audiodestrukt/freedj-esp/p4/deck/hardware/cad/renders/freedj_esp/INDEX.md

# freedj-esp render log

- 0001-first-design-hero.jpg: 2026-10-31: first design, 3.5" LCD, 100 mm jog, CUE/PLAY, 45 mm pitch
- 0002-first-design-front.jpg: 2026-10-31: same, from the front
- 0003-first-design-jog-section.jpg: 2026-10-31: section through the jog axis (two 608s, shaft, magnet over the MT6701 board)
- 0004-flat-top-hero.jpg: 2026-10-31: flat-top configuration (machine_flat.py): screen flat in the top, prints with no supports
- 0005-4in-angled-hero.jpg: 2026-10-31: redesigned around the 4" MSP4021 we have: 160 x 205 mm, glass flush in the top, clamped from behind
- 0006-4in-angled-front.jpg: 2026-10-31: same, from the front
- 0007-4in-flat-hero.jpg: 2026-10-31: 4" flat-top version (print this one first)
- 0008-4in-flat-front.jpg: 2026-10-31: same, from the front
- 0009-compact-angled-front.jpg: 2026-10-31: compacted: 8 mm from jog well to glass, jog and buttons 5 mm forward, brand moved onto the bezel. Angled 160 x 184.7 mm
- 0010-compact-flat-hero.jpg: 2026-10-31: same, flat-top, 160 x 186.3 mm
- 0011-compact-angled-hero.jpg: 2026-10-31: same, angled, hero angle
- 0012-compact-flat-front.jpg: 2026-10-31: same, flat-top, from the front
- 0013-screen-bosses-underside.jpg: 2026-10-31: flat shell from below: 4 screen bosses on the module's 102.00 x 54.88 hole pattern (clamps gone)
- 0014-screen-mounted-underside.jpg: 2026-10-31: same, with the module board screwed on (M3 x 5 thread-formers)
- 0015-recessed-screen-flat-front.jpg: 2026-10-31: screen recessed behind the top; a chamfered window shows only the active area (off-centre, as on the panel)
- 0016-recessed-screen-angled-hero.jpg: 2026-10-31: same, angled
- 0017-window-and-bosses-underside.jpg: 2026-10-31: from below: the window and 4 screen bosses coming down to the board
- 0018-section-through-screen-boss.jpg: 2026-10-31: section through a boss: top, glass, board, M3 screw in the pilot
- 0019-renamed-freedj-esp.jpg: 2026-10-31: renamed to freedj-esp: FREEDJ-ESP engraved on the bezel
- 0020-devboard-rear-ports.jpg: 2026-10-31: Waveshare dev board mounted back-right: Ethernet + 2 x dual USB-A out the rear, USB-C out the right side; RCA moved left
- 0021-devboard-inside.jpg: 2026-10-31: inside (shell hidden): dev board on base-plate standoffs under the screen
- 0022-centred-window-front.jpg: 2026-10-31: screen window centred on the deck and over the jog (module shifted 2.88 mm to compensate)
- 0023-corner-bosses-underside.jpg: 2026-10-31: base fixing: a short boss in each of the 4 corners; dev board moved left to clear the back-right one
- 0024-printed-shaft-as5600-section.jpg: 2026-10-31: jog section (flat): shaft printed with the platter, e-clip under the lower 608, magnet flush in the shaft tip 1.1 mm over an AS5600 board lying on the base, right-angle header pointing back, tails in a base slot
- 0025-encoder-on-bosses-section.jpg: 2026-10-31: e-clip dropped: shaft ends just under the lower 608, magnet flush in its tip 1.1 mm over the AS5600, board on 2.3 mm bosses; plug clears the bearing boss by 0.6 mm
- 0026-encoder-bosses-base.jpg: 2026-10-31: base plate under the jog: four 2.3 mm bosses on the AS5600's 5/8" hole square, tail pockets under both pin columns (one notches a boss)
- 0027-encoder-board-on-bosses.jpg: 2026-10-31: the AS5600 board (15/16" square, from Dan's ruler + listing photo) on the bosses, right-angle headers pointing out to both sides
- 0028-pitch-pot-slot-countersinks.jpg: 2026-11-01: PTA4543 pitch pot: slot cut to 49.6 mm, flush M2 countersinks 56 mm apart at its ends, ticks over the 45 mm travel, knob 1 mm above the top on the metal lever
- 0029-control-board-section.jpg: 2026-11-01: section at the jog axis looking left: the control board under CUE / PLAY, ring LEDs on top, three JST-XH connectors underneath
- 0030-button-stack-section.jpg: 2026-11-01: section through PLAY and CUE: cap flange (chamfered) under the ring tube, nub on the 12 x 12 tact switch, ring skirts down to the control board, which holds both in
- 0031-60mm-pitch-fader.jpg: 2026-11-01: PTA6043 (60 mm) fader: 64.6 mm slot, flush M2 screws 71 mm apart, ticks and the tempo LED moved in off the edge round
- 0032-plain-buttons-section.jpg: 2026-11-01: plain buttons (no light rings): 22 mm caps fill the holes, 23.6 mm flanges under the top, nubs on the tact switches
- 0033-cdj-style-knob.jpg: 2026-11-01: CDJ-style tempo knob: tapered body, concave finger scoops front and back, flat top with a white index line
- 0034-populated-ctrl-board.jpg: 2026-11-01: the populated control board from tscircuit's GLB (real JLCPCB/EasyEDA part models), switches corrected to their 7.5 mm height
- 0035-populated-board-in-deck-section.jpg: 2026-11-01: section through PLAY and CUE (flat shell): cap nubs on the real switches, ring skirts on the board over the LEDs, boss on the board; ctrl_fit.py found no clashes in either config with lit or plain buttons
- 0036-a1s-compact-hero.jpg: 2026-11-06: FREEDJ_BOARD=a1s: the compact deck for the ESP32-A1S Audio Kit and the 2.8": 80 mm platter, 140 x 154.1 x 32 mm (OpenSCAD preview; Blender segfaulted)
- 0037-a1s-compact-rear.jpg: 2026-11-06: A1S deck from the back: the two 3.5 mm jacks through the rear wall (placeholder positions until the board is measured)
- 0038-a1s-compact-inside.jpg: 2026-11-06: A1S deck without the shell: the A1S (placeholder outline) back-right under the 2.8" module, micro-USBs toward the right wall
