audiodestrukt/freedj-esp/p4/deck/hardware/cad/renders/esp_deck/0001-first-design-hero.jpg

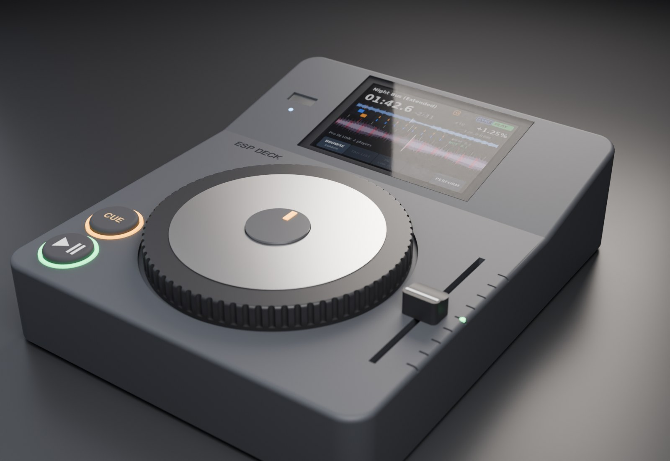
p4/deck/hardware/cad/renders/esp_deck/0001-first-design-hero.jpg
