audiodestrukt/freedj-esp/p4/deck/hardware/cad/renders/esp_deck/0006-4in-angled-front.jpg

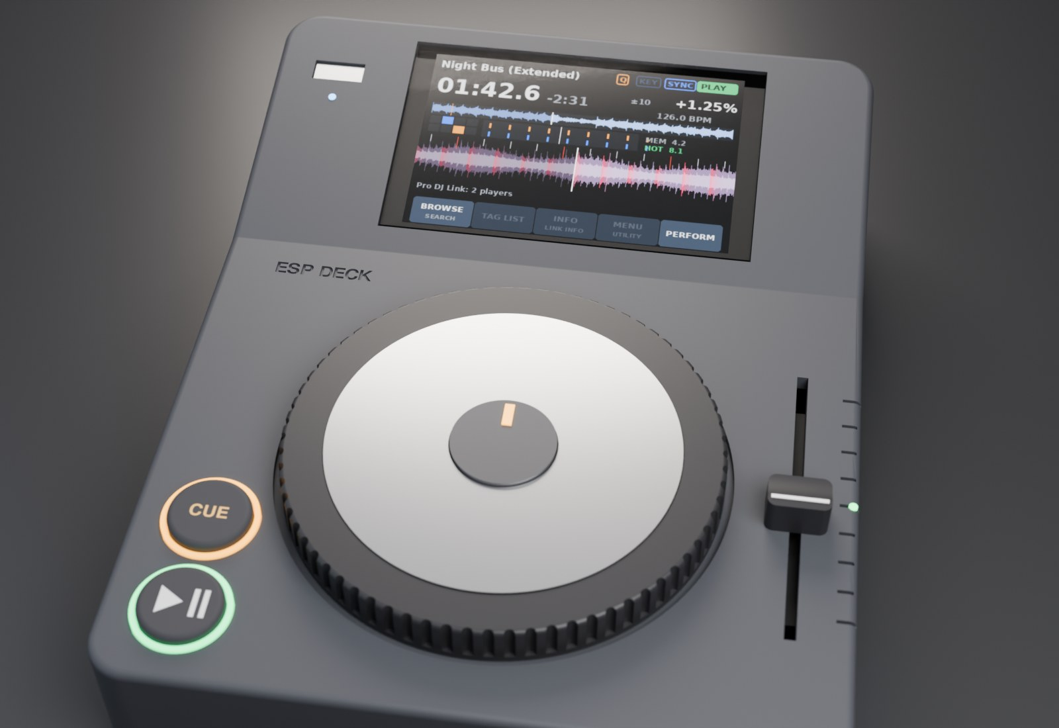
p4/deck/hardware/cad/renders/esp_deck/0006-4in-angled-front.jpg
