audiodestrukt/freedj-esp/p4/deck/hardware/cad/renders/esp_deck/0007-4in-flat-hero.jpg

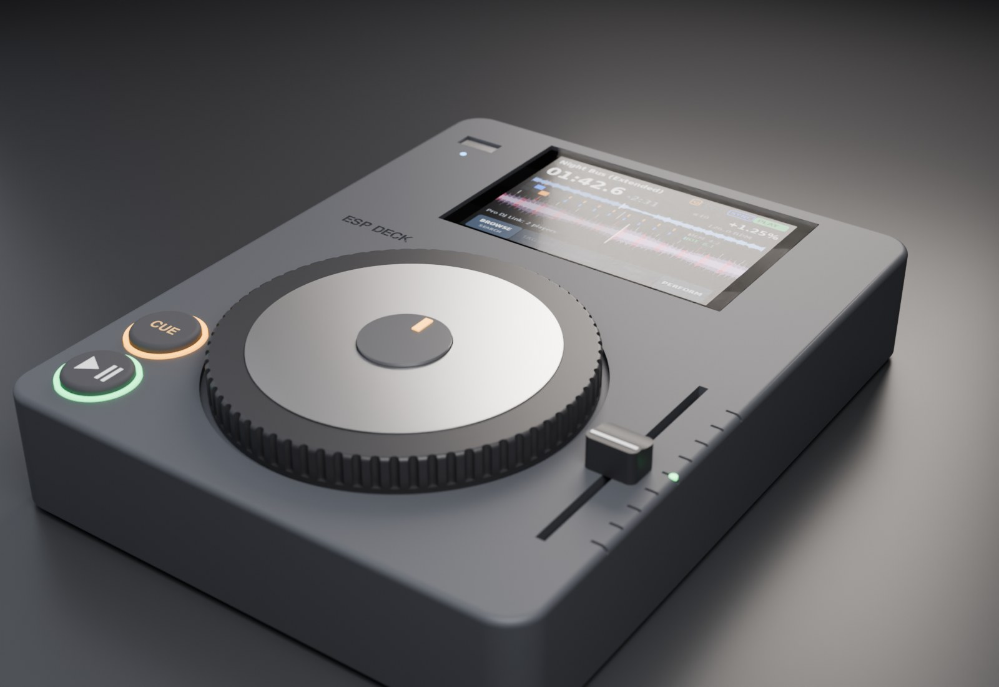
p4/deck/hardware/cad/renders/esp_deck/0007-4in-flat-hero.jpg
