audiodestrukt/freedj-esp/p4/deck/hardware/cad/renders/esp_deck/0010-compact-flat-hero.jpg

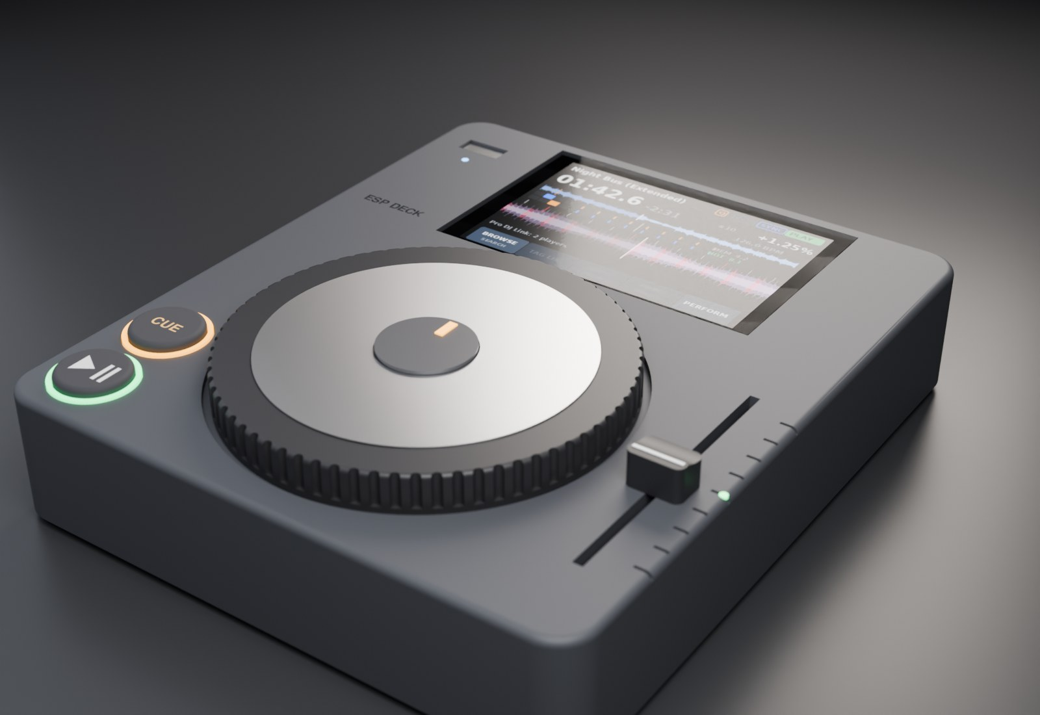
p4/deck/hardware/cad/renders/esp_deck/0010-compact-flat-hero.jpg
