audiodestrukt/freedj-esp/p4/deck/hardware/cad/renders/esp_deck/0014-screen-mounted-underside.jpg

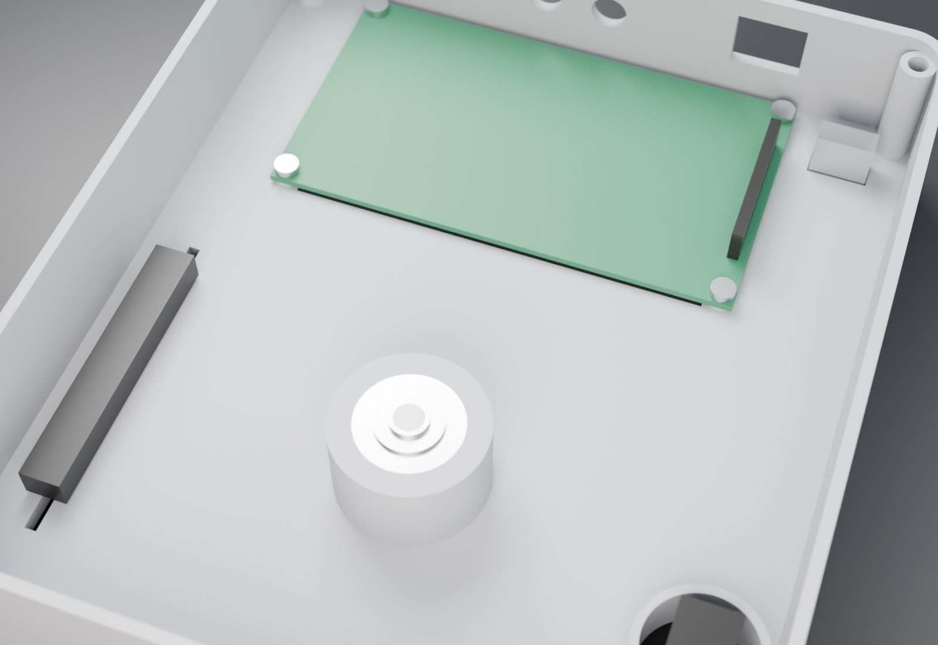
p4/deck/hardware/cad/renders/esp_deck/0014-screen-mounted-underside.jpg
