audiodestrukt/freedj-esp/p4/deck/hardware/cad/renders/freedj_esp/0002-first-design-front.jpg

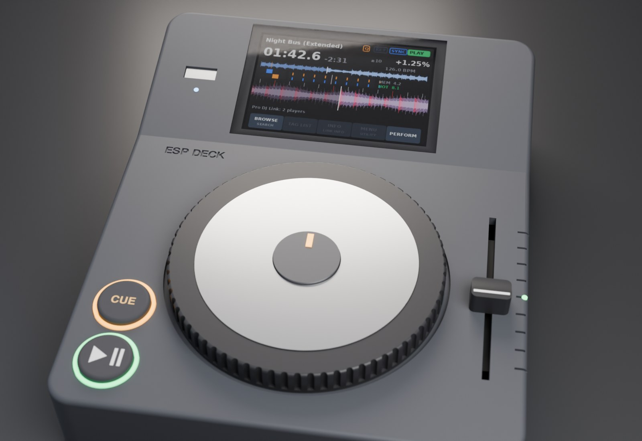
p4/deck/hardware/cad/renders/freedj_esp/0002-first-design-front.jpg
