audiodestrukt/freedj-esp/p4/deck/hardware/cad/renders/freedj_esp/0003-first-design-jog-section.jpg

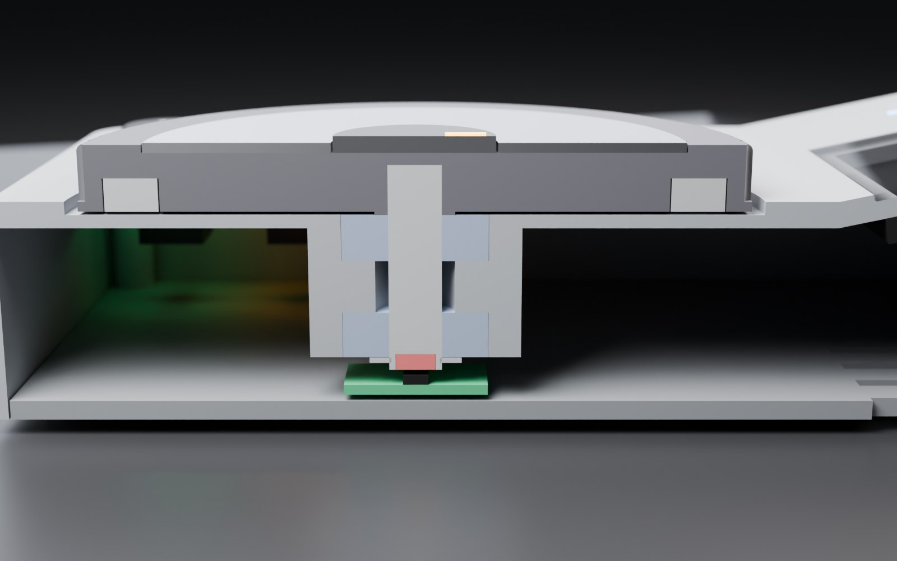
p4/deck/hardware/cad/renders/freedj_esp/0003-first-design-jog-section.jpg
