audiodestrukt/freedj-esp/p4/deck/hardware/cad/renders/freedj_esp/0008-4in-flat-front.jpg

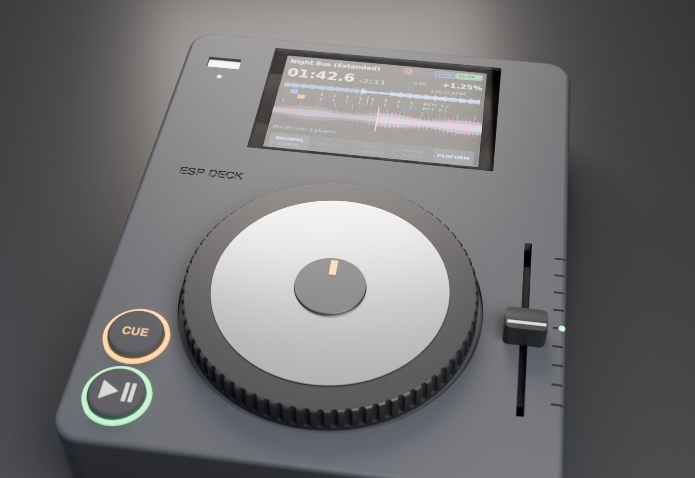
p4/deck/hardware/cad/renders/freedj_esp/0008-4in-flat-front.jpg
