audiodestrukt/freedj-esp/p4/deck/hardware/cad/renders/freedj_esp/0009-compact-angled-front.jpg

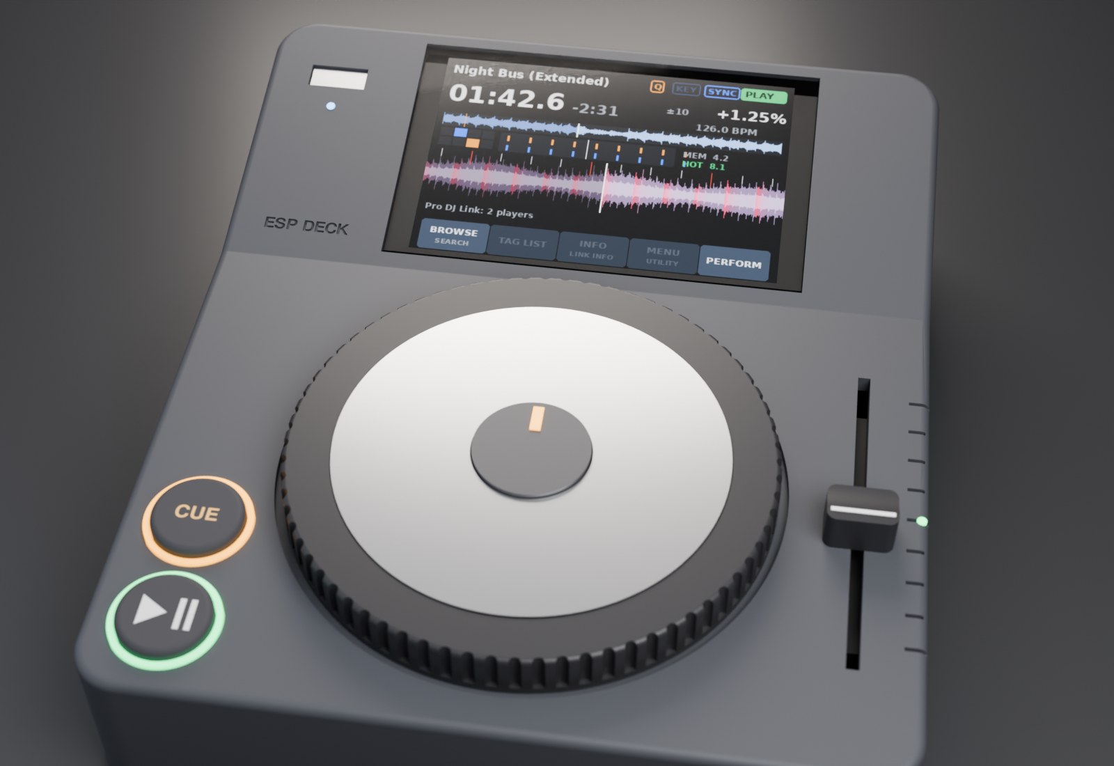
p4/deck/hardware/cad/renders/freedj_esp/0009-compact-angled-front.jpg
