audiodestrukt/freedj-esp/p4/deck/hardware/cad/renders/freedj_esp/0013-screen-bosses-underside.jpg

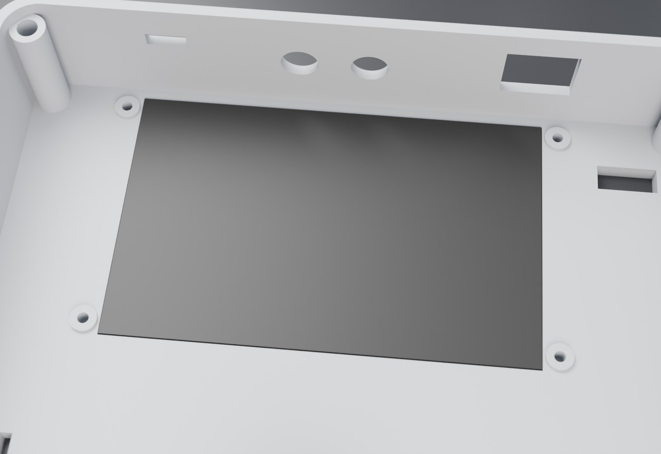
p4/deck/hardware/cad/renders/freedj_esp/0013-screen-bosses-underside.jpg
