audiodestrukt/freedj-esp/p4/deck/hardware/cad/renders/freedj_esp/0022-centred-window-front.jpg

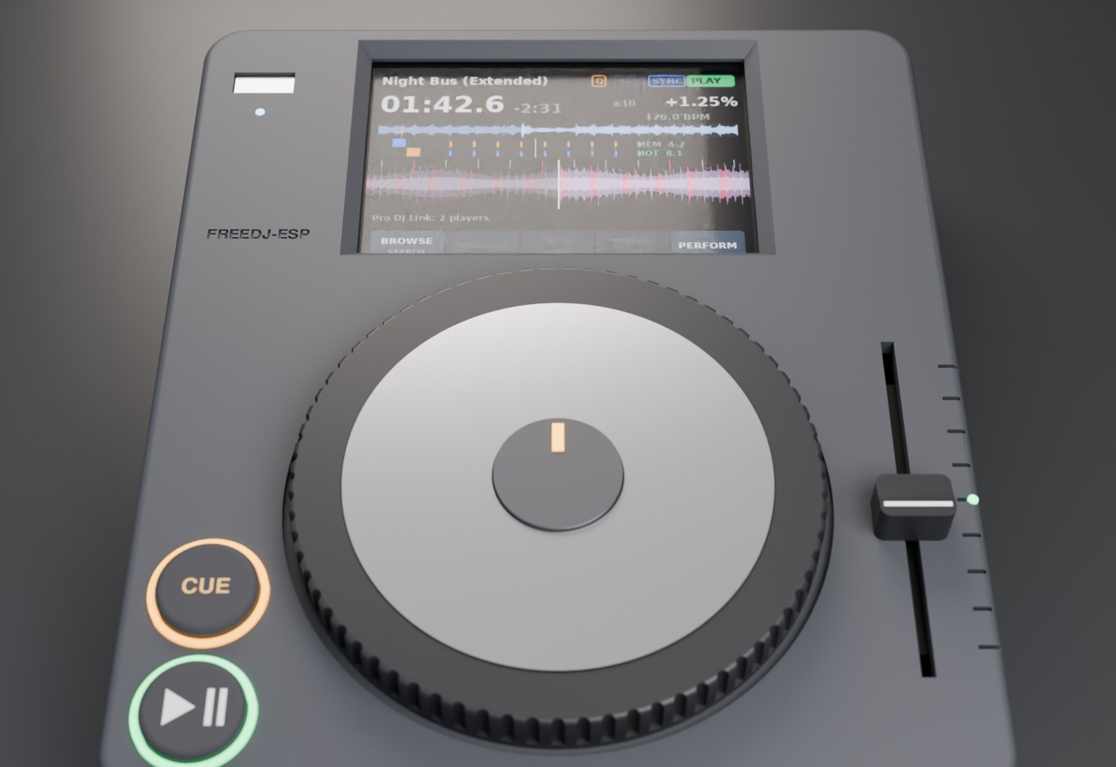
p4/deck/hardware/cad/renders/freedj_esp/0022-centred-window-front.jpg
