audiodestrukt/freedj-esp/p4/deck/hardware/cad/renders/freedj_esp/0023-corner-bosses-underside.jpg

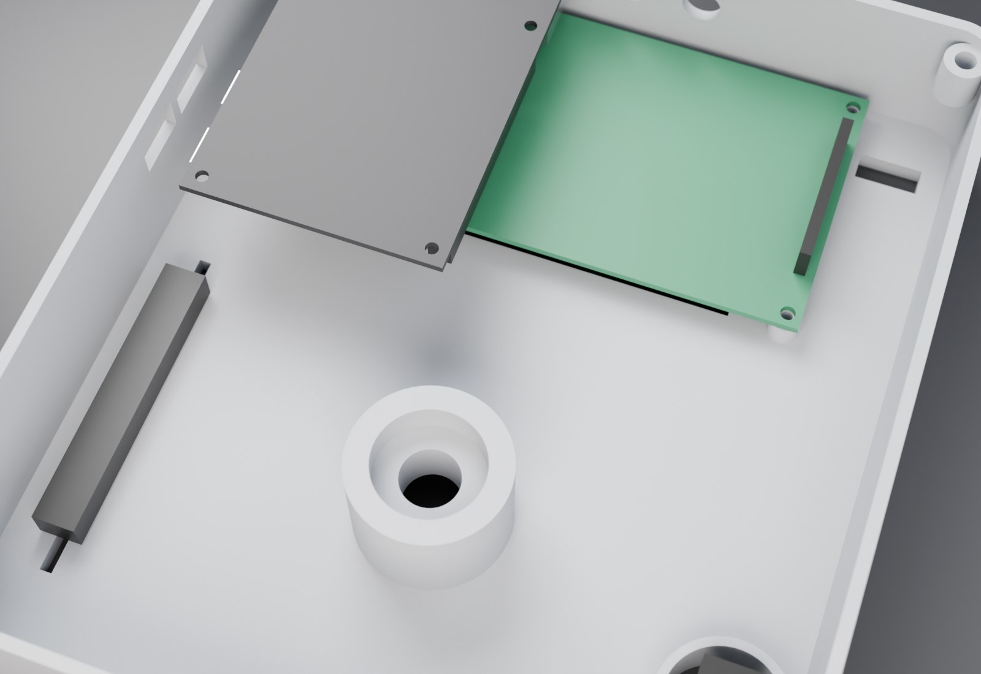
p4/deck/hardware/cad/renders/freedj_esp/0023-corner-bosses-underside.jpg
