audiodestrukt/freedj-esp/p4/deck/hardware/cad/renders/freedj_esp/0026-encoder-bosses-base.jpg

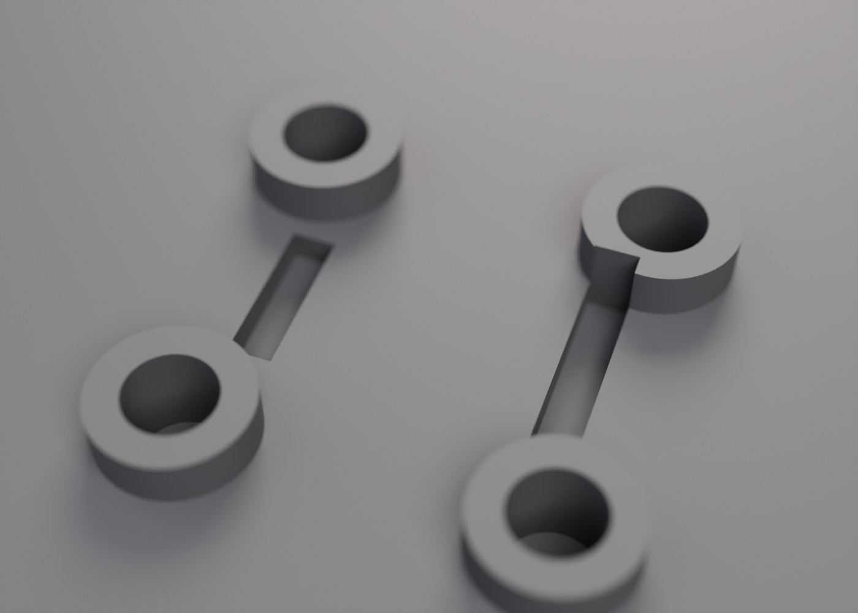
p4/deck/hardware/cad/renders/freedj_esp/0026-encoder-bosses-base.jpg
