audiodestrukt/freedj-esp/p4/deck/hardware/cad/renders/freedj_esp/0028-pitch-pot-slot-countersinks.jpg

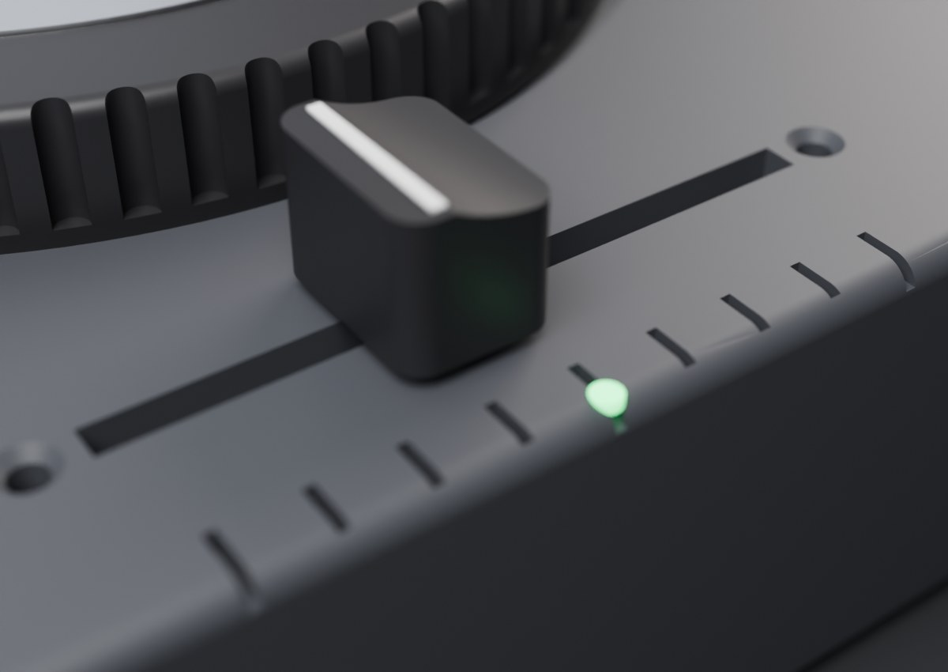
p4/deck/hardware/cad/renders/freedj_esp/0028-pitch-pot-slot-countersinks.jpg
