audiodestrukt/freedj-esp/p4/deck/hardware/cad/renders/freedj_esp/0029-control-board-section.jpg

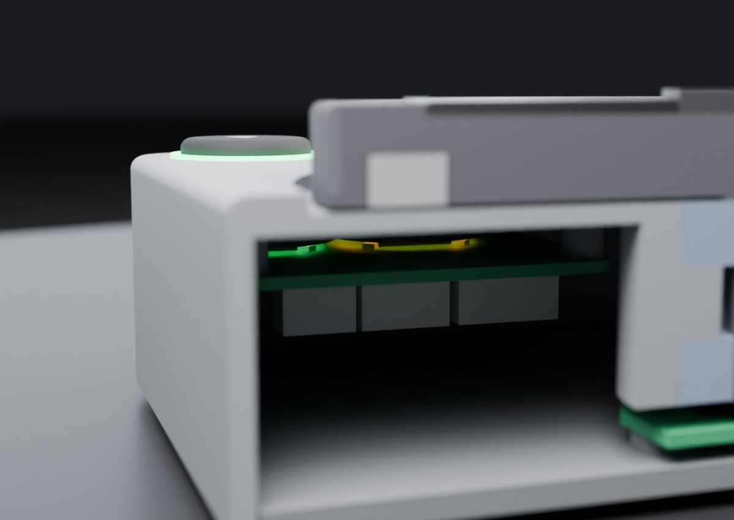
p4/deck/hardware/cad/renders/freedj_esp/0029-control-board-section.jpg
