audiodestrukt/freedj-esp/p4/deck/hardware/cad/renders/freedj_esp/0037-a1s-compact-rear.jpg

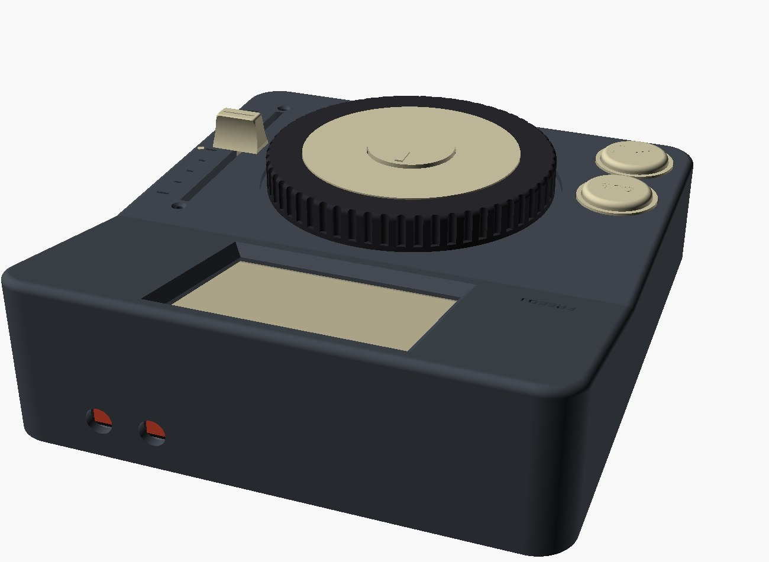
p4/deck/hardware/cad/renders/freedj_esp/0037-a1s-compact-rear.jpg
