audiodestrukt/freedj-esp/p4/deck/hardware/cad/renders/freedj_esp/0038-a1s-compact-inside.jpg

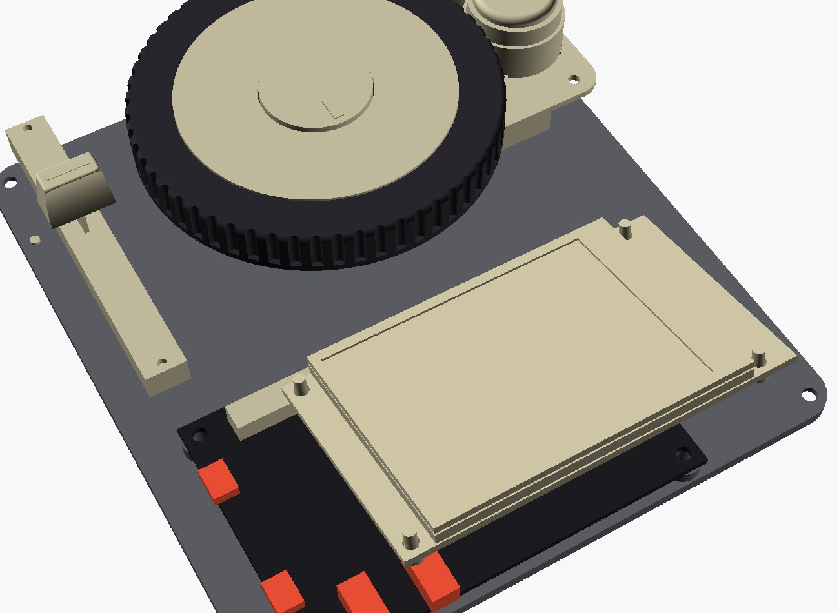
p4/deck/hardware/cad/renders/freedj_esp/0038-a1s-compact-inside.jpg
