audiodestrukt/freedj-esp/p4/deck/hardware/ctrl-pcb/fab/freedj-ctrl-bom.csv

Comment | Designator | Footprint | JLCPCB Part #
CH32V003F4P6 | U1 | TSSOP-20 | C5187096
100nF | C1,C_POT | 0603 | C14663
10uF | C2 | 0805 | C15850
10k | R_NRST,R_INT | 0603 | C25804
1k | R_POT | 0603 | C21190
4.7k | R_SDA,R_SCL | 0603 | C23162
ZX_QC66_7_5TP | SW_PLAY,SW_CUE | SMD 6x6 tact | C7470157
LED green | D_PLAY1,D_PLAY2,D_PLAY3,D_PLAY4 | 0805 | C2297
100 | R_PLAY1,R_PLAY2,R_PLAY3,R_PLAY4 | 0603 | C22775
LED yellow | D_CUE1,D_CUE2,D_CUE3,D_CUE4 | 0805 | C2296
470 | R_CUE1,R_CUE2,R_CUE3,R_CUE4 | 0603 | C23179
