audiodestrukt/freedj-esp/p4/deck/hardware/ctrl-pcb/fab/freedj-ctrl-handsolder.csv

Designator | Part | LCSC | Note
J_POT | B3B_XH_A_LF__SN_ | C144394 | JST-XH, solder the housing on the BOTTOM side (outline on the bottom silkscreen)
J_ENC | B5B_XH_A_LF__SN_ | C157991 | JST-XH, solder the housing on the BOTTOM side (outline on the bottom silkscreen)
J_HOST | B5B_XH_A_LF__SN_ | C157991 | JST-XH, solder the housing on the BOTTOM side (outline on the bottom silkscreen)
