audiodestrukt/freedj-esp/p4/deck/CHANGELOG.md

# P4 deck changelog

Newest first. Each entry lists what changed, then the resource budget measured
at that point, so the cost of every feature stays on record. The current
budget is also in [README.md](README.md#resource-budget).

How the numbers are measured: the deck prints a report every 2 s while
playing (see the README's *Audio health* section). Unless noted, it's
`house.mp3` (256 kbps, 2:15) from the SD card, playing with the waveform up.
**Frame rates before 2026-10-31 counted waveform redraws, not frames sent to
the panel**, so they read high. From 2026-10-31 on, "screen fps" counts
frames LVGL actually rendered and flushed.

## 2026-11-06 (later): CAD: SC6080GH pitch fader (`FREEDJ_POT=sc6080`, A1S default)

- SC6080GH B10K 15C from its drawing: same 75 × 9 frame, M2 holes 71 apart and 60 mm travel as
  the PTA6043, so the slot (64.6) and countersinks stay. Its lever's 5 mm-wide foot (5 above the
  frame) rose 2 mm into the top plate and hit the slot ends at full travel, so it hangs on 5.2 mm
  pads (3 for the PTA): no contact at either end of travel. M2 × 10 screws. Knob socket follows
  the lever (1.6 for its 1.2 lever): `slider_knob_sc6080.stl`; 4.8 mm of lever in the knob.
  Pads stop 0.5 short of the lever foot. P4 shell unchanged.

## 2026-11-06 (later): CAD: panel-mount buttons (`FREEDJ_BUTTONS=panel`)

- Bought 16 mm panel-hole pushbuttons (0.75" top) in plain 16.25 mm holes, nut under the top.
  No control board or bosses in this mode (the button bodies take its space); buttons and fader
  wire to the main board. Buttons at x 17.5 (16 otherwise): PLAY's body clears the corner post
  by 0.6 mm. Shell only, `*_panel.stl`; no clashes with the shell, base or A1S in any of the
  four shells. Lit and plain shells unchanged.

## 2026-11-06 (later): CAD: compact A1S deck (`FREEDJ_BOARD=a1s`)

- A deck variant for the ESP32-A1S Audio Kit and the 2.8": **140 × 154.1 × 32 mm** angled
  (155.4 deep flat), against 160 × 174.1 × 34 for the P4 2.8". 80 mm platter (84 mm well),
  same shaft, bearings, encoder, buttons, control board and slider. Height is set by the
  bearing stack (2.1 mm between the 608s). No USB-A stick slot or RCA; the A1S's jacks go out
  the rear wall and its micro-USBs out the right.
- **A1S dimensions are placeholders** (no published drawing): one table in `a1s_board.py`,
  which also prints a clash check (0 with the placeholders, both versions).
- Width now derives from the jog and slider (`W = SLIDER_X + 14`); the P4's port cutouts and
  vents moved from `shell.py` / `base.py` into `devboard.py`. P4 shell, base and platter are
  unchanged in all four configurations (volumes and bounding boxes identical). No firmware
  change.

## 2026-11-06 (later): browse with the jog and PLAY

- With the track list on screen, the jog scrolls it (`kBrowseTicksPerRow` 6: 30 rows per turn on
  the AS5600) and PLAY loads on release; the waveform comes back as soon as the track loads.
  Hold PLAY and turn the jog to bring the list up from anywhere (the first tick undoes the
  press). For selecting tracks with touch not wired. No budget change: image 1,477,856 B (−96).

## 2026-11-06: THRU (a real record through the interface); DJ2Go pitch bend − toggles it

- **THRU**, Serato's fourth mode: the timecode chip (or serial `V`) now cycles ABS → REL → INT →
  THRU. The USB interface's input goes straight to the output, through the deck's volume; the
  deck holds its place and the decoder stops. Chip blue. The input queue is held at 512 frames
  (~12 ms) and a block reads one frame more or less when the average strays 64 frames (the
  interface's clock isn't ours). ~9 min of THRU with a real record: 193 trimmed blocks, 10
  dropouts (re-primed; clustered, one USB transfer error in that time), none in the last 90 s.
- **DJ2Go pitch bend −** toggles THRU while a USB audio input streams (back to the mode it came
  from), so records swap without the touch screen. Without an interface it's key lock as before;
  serial `k` still toggles key lock.

Budget (THRU, the record playing): audio block work avg 0.64 / max 1.64 ms (budget 5.8), core 0
64 %, core 1 12 %, 34.5 fps. Image 1,477,952 B (+1,024).

## 2026-11-05 (later): needle drops land clean; record start; USB input recovers

- **Needle drops**: a carrier gap of 150 ms or more is a lift. On landing the decoder resets
  (a lingering lock had seeked back to the old spot) and the deck holds silent until bit lock
  gives a position, at most 1 s, instead of scratching the old spot on landing noise. 12
  drops: lock in 104-480 ms (typically ~215); 3 missed (two lifted again within 50-160 ms,
  one timed out) and followed speed.
- **Re-sync**: a steady error of 25-300 ms that holds for 200 ms re-syncs, if the audio there
  is decoded. Before, anything under 300 ms stayed: the track sat ~0.3 s behind after MP3
  seeks that waited for the decoder, and after scratches. Now within 0-25 ms in steady play
  (re-syncs fire about once a minute). The playhead aims 60 ms ahead of the record for the
  output delay (estimated).
- **Record start**: the first groove of our Serato Control Vinyl reads 24.0-24.3 s of
  timecode (three drops), so 24.0 s is track 0:00 (Serato's absolute mapping). Serial `Z`
  sets it for another record.
- **USB input recovers from a transfer error**: after ~220 s the PCM2902 sent one overflow
  (status 5), the endpoint halted, and vinyl stopped for good. The last failed transfer now
  queues a flush/clear/resubmit on the device task; restarts are counted in the vinyl line.
- Image 1,476,080 B (+2,896). No change to the steady-state budget (no new tasks or buffers).
- **Timecode chip, ABS / REL / INT** (Serato's modes): its own header chip left of Q, shown
  only while a USB audio input streams; tap or serial `V` to cycle. The state chip is
  PLAYING / PAUSED again (it had read VINYL). INT keeps the record's last speed until the
  fader moves. Without an interface the header is unchanged.
- **Jog scratches while the record is stopped**: in vinyl mode the deck counts as playing, so
  the jog was a nudge, and vinyl zeroes nudge: it did nothing. The record moving takes over again.
- Image 1,476,928 B (+848).

## 2026-11-05: timecode vinyl over a USB audio interface; looser jog filter

- **Timecode vinyl on the P4.** The USB audio driver now also reads a UAC1 interface's line
  in (isochronous IN, 16/24/32-bit, first two channels), preferring the output's rate so the
  interface runs one clock. A decoder task (`vinyl.cpp`, core 0) feeds it to the A1S's
  timecode decoder, now built without Arduino (a logging/clock shim; the A1S build and the
  host tests are unchanged). Serato Control Vinyl.
  - Once it hears 0.3 s of steady carrier at 0.6-1.5x, the record sets speed and direction
    (tempo fader, nudge and SYNC drop out; keylock gives way to varispeed below 0.5x and in
    reverse). It never takes over from an interface used only for output.
  - Absolute mode (default, serial `A`): needle drops seek when the track is 300 ms off the
    record, at most every 250 ms (the A1S numbers). Untested on a real drop yet.
  - The 3 MB position table is built at task start (464 ms), not on the first decode; that
    first decode had dropped ~400 input frames.
  - Tested with a PCM2902 interface (UCA202 type) and a turntable: carrier in 0.6 s after
    boot, 1.002-1.012x at 33, bit lock, 0 input errors. At 45 it reads 1.341x.
  - State chip VINYL (green moving, orange stopped). Serial `V` on/off, `f` decoder flags,
    `L` status.
- **Jog filter loosened.** `R` at rest now reads 0 counts of spread (was ~±100), so
  `kMinCutoff` 1 -> 30 Hz and `kDeadband` 3 -> 1 tick. Simulated: first tick after a start
  88 -> 38 ms; a 4 Hz ±40° scratch trails by 3.1 ticks at worst (was 10.7). 0 stray ticks in
  12 s at rest on the deck.
- Budget, against the previous commit on the same bench (amen-16.wav from SD, USB interface
  attached, record not spinning, waveform up):
  - core 0 59-60 % (was 55-56 %; decoding the input), core 1 8 % (unchanged);
  - internal RAM 56-59 KB free, lowest 43-46 KB (was 59-66, lowest 52): the decoder task's
    stack and the input transfers;
  - PSRAM 16,446 KB free (was 19,554): the position table;
  - image 1,473,184 B (+8,864).
  - The README budget (2026-10-31) predates the USB interface, which costs core 0 on its own
    while it streams.

## 2026-11-04: 2.8" screen option (MSP2834, 320x240)

- CAD: `FREEDJ_SCREEN=2.8` builds the deck around LCDwiki's MSP2834 (Hosyond 2.8" IPS,
  ILI9341V, FT6336G), from its drawing. 160 x 174.1 mm angled, 175.4 flat (184.7 / 186 with
  the 4"); width and height unchanged. M2.5 screws in 5.6 mm bosses (the holes are 3.4 mm
  past the glass ends; 0.6 mm clear). The board and hole pattern can now sit off the glass
  centre (`LCD_PCB_DX`, `LCD_HOLES_DX`): on this module the glass is 4 mm nearer the hole end.
  Files `*_28.stl`. Dev board, shell, pot and screen module: no clashes in either version.
  The 4" geometry is unchanged.
- Firmware: a build option, `CONFIG_FREEDJ_SCREEN_28` (`sdkconfig.defaults.screen28`, built
  into `build28/`). ILI9341V driver with inverted colours (LCDwiki's init sends INVON), same
  pins, same touch driver. The UI's positions and fonts come from one block per screen: same
  bands at about the same physical size (the panels are ~5.6-5.75 px/mm); time in Montserrat
  32, labels 12, touch keys 10 (PERFORM is 63 px at 12, the keys 60); label widths checked
  against the fonts' advance tables. PERFORM pads 6 x 4, over the time row. Not run on the
  panel yet: rotation and inversion may need flipping.
- `CONFIG_FREEDJ_SCREEN_PREVIEW` (`sdkconfig.defaults.preview28`, `build28p/`): the 2.8" layout
  in the top-left 320x240 of the 4" panel, at nearly its real size. Boots and draws on the
  bench deck (touch not wired on the bench right now, so untested; the deck runs without it).
- Budget: 4" image +48 bytes (1,464,320), behaviour unchanged. 2.8" image 1,468,224 bytes;
  half the pixels per frame, not measured yet.

## 2026-11-04: Link on a direct cable; steady tempo display while synced

- Tested on a cable straight to an XDJ-1000MK2: link-local 169.254.x.x in ~9 s, XDJ found
  as player 1, beat sync tracks.
- Fix: the XDJ gave a link error. Our status packets (copied from an XDJ with a stick in)
  said our USB was loaded (byte 0x6f = 0x00), so the XDJ offered it under LINK and tried to
  browse it; we serve neither media queries nor the dbserver. USB and SD now read as empty
  (0x6a/0x6b/0x6f/0x73 = 0x04, 0x75 = 0).
- The tempo % and BPM on screen show the synced tempo (master BPM / track BPM), not the
  playback speed: that adds sync's phase bend (up to +-3 %) and jumped around.
- The phase bend itself is low-passed (~0.3 s, `kSyncBendSmooth`), so beat-packet jitter
  doesn't wobble the speed. Phase error not re-measured yet.
- Budget unchanged (a few float ops per block).
- DJ2Go pitch bend − / + now toggle key lock / the beat meter view (they were LOOP IN / OUT; the
  DJ2Go has no loop buttons). New `deck::Type::MeterView`, handled on the USB task.

## 2026-11-03: platter held captive by an e-clip (CAD only)

- The lower 608 moves up 3.9 mm in the shell's boss (bottom face z 10.0 -> 13.9), which
  leaves 4.4 mm of shaft below it. There's a DIN 6799 size-6 e-clip groove at z
  13.10-13.85 (6.0 mm, 0.75 wide, 0.05 under the bearing face). Below that, 1.5 mm of solid
  shaft, then the magnet pocket. Hub on the upper inner race, clip on the lower one: the
  platter can't lift out.
- Bearing span 22.1 mm flat / 18.1 mm angled (was 26.0 / 22.0); 8.1 / 4.1 mm between the
  bearings.
- Shaft tip, magnet, air gap (1.1 mm) and encoder bosses are unchanged, as is the shaft
  length (28.0 flat / 24.0 angled). Reprint the shell and the platter. The base plate
  is unchanged.
- No firmware change, so the budget is unchanged.

## 2026-11-03: CUE, PLAY and pitch wired straight to the P4 (no control board)

- New `panel_gpio.cpp` (release 1 in BUILDS.md): CUE on GPIO 24, PLAY on 25, buttons to GND
  with internal pull-ups, 6 ms debounce; pitch slide pot wiper on GPIO 22 (ADC1 ch 6), ends
  on 3V3/GND. Sends the same Cue / PlayPause / TempoFader events as the DJ2Go. Serial `P`.
- GPIO 24/25 are the USB serial/JTAG pins. Its secondary console is now off (we use UART0 via
  the CH343); setting the pins as GPIO turns the USB pad off.
- **Pitch noise.** The ADC at rest reads +-60 counts; a 3-count threshold sent ~100 tempo
  changes a second (2251 in 20 s). Now: 8 reads averaged every 20 ms, a low-pass that's slow
  at rest (~0.5 Hz) and fast only after 3 reads in a row > 40 counts away (~6 Hz), and a
  12-count send threshold. At rest: filtered +-10, nothing sent; a full sweep: ~220 updates.
- **Range:** the test fader's top end read 3292, not ~4095. The range starts at 300..3000 and
  widens to what the pot reaches, so one full sweep gives 0..1.
- The fader is ignored until it moves 200 counts from where it was at boot, so a floating
  pin can't set the tempo and the DJ2Go's fader still works.
- 16 reads every 10 ms cost about as much core 0 time as LVGL; cut to 8 every 20 ms.

## 2026-11-02: XDJ-1000MK2 as a controller (USB MIDI)

- **What the player presents over USB:** standard USB MIDI, a HID interface, USB audio
  out (the P4 could play through it) and a USB network adapter.
- **To use it:** on the XDJ, CONTROL MODE → USB MIDI, then push to connect. It then
  sends the MIDI messages listed in its manual (p. 37).
- New `src/xdj_midi.cpp`, built for both the host and the target:
  - PLAY/CUE, tempo slider, rotary browse/load/back.
  - Hot cues A–H, memory/call, loops and beat loops, beat jump ±1–32.
  - Quantize, slip, sync, tempo range, master tempo, reverse.
  - The jog sends a speed (64 = stop) about every 18 ms, for the top (0.06–4×) and the
    rim (0.5–4×). That becomes jog ticks (10 ms of track each), with the remainder
    carried over.
- **Which map is used:** `usb_midi` remembers the MIDI device's vendor ID, so Pioneer
  (0x2B73) gets the XDJ map and everything else gets the DJ2Go map.
- `native/xdj_test`: 18 checks, all passing.
- **New serial key `I`:** raw MIDI log. Every USB device that enumerates now logs its
  interfaces and endpoints.
- Confirmed working on the XDJ-1000MK2, 2026-11-02.
- **Output routing:** the P4's own output now always plays. A USB sound card (such as the
  XDJ) gets a copy; before, the P4's output went silent while one was attached.

## 2026-11-02: Jog holds still on a noisy sensor

- **The problem:** after reassembly the AS5600 read about ±100 counts (±4 ticks) at rest,
  even with a strong field (AGC 2–8).
  - Back-to-back reads 0.3 ms apart jump 65–130 counts. That's the chip's own output, not
    the bus: 100 kHz I2C is just as noisy.
  - Paused, those ticks scrubbed the audio (crackle), and the waveform jittered.
  - Cause, found afterwards: the breakout's **DIR pin had come off GND**, and the deck's
    **small speaker sat right next to the sensor**. The first I2C bring-up read ±1.
- **The fix:** the jog filter is rebuilt, tuned offline on `R` captures:
  - Smoothing is 1 Hz at rest, rising 0.15 Hz per tick/s.
  - Speed comes from a 5 Hz low-pass over 100 ms.
  - A 3-tick deadband to start or reverse; once moving, every tick goes out.
  - I2C sample = two reads, averaged.
- **Measured on the deck:** 0 stray ticks in 20 s at rest. In simulation on the captures,
  a spin stays within 1–2 ticks, with up to ~5 ticks of lag at the start of a move.
- Read time 177 → ~350 us per sample (two reads), ~2 % more of core 0.
- `E` (probe) also prints 16 back-to-back raw reads.
- Jog direction: briefly flipped (`kDirection` -1) while DIR was floating, then set back to +1.
  With DIR grounded, the original sign was right: spinning right advances the track.

## 2026-11-02: Real magnet size, gap test prints (CAD only)

- `MAGNET` is now **Ø4 × 2 mm**, measured; it was a guessed 6 × 1.6. The shaft's pocket is
  now 2.1 deep, so the magnet sits flush and centred. The old pocket left it 0.6 mm
  recessed and up to 1.5 mm off the axis.
- Stacking magnets to bridge the gap made it worse:
  - At rest the angle wandered 2048–2803, in 94-count steps.
  - About ±6 jog ticks of noise, which crackled while paused.
  - Stacked diametric discs snap together with opposite poles, so their in-plane fields cancel.
- New `jog_test_1_1/0_8/0_5.stl` from `jog.py`: a 1" × 2 mm disc on the real shaft, with
  the tip lengthened so the magnet sits 1.1, 0.8 or 0.5 mm from the chip. The gap is
  engraved on top. Print all three and choose by AGC and the `R` spread.
- Pocket Ø4.15 × 2.1 deep (`MAGNET_FIT` 0.15, plus `MAGNET_GLUE` 0.1 so a film of glue doesn't push it proud). It's a Ø4 magnet, not Ø3: a Ø3.05 pocket was too small.
  New `magnet_gauge.stl`, holes Ø4.1–4.4 labelled 10–40 (hundredths over 4 mm), to tune it.
- **Print the files that match the shell.** The flat case's shaft is 27.0 mm (1-1/16", which
  matches the measured bore) and the angled case's is 23.0. `FREEDJ_CONFIG=flat python3 jog.py`
  writes `jog_test_*_flat.stl` and `platter_flat.stl`. An angled shaft in the flat shell
  stops 4 mm short of the chip.
- **Platter 1 mm higher:** the hub spacer is now 1.5 mm (`PLATTER_GAP`, was 0.5), because pressing
  the platter scraped its rim on the well. The shaft grows to match, to 28.0 mm flat and 24.0 mm
  angled, so the tip and the magnet gap stay where they were.
- Shaft Ø8.1 (8.0 was still loose in the 608s); `fit_gauge.stl` now 8.05–8.20.
- `jog.shaft(extra)` takes the extra length; the platters are unchanged apart from the pocket.

## 2026-11-02: Jog encoder raw capture (serial R)

- Serial `R` records 4 s of the AS5600's raw angle at 500 Hz (2000 samples,
  -1 = lost) and prints them as `RAW` lines, for checking the signal.
  The 10 KB buffer is in PSRAM and is only allocated on the first `R`.
- **Measured after reassembly:**
  - The magnet first read too weak (magnitude 341 and then 144, AGC 128). Once it was
    reseated it read 2088.
  - At rest: ±1 count (std 0.8).
  - Spinning at up to 1.1 rev/s: no samples lost, no jumps, jitter 2.6 counts
    (0.12 ticks) against a 40 ms average, well inside the 1-tick hysteresis.
- No change to the audio budget (the capture is idle unless `R` is sent).

## 2026-11-01: AS5600 jog encoder works (I2C)

- New `main/as5600.cpp`: the AS5600 drives the jog. It sends the same
  `Jog` events as the DJ2Go's jog, at 180 ticks per turn (1.8 s of track,
  about a record at 33 1/3), so scratch and nudge work unchanged and the
  DJ2Go still works alongside it.
- **I2C** at 0x36 on the codec/touch bus (SDA pin 3, SCL pin 5), polled at
  500 Hz from a core-0 task (never the audio task). Magnet status is checked
  every 100 ms; samples without a magnet are skipped and the position
  re-seeds, so it can't jump. Whole-tick hysteresis.
- **Analog fallback** on pin 7 (GPIO 23) if nothing answers at boot: 2 ADC
  reads per sample, smoothed (13 ms), range learned from what's seen.
- Bench numbers: at rest ±1 count on I2C against ±40 on the ADC; 0 drift
  ticks at rest; one read 177 us (bus wait, core 0); analog was 282 us per
  sample. Turning the platter tracked both ways through the wrap.
- What went wrong on the way:
  - The ADC task first hogged core 0. Eight reads took more than 1 ms, so
    `vTaskDelayUntil` never blocked and the idle task's watchdog fired. It
    now always yields.
  - The magnet on the printed shaft was too far away: AGC 128, magnitude
    ~148, "too weak". It was solid at ~1 mm (AGC 0, ~2,080).
  - The analog OUT never moved even with the magnet seen, most likely the
    wire on GPO (internal pull-up, reads 3.3 V) or OUT not soldered.
- Serial keys: `e` encoder readings (mode, raw, ticks, lost samples), `E`
  magnet status over I2C (detected / weak / strong, AGC, magnitude, angle,
  output config).

## 2026-11-01: Case fixes from the first print (CAD only)

- Optional Pioneer-style platter, `cad/pioneer_platter.py`. It's freedj-3000's
  `jog_wheel.py` profile (dished top, hollow grooved skirt, hub), resized to
  this deck:
  - 100 mm across, 10 mm tall, so it sits in the 104 mm well where the
    knurled platter does.
  - The dished centre is the touch plate's seat (80.4 mm, 1.2 mm deep).
  - The skirt wall is 3.8 mm, so its inside locates the steel inertia ring
    (0.2 mm clearance). The ring sits up against the top plate.
  - Three 0.8 mm grip grooves (freedj-3000 has four of 1.2 mm).
  - It keeps jog.py's printed shaft and inner-race spacer, so the bearings,
    magnet and AS5600 don't change.
  - 35 cm³ against the knurled platter's 61. One body, watertight, in both
    configs.
  - `FREEDJ_PLATTER=pioneer` puts it in `machine.py`'s assembly. With it, the
    platter and ring have 0 clashes with every other part, angled and flat.
  - Print it like the knurled one: upside down, shaft up, supports only in
    the centre recess.
- Jog shaft is a full 8.0 mm (was 7.95), for both platters: 7.95 printed
  loose in the 608 bearings. `fit_gauge.stl` now has pins of 7.95, 8.00, 8.05
  and 8.10 (was 7.90 to 8.05). Reprint: platter (whichever one you use).
- Pioneer platter reshaped to match Dan's reference mesh
  (meshy_1788016598940.glb, a disc with a 6 mm band, a dimpled shoulder and a
  domed top):
  - The top is flat (the reference's dome flattened). Its centre is still the
    touch plate's seat (80.4 mm, 1.2 mm deep), with a flat land out to r 45.
  - The base band is thinner: 2.5 mm, with one fine line (the reference's is
    about 3.3 at this scale, with two).
  - Shoulder: a 6 mm round off the band, then 45 degrees up to the top. It has
    24 oval dimples (12 x 8 mm, 1.1 deep). The 45 degrees is what lets it
    print upside down with no support; the reference's shoulder flattens out
    at the top, which wouldn't.
  - The inertia ring now sits flush with the skirt's foot (z 0-5). The hollow
    is 2.6 mm from the deepest dimple.
  - 37.7 cm3. One body, watertight, angled and flat. 0 clashes in both
    shells with `FREEDJ_PLATTER=pioneer`.
- Magnet pocket in the shaft tip is now Ø6.05 (was Ø6.16), a light press fit
  (`MAGNET_FIT`). At Ø6.16 the magnet fell out before the E6000 set.
  Reprint: platter.
- Rear USB-A slots 0.5 mm wider (0.75 mm clearance per side, was 0.5): the
  ports' metal shells flare at the mouth and had to be filed to fit. Height
  unchanged. The web between the two slots is 3.4 mm, and 3.1 mm to the
  Ethernet opening. Reprint: shell.

## 2026-11-01: Populated control board test fit (CAD only)

- New `cad/ctrl_fit.py`. It takes the populated board from tscircuit's GLB
  export, which has the real JLCPCB/EasyEDA part models. tscircuit's STEP
  export can't merge those models. It registers the board on its own origin
  (deck CTRL_XY centre, top face at CTRL_Z), not a bounding box.
- The switch model is wrong: ZX-QC66-7.5TP is drawn 5.0 mm tall, but the
  part is 7.5 mm (LCSC). Its body is replaced with 6 x 6 x 3.5 plus a
  Ø3.5 actuator to 7.5 mm.
- Outputs: `build/ctrl_board_pop{,_flat}.stl` (deck frame, drops onto the
  shell STLs), `build/ctrl_board_pop_local.stl` (board alone, centre 0,0,
  top face z 0), and render scenes.
- Clash check, every part's convex hull against the shell, rings, caps and
  base: **0 clashes** in both configs with lit and plain buttons. Checked
  that it does report clashes: raising the board 1 mm hits the bosses,
  skirts and caps.
- Renders 0034 (populated board) and 0035 (section in the deck).
- `build/ctrl_board_print.stl`: a printable stand-in for test fits. The real
  1.6 mm plate with its screw holes, every top-side part as its convex hull
  (switches at 7.5 mm), no connectors. One watertight body, 42 x 58 x 9.1 mm,
  flat on the bed.

## 2026-11-01: Control board PCB (CH32V003 I2C target), routed and DRC-clean

- New `hardware/ctrl-pcb/`, a tscircuit design, 42 x 58 mm, 2 layers. A
  **CH32V003F4P6** (C5187096: 26k in stock, ~$0.29) is the I2C target for
  the fader ADC, button debouncing and 8 individually driven ring LEDs.
  The ATtiny1616/1626 had only 47-108 in stock. The AS5600 shares the bus
  through J_ENC.
- All SMD on top (one-side assembly): 2 x ZX-QC66-7.5TP 6 x 6 x 7.5 tacts
  (wired on diagonal pads), 4 x 0805 LEDs per ring on r 11.3 (green
  C2297 / 100R, amber-yellow C2296 / 470R), a resistor per LED inside the
  skirt, the MCU and passives right of the buttons. Bottom: JST-XH for
  the host (back edge), AS5600 and fader (right edge), and SWIO pads.
- The anchors come from the CAD (`gen_geom.py` -> `lib/geom.json`), so the
  board can't drift from the case. `build.sh` does placement, Freerouting +
  capacity router, island removal, the TraceMaker finish, the gates and
  `fab/`.
- Result: KiCad DRC clean (0 shorts, 0 open), one GND pour island, JLCPCB
  DFM OK, no floating pads, no parts under the ring skirts or the bosses.
  BOM: 27 parts in 11 lines, LCSC numbers from the design. 3 connectors to
  hand-solder.
- CAD follows the real parts: TACT 12 x 12 x 7.3 -> 6 x 6 x 7.5 (board
  0.2 mm lower), connector positions and J_ENC to 5 pins, skirt notches
  3.6 mm wide to clear the 0805 pads. Clash check clean in both configs
  with both button styles.
- Firmware for the CH32V003 isn't written yet.

## 2026-11-01: CDJ-style tempo knob (CAD only)

- The slider knob was a plain rounded block. It's now a CDJ-style tempo
  knob: 14 mm across the slot, tapering from an 11 mm base (1.2 mm straight
  foot) to a 12 x 5.5 mm flat top, 10 mm tall, with concave finger scoops
  (R 14, 1.3 mm deep) front and back, a 0.6 mm round on the top edges, and
  the index line across the top centre. Same lever socket, so the fit is
  unchanged.
- Clash check clean in both configs; watertight, one body.
- Reprint `slider_knob.stl`. Render 0033.

## 2026-11-01: Plain buttons, without light rings (CAD only)

- New `play_cap_plain.stl` / `cue_cap_plain.stl`. A Ø22 cap fills the
  top's Ø22.4 hole, and its Ø23.6 flange (chamfered 45° on top, 0.2 mm
  under the top at rest) catches the underside. It has the same Ø4 nub
  onto the same tact switch, and uses the same shell and control board,
  so the LEDs are optional. A translucent plain cap picks up the LEDs'
  light through its flange.
- `FREEDJ_BUTTONS=plain` (default `lit`) puts them in the assembly and
  the clash check. Both styles are clean in both configs; all printed
  parts are watertight, one body.
- Render 0032 (plain buttons, section).

## 2026-11-01: Buttons held in by the control board; 60 mm pitch fader (CAD only)

- **Buttons:** cap and light ring both go in from below, and the control
  board holds them in. The ring gains a Ø23.6 skirt (1 mm wall) from the
  top's underside down to the board; the board clamps it, and it carries
  the LED light up to the ring (notches over the LEDs). The cap gains a
  Ø21 flange under the ring tube, 0.2 mm below it at rest, chamfered 45°
  on top so it prints upside down, and a Ø4 nub onto the tact switch. The
  shell's guide sleeves are gone: a plain Ø22.4 hole. The skirts are
  0.4 mm apart (buttons 24 mm apart).
- **Control board:** 42 x 58 mm (was 40.5 x 56.5), grown 1.5 mm at the
  front and left so the skirts sit fully on it. The LEDs move to r 11.3,
  tangential, under the skirt wall.
- **Pitch fader: PTA6043-2015DPB103** (60 mm) instead of the PTA4543.
  75 mm frame, M2 holes 71 apart, slot 64.6 mm (still 2 mm to each
  screw). In the angled version the frame's end is 1.5 mm into the dev
  board's footprint in plan, 9 mm above its tallest part there.
- The tick scale (long ticks 3.5, short 2) and the tempo-zero LED move
  in from the deck's right edge; they ran onto the 2 mm edge round.
- Clash check over every new part in both configs: clean (only the
  knob's inlaid line, as intended). All printed parts watertight, one body.
- Print: shell, `play_cap`, `cue_cap`, `light_ring` x 2, `slider_knob`.
- Renders 0030 (button section), 0031 (60 mm fader).

## 2026-11-01: PLAY cap exported under its own name; light ring exported

- `controls.py` wrote the PLAY cap as `button_cap.stl`, which read like a
  generic part next to `cue_cap.stl`. It's now `play_cap.stl`.
- The light ring had no STL. It's now `light_ring.stl`: print two, in
  translucent PETG or resin.

## 2026-11-01: PTA4543 pitch pot mount and the control board (CAD only)

- Pitch pot chosen: **Bourns PTA4543-2015DPB103** (45 mm, no centre detent,
  15 mm metal lever, 10k linear). Its frame hangs on two 3 mm pads under the
  top, held by two M2 x 8 countersunk screws into its tapped holes (56 mm
  apart). The slot shrinks from 74 to 49.6 mm (travel + lever + 0.6),
  leaving 2 mm of plastic to each screw hole. The knob gets a 1.4 x 4.3 x
  7.2 mm lever socket, is 10 mm tall (was 9) and rides 1 mm above the top.
  The ticks now span the real 45 mm travel.
- New `ctrlboard.py`: one 40.5 x 56.5 mm board under CUE / PLAY, with three
  M2.5 screw bosses down from the top. Its top face is z 20.7 (angled) /
  24.7 (flat), where a 12 x 12 x 7.3 mm tact switch meets the cap's
  underside. Top side: switches and 4 x 0805 LEDs per light ring. Bottom
  side: the I2C chip and JST-XH for the pot (3), AS5600 (4) and dev board
  (5). It writes `build/ctrl_board_outline.dxf` and prints every position
  relative to the board corner.
- The Cherry-MX switch stand-ins are gone; the caps now rest on the tact
  switches.
- Clash check over every new part in both configs: clean (only the knob's
  inlaid index line overlaps, as intended). Shells watertight, one body.
- **Reprint needed:** the shell (both configs) and the slider knob.
- Renders 0028 (slot, countersinks) and 0029 (board section).

## 2026-11-01: Music plays out of the UCA202

- `usb_audio_probe` becomes `usb_audio`, a real output. When a UAC1 device
  with a 16-bit stereo isochronous output at 44.1 kHz enumerates, the deck
  streams to it in stereo. The speaker gets silence, and comes back when
  the device is unplugged.
- `audio_out::write()` feeds a 4096-frame ring. The USB side sends one
  packet per 1 ms frame, 44 or 45 frames, 4 packets per transfer, 3
  transfers in flight. It holds the ring near 1024 frames (~23 ms). Past
  ±512 frames it drops or repeats one frame per packet to follow drift
  between the I2S and USB clocks. The I2S DMA still paces the audio loop.
- Mute is done by sending silence to I2S, not by muting the codec. The
  first try muted the codec over I2C from the audio task (core 1), which
  collided with LVGL's touch read on the same bus. The touch read failed
  and the deck aborted at boot, over and over.
- The 2 s report adds `usb audio: underruns N  drift corrections N`.
- Budget (idle, no track loaded): uac_client 1 % of core 0, audio 9-10 %
  of core 1. Added latency on USB: ~23 ms ring + ~12 ms in flight.

## 2026-11-01: UCA202 enumerates; the probe tone plays with no errors

- The UCA202 (TI PCM2902, 08BB:2902) failed to enumerate: "Configuration
  descriptor larger than control transfer max length". The hub then
  switched off its port, so the UCA202's power LED stayed dark. It lists
  about 40 formats, which puts its config descriptor over 1 KB.
  `CONFIG_USB_HOST_CONTROL_TRANSFER_MAX_SIZE` goes from 256 to 4096; 1024
  still failed. Each device gets a 4 KB control buffer, in PSRAM.
- Probe result through the hub: playback on interface 1 alt 1 (2 ch,
  16-bit, 32/44.1/48 kHz, isochronous OUT 0x02, adaptive, 192 bytes).
  Capture on interface 2 (IN 0x84, async). A 2 s tone at 48 kHz:
  1,000 packets, **0 packet errors, 0 transfer errors**.
- SET_CUR sample rate on the endpoint stalls. The tone still played, so
  the PCM2902 apparently follows the packet rate.

## 2026-10-31: USB audio probe (Behringer UCA202, not yet tested)

- New `usb_audio_probe`: its own USB host client. When a device with a USB
  audio streaming interface (UAC1) enumerates, it logs the audio
  interfaces, terminals, formats, rates and endpoints. It then plays a 2 s
  440 Hz tone at -12 dBFS through the first 16-bit stereo isochronous
  output that takes 48 kHz: 192-byte packets, 8 per transfer, 3 transfers
  in flight. It logs packet and transfer errors at the end.
- Purpose: confirm isochronous transfers work through the full-speed hub
  before building an `audio_out` backend on them. Nothing else uses it.
  The DJ2Go (MIDI only) is skipped.
- Budget: not measured. It's idle until an audio device is plugged in.
  App 0x162900 bytes (83 % of the partition free).

## 2026-10-31: AS5600 on four bosses, real board size (CAD only)

- Board from Dan's ruler and the listing photo: 15/16" (23.8 mm) square,
  four corner holes 5/8" (15.9 mm) apart, chip in the middle. Two pin
  columns either side of the chip: 3 pins on the left, 4 on the right.
- Four 2.3 mm bosses (7 mm OD, small M3 inserts) replace the two guessed
  ones. Shallow pockets under both pin columns take the solder tails; the
  right one notches the top-right boss (0.55 mm wall round its insert).
- Only the base plate changes. Clash check clean in both configs.

## 2026-10-31: encoder on bosses, no e-clip (CAD only)

- The e-clip is gone. The printed shaft now ends just under the lower
  bearing (tip at z 9.5), so the magnet sits 2.3 mm higher and the AS5600
  board goes up on two 2.3 mm bosses with small M3 inserts. The air gap
  stays 1.1 mm. The header's Dupont plug clears the bearing boss by 0.6 mm.
- Shaft below the platter: 27.0 mm flat, 23.0 mm angled.
- Nothing holds the platter down for now. The shell is unchanged; only
  the platter and base plate change.
- No firmware change, so the budget is unchanged.

## 2026-10-31: case engraving reads "FREEDJ" (CAD only)

- The hardware brand is freedj (freedj-esp stays the firmware's name), so the
  bezel engraving is "FREEDJ" instead of "FREEDJ-ESP". Nothing else changed.

## 2026-10-31: printed jog shaft, AS5600 encoder, M3 inserts on the base (CAD only)

- The jog shaft is printed in one piece with the platter (Ø7.95, snug in the
  608s), instead of a steel 8 mm shaft. `fit_gauge.stl` has four pins
  (7.85-8.00) to find the right diameter on your printer first.
- The encoder is the AS5600 breakout (WWZMDiB, 23 x 23 mm), not an MT6701.
  It lies flat on the base plate on two small M3 heat-set inserts. Its
  right-angle header points back, and the solder tails drop into a slot.
- The stack is worked out from the shell as printed (lower bearing at
  z 10). From there down: DIN 6799 size-6 e-clip groove (9.20-9.95), then
  0.4 mm of plastic, then a pocket with the 1.6 mm magnet glued flush. The
  shaft tip is at z 7.20, 1.1 mm above the chip. Shaft below the platter:
  29.3 mm flat, 25.3 mm angled. The shell is unchanged.
- The dev board standoffs take small M3 inserts (Ø4.0 bore, 4.5 deep, 8 mm
  OD) instead of M2.5. The board's 2.75 mm holes need opening to 3.2 mm.
- Fix: `base.py` always wrote the angled plate as `base.stl`. The flat
  config now writes `base_flat.stl`, 1.6 mm deeper. The platter is also
  per config now (`platter_flat.stl`).
- No firmware change, so the budget is unchanged.

## 2026-10-31: centred screen window, base screws in all four corners (CAD only)

- The screen window is centred on the deck (over the jog). Before, it sat
  about 7 mm right: the module was moved 4 mm for the USB slot, and the
  active area is 2.88 mm off-centre on top of that. Now the module shifts
  2.88 mm left instead; the USB slot and engraving moved left to suit.
- Base fixing redone: four short corner bosses (9 mm, 10 mm tall, 45° cone
  on top) instead of full-height posts. The old front-left post's insert
  bore broke into the PLAY button hole, and the back-right one had been
  moved off the corner. The dev board moved 5.5 mm left to clear the
  back-right boss; RCA moved left again (64/80 mm).
- Tempo-zero LED hole added (it was missing).
- No firmware change, so the budget is unchanged.

## 2026-10-31: dev board mounted in the enclosure (CAD only)

- The Waveshare ESP32-P4-Module-DEV-KIT (Pi B+ footprint, from Waveshare's
  drawing) sits back-right under the screen, on four 3 mm standoffs printed
  on the base plate (M2.5 heat-set inserts). Ethernet and both USB-A pairs
  come out the rear wall; power and UART USB-C come out the right side.
- The separate RJ45 and USB-C jacks are gone; RCA moved left of the ports.
  The back-right base post moved forward, between the pitch pot and the board.
- The flat version is now 38 mm tall (was 34): the USB-A stacks would hit
  the screen's board under a flat top. The angled version clears at 34.
- No firmware change, so the budget is unchanged.

## 2026-10-31: renamed freedj-esp

- The project (and repo) is now **freedj-esp**, after freedj-3000. The splash
  and the Pro DJ Link device name say FREEDJ-ESP, and the enclosure engraving
  too. CAD file names and the config variable follow (`freedj_esp*`,
  `FREEDJ_CONFIG`).
- Name strings only, so the budget is unchanged. Builds clean (P4, and the
  A1S es8388 env).

## 2026-10-31: screen recessed behind a window (CAD only)

- The screen now sits behind the top plate on a 0.5 mm foam gasket. The
  window shows only the visible area: it's off-centre by 2.88 mm, as the
  panel's active area is, and chamfered 45° so fingers reach the edges.
- The four screen bosses come down to the board (6.8 mm OD); the M3 pilots
  are 6 mm deep, 3.3 mm under the face.
- No firmware change, so the budget is unchanged.

## 2026-10-31: screen mounts on its own 4 holes (CAD only)

- The screen is a Hosyond 4" capacitive, i.e. the LCDwiki MSP4031: the model
  now follows that drawing (108.00 × 60.88 board, 4.85 mm glass + tape stack).
- Four bosses on the module's mounting holes (102.00 × 54.88 mm, Ø3.2), with
  M3 × 5 thread-formers, replace the two printed clamps.
- No firmware change, so the budget is unchanged.

## 2026-10-31: compacted enclosure (CAD only)

- 20 mm shorter: 160 × 185 mm angled, 186 mm flat (was 205). The glass now
  starts 8 mm behind the jog well (was about 20). Jog, buttons and slider
  moved 5 mm forward, and the brand engraving moved onto the bezel. The
  depth is now derived from the layout instead of set by hand.
- No firmware change, so the budget is unchanged.

## 2026-10-31: enclosure around the 4" MSP4021, plus a flat-top version (CAD only)

- Redesigned around the 4" MSP4021 we actually have, not a 3.5" panel: 160 ×
  205 mm (was 195). The glass stack sits flush in the top and the board is
  clamped from behind. Panel dimensions are from vendor data, not measured yet.
- A flat-top configuration (`machine_flat.py`) that prints with no supports.
  The angled design stays the default.
- No firmware change, so the budget is unchanged.

## 2026-10-31: enclosure design (CAD only)

- First design for a 3D-printed ESP Deck in `hardware/`: a 160 × 195 mm
  CDJ around a 3.5" ST7796S LCD. 100 mm jog on two 608 bearings with an
  MT6701 magnetic encoder, CUE/PLAY with light rings, 45 mm pitch slider,
  12° screen bezel. Parametric build123d model, Blender renders.
- No firmware change, so the budget is unchanged.

## 2026-10-31: 8 MB app partition

- Our own partition table (`partitions.csv`) gives the app 8 MB instead of
  the 1.5 MB "single app large". The app is 1.4 MB, so 83 % is free (it was
  94 % full). About 8 MB of flash stays unallocated, for OTA slots or a
  cache later.

## 2026-10-31: XDJ touch keys, boot splash, colour waveforms, "ESP Deck"

- **Bottom row is now the XDJ's touch keys:** BROWSE (SEARCH) · TAG LIST ·
  INFO (LINK INFO) · MENU (UTILITY) · PERFORM, in freedj-3000's colours.
  - TAG LIST, INFO and MENU are dimmed: not built yet.
  - BROWSE holds the list until pressed again or a track loads.
  - PERFORM replaces PADS.
  - The CUE / PLAY / LOAD buttons are gone: they're on the DJ2Go, and
    tapping the selected row still loads.
- **Boot:** the bootloader hook switches the backlight off about 50 ms after
  power-on (no more white screen). The splash is the app's first step, now
  at 1.0 s (the white screen used to last 3.7 s). The deck screen comes at
  3.1 s (was 3.8). The PSRAM self-test is off (−1 s), and touch now starts
  after audio, because it shares the I2C bus.
- **Colour waveforms** from rekordbox's PWV5, on the scrolling waveform and
  the overview. Bit order checked: red 15–13, green 12–10, blue 9–7, height
  6–2; that layout correlates 0.86 with the PWV3 heights, rekordcrate's 0.63.
  Same cost as the blue waveform: 37.8 fps, core 0 59 % while the buffer
  refills.
- **Named ESP Deck:** on the splash, and as the Pro DJ Link device name.
- App: 6 % of the partition left. The bigger partition is due.

## 2026-10-31: scratch when paused, waveform stays up, feel parameters

- **Paused jog scratches.** The jog moves a target, and the playhead chases
  it over about 23 ms. The audio follows the hand at whatever speed and
  direction that takes, and glides to a stop. Varispeed, capped at 8×.
  Playing, the jog still nudges.
- **The waveform stays on screen while paused.** The list comes back only
  for a few seconds after browsing.
- **Feel parameters** gathered in one block in `main.cpp`, with the nudge
  numbers named, and documented in the README with what to compare each one
  against. Serial `J` counts jog ticks per revolution for calibration.

## 2026-10-31: tempo master, beat packets, remote sync, mixer (XDJ parity step 2, first half)

- **Beat packets** go out on each of our beats as they're heard. BPM is
  unpitched with pitch separate (Beat Link's effective tempo), beat-in-bar
  comes from the grid, and the six countdowns are filled in. The link task
  holds the pending beat until it's sent; before that, a late wake-up skipped
  every other beat. A backwards move (loop wrap, cue, jump) restarts the
  count, so loops keep sending beats.
- **Tempo master:**
  - Long-press SYNC (or serial `Y`) asks for master. If nobody has it, the
    deck takes it at once.
  - Otherwise it sends a master request (0x26) and waits for the yield
    (0x27), then for the master to name us in its status before claiming.
    Claiming on the yield alone made an XDJ abort (freedj-3000's finding).
  - When we're master and someone asks, we yield, name them, and let go
    once they claim.
  - The sync counter is set to the largest seen + 1. Status goes out at once
    when the master flag changes. While we're master, we follow nobody.
- **Remote control:** another player can turn our SYNC on or off, or tell us
  to become master (0x2a).
- **Mixer** (from Deep Symmetry's analysis; **untested, no DJM here**):
  "channels on air" (0x03) sets our on-air flag (red time, status bit), and
  fader start (0x02) plays, or stops and returns to the cue.
- The BPM line shows MASTER in orange when we're master.

Measured with prolink-cpp tools on the PC:

| Test | Result |
|---|---|
| Beat packets, 33 beats at 126 BPM | mean interval 0.4762 s (exact), 5.3 ms jitter as received on the PC; beat-in-bar 1-2-3-4 correct, also through a 4-beat loop |
| Taking master from the virtual CDJ | it yielded, named us, we took master (sync counter 1) |
| A virtual CDJ in `--follow-master` | synced to us (120 → 126 BPM); its beats within about ±15 ms of ours |

Test trap: a `prolink_listener` on the PC shares port 50001 with the virtual
CDJ, and Linux delivers a unicast packet to only one of them. With the
listener running, our master requests never reached the virtual CDJ.

## 2026-10-31: tempo range and reset, hot cues E–H, memory cues, slip, reverse

- **Tempo range** ±6 / ±10 (new default, as on the XDJ; was ±8) / ±16 /
  WIDE (±100 %). Tap the range label next to the tempo to cycle; long-press
  it for **tempo reset**, which plays at 0 % regardless of the fader.
- **PADS has three rows:** all eight hot cues A–H; CALL ◀ ▶, MEM, DEL, /2,
  x2, RELOOP, SLIP; beat loops 1–16, beat jump ◀4 4▶, REV. The panel now
  covers the meter and the waveform.
- **Memory cues can be set on the deck:** MEM stores the cue point (or the
  active loop's start), DEL removes the one at the cue or the playhead. These
  last for the session only and aren't written to the stick.
- **Slip:** during a loop, reverse, or a held hot cue, a shadow playhead
  keeps going at normal speed. Letting go resumes from it, and a grey line on
  the waveform shows where it is. In slip mode, hot cues are momentary.
- **Reverse:** always plays varispeed, because the time-stretcher only runs
  forwards. Sync correction pauses while reversed.

Measured (synced to the virtual CDJ):

| Test | Result |
|---|---|
| Slip through a 6 s loop | resumed 6 s further on, sync 1.5 / 4.8 ms |
| Reverse 2 s with slip | resumed ahead; one 119 ms sync reading right after, then 1.4 ms |
| Audio | 100 % real time throughout |

## 2026-10-31: cues, loops, beat jump, quantize (XDJ parity step 1)

- **Hot cues A–H and memory cues read from rekordbox.** `PCO2` in the
  `.EXT` is preferred, falling back to `PCOB` in the `.DAT`. A track loads at
  its first memory cue, as on a CDJ.
- **Hot cue pad:**
  - empty: stores a cue at the (quantized) position, or the active loop
  - set: jumps there and plays, as a CDJ does; a hot loop starts its loop
  - long press: deletes it
- **Loops:**
  - beat loops of 1–16 beats from the current beat
  - manual in/out, on the DJ2Go's LOOP IN / LOOP OUT
  - RELOOP/EXIT, and halve/double (in beats for beat loops)
  - the emergency loop now shares this loop engine
- **Beat jump ±4.** It moves an active loop along with it. **CALL ◀ ▶** steps
  through the memory cues.
- **Quantize** (on by default, as on the XDJ): cue, hot cue and loop points
  snap to the beat. Jumps land at the same point within the beat as where
  you left, so the track keeps time and SYNC holds.
- **Screen:**
  - PADS panel over the waveform: A–D, CALL ◀ ▶, 1/2, x2, loops 1–16,
    RELOOP, ◀4 4▶
  - Q chip in the header
  - the Bars countdowns are live: bars.beats to the next memory cue and the
    next hot cue
  - waveform: loop band, hot cues green, memory cues red; overview ticks too

Measured synced to the virtual CDJ: phase error 1.4 / 3–4 ms through every
loop, halve, double, exit, hot cue jump, beat jump and manual loop.

Budget (stick track, synced, hot cue + 4-beat loop, waveform up, buffer
still filling):

| | |
|---|---|
| Screen | 34 fps |
| Core 0 | 60 % (LVGL 36 %, loader 18 % refilling, Link 3 %) |
| Core 1 | 12 % |
| Worst audio block | 1.5 ms |
| Internal RAM | 95 KB free, 79 KB lowest |

## 2026-10-31: boot without waiting for USB, hot-swap sticks, emergency loop

- **Boot no longer waits for the stick.** The screen is up at 3.8 s (was
  about 19 s) with the SD tracks. A mounted stick is read in the
  background, with a "Reading USB stick… n" notice, and its tracks join the
  list when done (13–14 s for 218 tracks at full speed).
- **Sticks can be pulled and plugged in while the deck runs.** The track list
  is now an immutable snapshot that gets swapped whole. Load requests carry
  paths instead of list indexes, and the selection follows its track across
  list changes. On a pull, the scan is cancelled, the stick's tracks leave
  the list, and the loader closes its file before the stick is unmounted.
- **Emergency loop**, as on a CDJ. If the stick is pulled while its track
  plays, the deck loops 4 beats (from the grid; 2 s without one) out of the
  audio already decoded in PSRAM. Whole beats keep SYNC locked: measured
  1.4 ms through the loop. Status goes out as play state `0x12`, the screen
  shows E.LOOP, and loading another track ends it. Pulled while paused,
  the track just unloads.
- **List strings moved to PSRAM.** Internal RAM at boot: 112 KB free (was
  68 KB).

Budget:

| | |
|---|---|
| Boot to screen | 3.8 s |
| Internal RAM, playing a stick track | 102–106 KB free, **80 KB lowest** (was 43 KB) |
| Emergency loop | audio 100 % real time, sync 1.4 / 3.4 ms |

## 2026-10-31: all USB ports (hub) working, DJ2Go and stick together

- **Hardware:** jumper H3 on its **DEVICE** side connects the on-board
  CH334F hub. The HOST side, or no jumper, gives only the single direct
  port. With the hub on, three ports work and the direct one is dead.
- **Firmware:** ESP-IDF's host has no transaction translator, so the DJ2Go
  (full speed) failed behind the high-speed hub ("TT is not supported").
  The root port is now limited to full speed with `HCFG.FSLSSupp`, which is
  re-asserted every 100 ms because a port recovery clears it. That makes the
  hub run at full speed. This is the trick from espp's `usb_host`
  (`full_speed_only`). The port is powered only after the MIDI and MSC
  clients have registered.
- **Cost:** the stick runs at 12 Mbit/s too.

| | High speed (direct port) | Full speed (hub) |
|---|---|---|
| Boot scan, 218 ANLZ files | 6.9 s | 12.4–13.7 s |
| MP3 load (index built at load, reads the whole file) | 0.49 s | 4.94 s |
| Playback | fine | fine (0 underruns) |

Next: build the MP3 index in the background after the track is ready, and
cache the track list on the stick.

## 2026-10-31: track overview with needle search

- The progress bar is replaced by an overview of the whole track, drawn from
  rekordbox's preview waveform (`PWAV`, 400 columns). The played part is
  dimmed; white line = playhead, orange = cue. Tracks without analysis (SD)
  get a plain strip.
- **Needle search:** touch or drag the overview to jump there. With SYNC on,
  the deck snaps back onto the master's beat once audio is there.
- After any stall while synced, the deck re-snaps. Before, it bent its way
  back over about 4 s.
- **MP3 index built at load.** With a VBR/Info tag (rekordbox exports have
  one), minimp3 built its seek index on the first far seek. That read 5 MB
  and left a 0.53 s gap mid-track. Now it's built at load (+0.49 s per load),
  and the jump gap is 46 ms.
- **Loader paced** once 8 s are buffered ahead. Refilling the 70 s window at
  full speed after a jump had held core 0 at 100 % and the screen at 9 fps
  for about 4 s.
- Tried FAT fast seek: no effect, so it's not enabled.

Budget (stick MP3, synced, steady state after a jump):

| | |
|---|---|
| Screen | 38 fps |
| Core 0 | 48 % (LVGL 34 %, loader 9 %, Link 2 %) |
| Core 1 | 11 % |
| Worst audio block | 1.5 ms |
| Sync | 1.4 / 4 ms |
| Internal RAM | 68 KB free, 43 KB lowest |

- **The overview** costs nothing measurable. It redraws only when the
  playhead moves a pixel.
- **During the paced refill** (about 10 s after a load or jump): core 0
  58 %, screen 34 fps.
- **Jump gap:** 46 ms.
- **App:** 9 % of the partition free.

## 2026-10-31 (fix): loading a stick track reset the board

- **Cause:** while minimp3 built its seek index, FAT read a large run of the
  file in one go. `usb_host_msc` then grew its DMA transfer buffer to about
  32 KB in internal RAM, but the largest free block was 31 KB. The
  allocation failed after the old buffer had been freed, and the driver
  freed it again on the error path, so the heap asserted
  (`tlsf_free … block already marked as free`) and the board reset.
- **Fix:** USB transfer buffers live in PSRAM
  (`CONFIG_USB_HOST_DWC_DMA_CAP_MEMORY_IN_PSRAM`), and the phase meter's
  tick canvas (15 KB) moved to PSRAM too.

Budget (three rekordbox MP3s from the stick, synced, waveform + grid +
meter up, 224-track list):

| | |
|---|---|
| Screen | 37–38 fps |
| Core 0 | 49–50 % (LVGL 34 %, loader 9 %, Link 3 %) |
| Core 1 | 10–11 % (varispeed) |
| Worst audio block | 1.5 ms |
| Sync | 1.4 / 3–5 ms |
| Internal RAM | 65–69 KB free, **43 KB lowest**, 31 KB largest block |

LVGL costs about 8 points more here than with the 6-track SD list (26 %).
The suspect is the 224-row list, even while hidden behind the waveform.
That isn't confirmed yet.

## 2026-10-31 (later): beat grid on the waveform, XDJ phase meter, honest frame counter

- Beat grid drawn on the waveform from the rekordbox grid: a short tick per
  beat at the top and bottom edges, longer and red on each bar's first beat.
- XDJ-style phase meter above the waveform. Tap it (or serial `v`) to switch:
  - beat display: bar in phrase and beat in bar
  - alignment view: master's and our beat ticks under one playhead
- The beat grid is double-buffered (the screen now reads it too).
- The report now shows real screen fps, plus internal RAM: free, lowest since
  boot, and largest block.
- Waveform height 100 → 80 px to make room for the meter.

Budget (`house.mp3` with the `g` 120 BPM test grid, synced to prolink-cpp's
virtual CDJ at 128 BPM, no USB stick):

| | Varispeed | Keylock |
|---|---|---|
| Screen | 40–42 fps | 40–42 fps |
| Core 0 | 39–42 % | 38–42 % |
| Core 1 | 9 % | 27–28 % |
| Worst audio block (of 5.8 ms) | 1.25 ms | 3.4 ms |
| Real time | 100 % | 100 % |

- **Core 0 by task:** LVGL 25–29 %, loader 8 %, Link 2 %. With the waveform
  off, core 0 is at 20 %, so the waveform plus meter cost about 22 points.
- **Internal RAM:** 93 KB free, 73 KB lowest, 38 KB largest block. A
  224-track stick list costs about 12 KB more.
- **PSRAM:** 19.4 MB free. App: 9 % of the partition free.

## 2026-10-31: Pro DJ Link beat sync with rekordbox beat grids (`0ced6df`)

- Ethernet (IP101): DHCP, with a link-local fallback.
- Pro DJ Link: announces as player 2, sends status, finds the tempo master.
- USB stick mounted at `/usb`. Tracks are listed from their rekordbox ANLZ
  files: `PPTH` gives the audio path, `PQTZ` the beat grid.
- SYNC: matches the master's tempo (half or double time when closer), snaps
  onto its beat at PLAY, then holds phase by bending the tempo up to 3 %.
- SYNC and KEY chips, BPM readout. Keylock moved off the DJ2Go's SYNC button.
- The track list's LVGL objects go to PSRAM: 224 rows had used all internal
  RAM (2 KB left).

Budget:

- **Sync vs the virtual CDJ:** phase error 1.4 / 3.3 ms (avg / worst) in
  varispeed, about 3 / 10 ms in keylock.
- **Link task:** 2–4 % of core 0.
- **Rekordbox track from the stick:** core 0 42–48 %, waveform 34–41 fps.
  This was the old redraw counter, so that drop was at least partly a
  counting artefact.
- **Internal RAM:** 80 KB free with 224 tracks.
- **Boot:** +6.9 s to read 218 ANLZ files.
- **App:** 9 % of the partition free.

## 2026-10-30: keylock fixed, core 0 freed for networking

- `b643e66`: WSOLA overlap-add at unity gain. Keylock had been about 6 dB
  hot and clipping about 13 % of samples. This affects the A1S build too.
- `2bf72a7`: three changes:
  - LVGL sleeps on a semaphore instead of busy-waiting on each SPI flush
  - touch interrupt disabled (SPI clock coupled into its wire)
  - SPI at 40 MHz
- `a74b7c7`: keylock resamples to 44.1 kHz before WSOLA, so 48 kHz files
  play at the right speed and pitch.

Budget:

| | Core 0 | Core 1 | Waveform* | Audio block avg / max |
|---|---|---|---|---|
| Varispeed | 31 % | 8 % | 46 fps | 0.43 / 0.88 ms |
| Keylock | 31 % | 30 % | 46 fps | 1.75 / 3.1 ms |
| Keylock, waveform off | 12 % | 17 % | — | 0.94 / 1.8 ms |

\*Old redraw counter.

- **Before `2bf72a7`:** core 0 98 %, core 1 42 %, waveform 19 fps.
- **Internal RAM:** 173 KB free. **PSRAM:** 19 MB free. **App:** 1.14 MB.
- **Load times:** boot 2.0 s, MP3 0.65 s, WAV 0.13 s.

## 2026-10-29: first P4 deck

- `20df2a6`…`a3b8317`: DJ2Go over USB MIDI. WAV and MP3 stream from SD
  through a 12 MB PSRAM window; MP3 seeks are sample-accurate.
- `88653e4`, `949b500`: the MSP4021 SPI touch screen and the LVGL deck UI.
- `6b68c7f`: scrolling waveform. The I2S interrupt moved to core 1 (it had
  been on core 0, behind the screen's SPI traffic, and audio ran at 80 %).
  Added the health report: real-time %, block timing, click detector.

Budget: real time 78–80 % → 100 % after the interrupt fix, waveform 18–19
fps*, core 0 near 100 % (busy-wait flush, fixed the next day).

\*Old redraw counter.
