audiodestrukt/freedj-esp/p4/deck/hardware/ctrl-pcb/index.circuit.kicad_pcb

## KiCad design p4/deck/hardware/ctrl-pcb/index.circuit.kicad_pcb (2026-11-01)

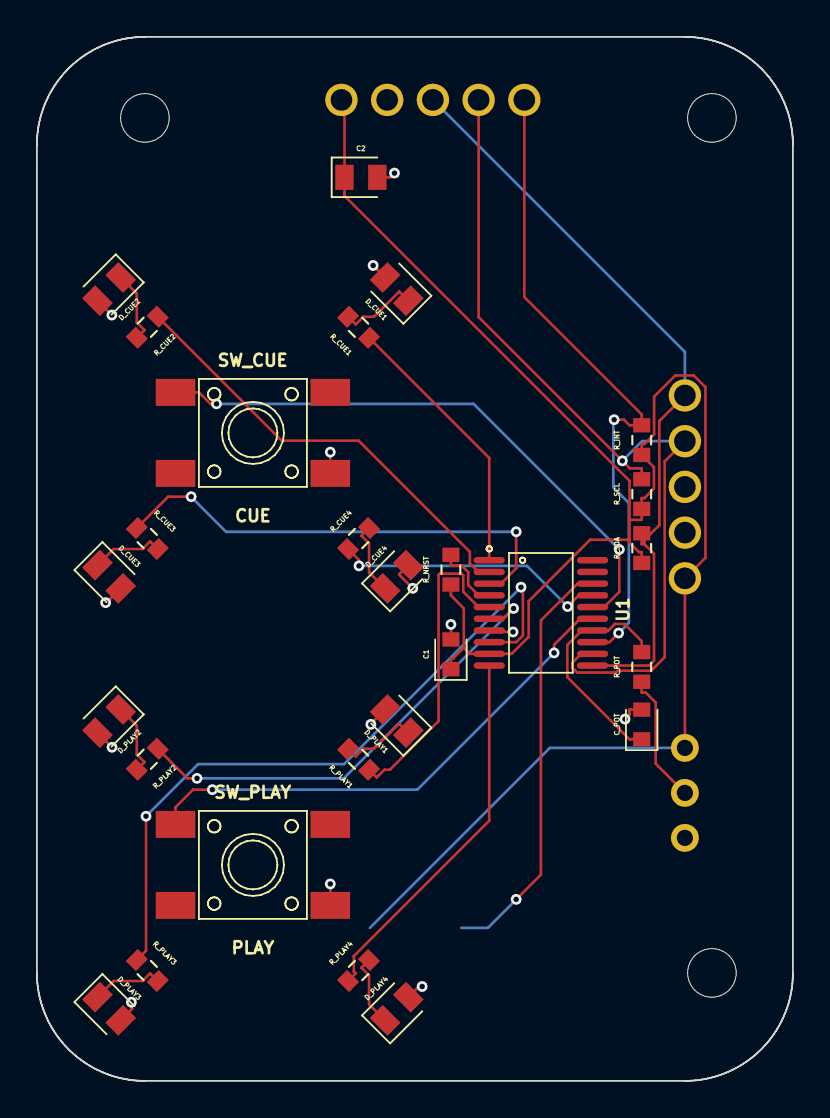
[picture p35: board index.circuit.kicad_pcb from above]

Board: 2 copper layers, 42.0 x 58.0 mm, 33 parts (0 on the bottom side), 27 nets.

Parts:
C1: 100nF; capacitor_0603
C2: 10uF; capacitor_0805
C_POT: 100nF; capacitor_0603
D_CUE1, D_CUE2, D_CUE3, D_CUE4: LED; led_0805_color(yellow)
D_PLAY1, D_PLAY2, D_PLAY3, D_PLAY4: LED; led_0805_color(green)
J_ENC: B5B_XH_A_LF__SN_; B5B_XH_A_LF_SN
J_HOST: B5B_XH_A_LF__SN_; B5B_XH_A_LF_SN
J_POT: B3B_XH_A_LF__SN_; B3B_XH_A_LF_SN
R_CUE1, R_CUE2, R_CUE3, R_CUE4: 470Ω; resistor_res0603
R_INT: 10kΩ; resistor_res0603
R_NRST: 10kΩ; resistor_res0603
R_PLAY1, R_PLAY2, R_PLAY3, R_PLAY4: 100Ω; resistor_res0603
R_POT: 1kΩ; resistor_res0603
R_SCL: 4.7kΩ; resistor_res0603
R_SDA: 4.7kΩ; resistor_res0603
SW_CUE: ZX_QC66_7_5TP
SW_PLAY: ZX_QC66_7_5TP
TP_3V3: TP_3V3; test_point_smtpad_circle_d1.5
TP_GND: TP_GND; test_point_smtpad_circle_d1.5
TP_SWIO: TP_SWIO; test_point_smtpad_circle_d1.5
U1: CH32V003F4P6

Connections:
.R_CUE1 > .pin2 to .D_CUE1 > .anode: D_CUE1.1, R_CUE1.2
.R_CUE2 > .pin2 to .D_CUE2 > .anode: D_CUE2.1, R_CUE2.2
.R_CUE3 > .pin2 to .D_CUE3 > .anode: D_CUE3.1, R_CUE3.2
.R_CUE4 > .pin2 to .D_CUE4 > .anode: D_CUE4.1, R_CUE4.2
.R_PLAY1 > .pin2 to .D_PLAY1 > .anode: D_PLAY1.1, R_PLAY1.2
.R_PLAY2 > .pin2 to .D_PLAY2 > .anode: D_PLAY2.1, R_PLAY2.2
.R_PLAY3 > .pin2 to .D_PLAY3 > .anode: D_PLAY3.1, R_PLAY3.2
.R_PLAY4 > .pin2 to .D_PLAY4 > .anode: D_PLAY4.1, R_PLAY4.2
.U1 > .pin1 to .R_CUE1 > .pin1: R_CUE1.1, U1.1
.U1 > .pin2 to .R_CUE2 > .pin1: R_CUE2.1, U1.2
.U1 > .pin3 to .R_CUE3 > .pin1: R_CUE3.1, U1.3
.U1 > .pin5 to .R_PLAY1 > .pin1: R_PLAY1.1, U1.5
.U1 > .pin6 to .R_PLAY2 > .pin1: R_PLAY2.1, U1.6
.U1 > .pin8 to .R_PLAY3 > .pin1: R_PLAY3.1, U1.8
.U1 > .pin10 to .R_PLAY4 > .pin1: R_PLAY4.1, U1.10
.U1 > .pin17 to .R_CUE4 > .pin1: R_CUE4.1, U1.17
BTN_CUE: SW_CUE.1, U1.16
BTN_PLAY: SW_PLAY.1, U1.15
GND: C1.2, C2.2, C_POT.2, D_CUE1.2, D_CUE2.2, D_CUE3.2, D_CUE4.2, D_PLAY1.2, D_PLAY2.2, D_PLAY3.2, D_PLAY4.2, J_ENC.2, J_ENC.3, J_HOST.2, J_POT.3, SW_CUE.4, SW_PLAY.4, TP_GND.1, U1.7
INT: J_HOST.5, R_INT.2, U1.13
NRST: R_NRST.2, U1.4
POT: C_POT.1, R_POT.2, U1.14
SCL: J_ENC.4, J_HOST.4, R_SCL.2, U1.12
SDA: J_ENC.5, J_HOST.3, R_SDA.2, U1.11
SWIO: TP_SWIO.1, U1.18
V3V3: C1.1, C2.1, J_ENC.1, J_HOST.1, J_POT.1, R_INT.1, R_NRST.1, R_SCL.1, R_SDA.1, TP_3V3.1, U1.9
WIPER: J_POT.2, R_POT.1
