audiodestrukt/freedj-esp/p4/deck/hardware/cad/machine_params.py

# SPDX-FileCopyrightText: 2026 Dan Newcome
# SPDX-License-Identifier: CERN-OHL-S-2.0
"""machine_params.py: every shared freedj-esp enclosure dimension (mm), plus place().

Frame: x across the deck (0 = left edge), y front-to-back (0 = the edge nearest you),
z up (0 = underside of the shell). Sized around the 4" MSP4021 (480x320 ST7796S,
capacitive touch) the deck runs on today, or a 2.8" (FREEDJ_SCREEN=2.8).

Two configurations, picked by FREEDJ_CONFIG before this module is imported:
  angled (default)  the CDJ look: screen bezel tilted 12 degrees
  flat              the whole top flat, so the shell prints top-down with no supports
"""
import math, os
from build123d import Location, Pos, Rot

CONFIG = os.environ.get("FREEDJ_CONFIG", "angled")
assert CONFIG in ("angled", "flat"), CONFIG
# Screen, picked by FREEDJ_SCREEN: "4" (MSP4031, 480x320) or "2.8" (MSP2834, 320x240).
# The 2.8" only changes the depth (the bezel is shorter); width and height come from the jog.
# Main board, picked by FREEDJ_BOARD: "p4" (Waveshare ESP32-P4 dev kit, devboard.py) or
# "a1s" (AI-Thinker ESP32-A1S Audio Kit, a1s_board.py): the compact deck, always with the
# 2.8", an 80 mm platter and no USB-A stick slot or RCA jacks (the A1S has its own jacks).
BOARD = os.environ.get("FREEDJ_BOARD", "p4")
assert BOARD in ("p4", "a1s"), BOARD
A1S = BOARD == "a1s"
SCREEN = os.environ.get("FREEDJ_SCREEN", "2.8" if A1S else "4")
assert SCREEN in ("4", "2.8"), SCREEN
assert not A1S or SCREEN == "2.8", "the A1S deck is built around the 2.8\""
SUFFIX = ("" if CONFIG == "angled" else "_flat") + ("_a1s" if A1S else "" if SCREEN == "4" else "_28")
NAME = "freedj_esp" + SUFFIX   # output file stem

# Body
# Width and depth are derived below from the jog, buttons, slider and screen layout.
# Height of the top (jog area). P4 flat is 4 mm taller: the dev board's USB-A stacks sit
# under the screen, and without the angled bezel's rise they'd hit the screen's board.
# The A1S has nothing that tall, so its height is set by the jog's bearing stack (see JOG_H_MIN).
H = 32.0 if A1S else 34.0 if CONFIG == "angled" else 38.0
CORNER_R = 10.0              # plan-view corner radius
WALL = 2.5                   # side walls
TOP_T = 4.0                  # top plate (stiff: the jog boss hangs off it)
EDGE_R = 2.0                 # top-edge round

# Screen module. Frame: x along the long side, centred on the glass; the 14-pin header is
# at the -x end. LCD_AA_DX, LCD_PCB_DX, LCD_HOLES_DX: active area, board and hole pattern
# centres from the glass centre. LCD_HEADER_X: header pin row in from the board's -x end.
if SCREEN == "4":
    # The capacitive-touch version of the LCDwiki 4" SPI module (FT6336U, I2C), whose drawing
    # is MSP4031 (lcdwiki.com/res/MSP4030_MSP4031/4.0inch_SPI_Module_MSP4031_Size.pdf).
    # The resistive MSP4021 differs slightly (108.04 x 61.74 board, 102.04 x 54.90 holes).
    LCD_ACTIVE = (83.52, 55.68)
    LCD_AA_DX = 2.88             # active area sits off-centre, away from the header end
    GLASS = (94.57, 60.88)       # touch lens / TFT outline, centred on the board
    CTP_T, CTP_TAPE, TFT_T, TAPE_T = 1.35, 0.5, 2.5, 0.5   # glass top -> board: 4.85 mm
    LCD_PCB = (108.0, 60.88, 1.6)
    LCD_PCB_DX = 0.0
    LCD_HOLES = (102.0, 54.88)   # 4 x 3.2 mm, 3.00 mm in from the board edges
    LCD_HOLES_DX = 0.0
    LCD_HEADER_X = 3.3
    LCD_DEPTH = 14.8             # whole module incl. pin header, from the glass top
    SCREEN_BOSS_D = 6.8          # bosses on the 4 holes, down to the board; must clear the glass edge (3.7 mm away)
    SCREEN_PILOT = (2.5, 6.0)    # M3 thread-forming screws for plastic: pilot diameter, depth from the board face
    SCREEN_SCREW = 3.0
else:
    # LCDwiki MSP2834 (sold as Hosyond 2.8" IPS capacitive): ILI9341V, FT6336G touch.
    # lcdwiki.com/res/MSP2833_MSP2834/2.8inch_SPI_Module_MSP2834_Size.pdf. Measured from
    # the hole end along the 86 mm side: holes 3.00 and 79.08, glass 6.40-75.60,
    # active area 9.30-66.90, header row 84.0. The glass is as wide as the board (50).
    LCD_ACTIVE = (57.60, 43.20)
    LCD_AA_DX = 41.0 - 38.1      # 2.9, toward the hole end, away from the header
    GLASS = (69.20, 50.00)
    CTP_T, CTP_TAPE, TFT_T, TAPE_T = 1.0, 0.5, 2.3, 0.5    # glass top -> board: 4.3 mm
    LCD_PCB = (86.0, 50.0, 1.6)
    LCD_PCB_DX = 41.0 - 43.0     # the board runs 4 mm further past the glass at the header end
    LCD_HOLES = (76.08, 44.0)    # 4 x 3.2 mm
    LCD_HOLES_DX = 41.0 - 41.04
    LCD_HEADER_X = 2.0
    LCD_DEPTH = 14.28
    # The holes are only 3.4 mm past the glass ends (pads 4.7): a slim boss, M2.5 screws.
    SCREEN_BOSS_D = 5.6
    SCREEN_PILOT = (2.2, 5.0)    # M2.5 thread-forming, as the control board uses
    SCREEN_SCREW = 2.5
STACK = CTP_T + CTP_TAPE + TFT_T + TAPE_T
def _boss_to_glass():
    """Clear gap between a screen boss and the glass edge (the nearest of the 4)."""
    gaps = []
    for sx in (-1, 1):
        dx = max(0.0, abs(LCD_HOLES_DX + sx * LCD_HOLES[0] / 2) - GLASS[0] / 2)
        dy = max(0.0, LCD_HOLES[1] / 2 - GLASS[1] / 2)
        gaps.append(math.hypot(dx, dy) - SCREEN_BOSS_D / 2)
    return min(gaps)
assert _boss_to_glass() >= 0.3, ("screen boss hits the glass", _boss_to_glass())
GASKET = 0.5                 # foam between the glass and the top's underside
WINDOW_MARGIN = 0.5          # window = active area + this all round
WINDOW_LIP = 1.0             # straight part of the window wall; above it a 45 degree chamfer for fingers

# Jog
JOG_C = (72.0, 50.0) if A1S else (80.0, 60.0)   # A1S: CUE stays 3.7 mm clear of the smaller well
JOG_D = 80.0 if A1S else 100.0                  # platter
WELL_D = JOG_D + 4.0         # recess around it
WELL_DEPTH = 2.0
PLATTER_H = 10.0
PLATTER_GAP = 1.5            # platter underside above the well floor (0.5 scraped at the rim when pressed)
TOUCH_D = JOG_D - 20.0       # aluminium top plate = capacitive touch electrode
CAP_D = 24.0                 # centre cap
INERTIA = (JOG_D / 2 - 12, JOG_D / 2 - 4, 5.0)  # steel ring in the platter underside: r_in, r_out, h

# Two 608 skateboard bearings, 8 x 22 x 7
B608 = (8.0, 22.0, 7.0)
BOSS_OD = 32.0
BASE_T = 3.0

# Small M3 heat-set inserts (M3 x 3, ~4.2 OD), used in the base plate
M3_INSERT_BORE = 4.0

# Shaft: printed in one piece with the platter, a press fit through the 608s' 8 mm bores.
# Tune SHAFT_D with fit_gauge.stl (jog.py) on your printer before printing the platter.
SHAFT_D = 8.1                 # 8.0 still loose in the 608s (2026-11-02); 7.95 before that
SHAFT_LEAD = 0.5             # 45 degree lead-in on the tip, for pushing it through the bearings
MAGNET_FIT = 0.15             # pocket over the magnet's diameter; tune with magnet_gauge.stl
MAGNET = (4.0, 2.0)          # diametric, the one that came with the breakout (Dan, 2026-11-02: 4 dia, 2 thick)
MAGNET_GLUE = 0.1            # extra pocket depth for a film of glue under the magnet, so it still sits flush
# Retention: an e-clip in a groove just under the lower bearing pulls the shaft down, so the
# platter is held between its hub (on the upper inner race) and the clip (on the lower one).
# The clip's OD stays inside the 608's inner race (~12 mm), clear of the outer race.
ECLIP = (6.0, 0.75, 0.7, 11.3)   # DIN 6799 size 6 (shafts 7-9 mm): groove dia, groove width, clip t, clip OD
ECLIP_PLAY = 0.05                # groove top below the bearing face (clip seats; ~no end float)
CLIP_CAP = 1.5                   # solid shaft between the groove and the magnet pocket

# Encoder: AS5600 breakout (WWZMDiB), 15/16" square (ruler), 4 corner holes 5/8" apart, chip
# in the middle, chip side up under the shaft, on four bosses on the base plate with small
# M3 inserts. Two pin columns either side of the chip (jog.HEADERS).
ENC_PCB = (23.8, 23.8, 1.6)
ENC_CHIP_H = 1.5             # AS5600 in SOIC-8
_h = 15.875 / 2
ENC_HOLES = [(-_h, -_h), (_h, -_h), (-_h, _h), (_h, _h)]   # from the board centre (= chip = jog axis)
AIR_GAP = 1.1                # magnet face to chip top; a magnet +-0.4 mm off 1.6 gives 0.7-1.5

# The stack, bottom up from the shaft tip (fixed by the encoder: its bosses are already at the
# 2 mm minimum). Magnet pocket in the tip, solid cap, e-clip groove, then the lower bearing.
# Moving the bearing up for the clip (2026-11-03) shortened the bearing span by 3.9 mm.
SHAFT_BOTTOM = 9.5
GROOVE_BOT = SHAFT_BOTTOM + MAGNET[1] + MAGNET_GLUE + CLIP_CAP
GROOVE_TOP = GROOVE_BOT + ECLIP[1]
BOSS_BOTTOM = GROOVE_TOP + ECLIP_PLAY     # z of the boss underside = the lower bearing's bottom face
ENC_Z = SHAFT_BOTTOM - AIR_GAP - ENC_CHIP_H - ENC_PCB[2]   # PCB underside
ENC_STANDOFF = ENC_Z - BASE_T                               # boss height above the plate
assert ENC_STANDOFF >= 2.0, ENC_STANDOFF
assert 0.5 <= AIR_GAP <= 3.0, AIR_GAP     # AS5600 working range
assert ECLIP[3] < 12.0                     # clip on the inner race only
# Both 608s fit between the boss underside and the well floor, with a gap between them
BEARING_GAP = (H - WELL_DEPTH - B608[2]) - (BOSS_BOTTOM + B608[2])
assert BEARING_GAP >= 1.5, ("bearings too close: raise H", BEARING_GAP)

# CUE / PLAY, bottom-left as on a CDJ. Each button is a cap and a light ring, put in from
# below and held by the control board (no glue):
#   ring  translucent tube in the top's hole (OD RING_D, ID BTN_D + 0.5), 0.6 proud, with a
#         skirt (SKIRT_D, 1 mm wall) from the top's underside down to the board. The step
#         between tube and skirt bears on the underside; the board clamps the skirt. The
#         skirt carries the LEDs' light up to the visible ring (notches over the LEDs).
#   cap   BTN_D, CAP_RISE proud, with a flange under the ring tube (CAP_FLANGE) that stops it
#         coming out the top, and a nub under that onto the tact switch's actuator.
BTN_D = 19.0                 # cap
RING_D = 22.0                # light ring tube (the top's hole is RING_D + 0.4)
SKIRT_D = 23.6               # ring skirt OD: PLAY and CUE are 24 apart, so 0.4 between skirts
SKIRT_WALL = 1.0
CAP_FLANGE = (21.0, 1.2)     # dia, thickness (45 degree chamfer on top, so it prints upside down)
CAP_GAP = 0.2                # flange below the ring tube at rest (the cap sits on the switch)
NUB_D = 4.0
# Plain buttons (no light ring, LEDs optional): the cap fills the top's hole itself, and
# its flange catches the top's underside. Same shell, board and switch as the lit ones.
PLAIN_D = RING_D             # in the RING_D + 0.4 hole
PLAIN_FLANGE = (SKIRT_D, 1.2)   # as wide as fits: the buttons are 24 apart
PLATTER = os.environ.get("FREEDJ_PLATTER", "knurled")  # assembly: "knurled" (jog.py) or "pioneer" (pioneer_platter.py)
assert PLATTER in ("knurled", "pioneer"), PLATTER
BUTTONS = os.environ.get("FREEDJ_BUTTONS", "lit")   # "lit", "plain" or "panel"
assert BUTTONS in ("lit", "plain", "panel"), BUTTONS
# Panel-mount buttons (FREEDJ_BUTTONS=panel): bought 16 mm panel-hole momentary pushbuttons
# (0.75" across the top), held by their own nut under the top. Their bodies take the control
# board's space, so the board and its bosses go: buttons (and the fader) wire straight to the
# main board. Hole and top diameter are the listing's; body, nut and heights are typical
# guesses: measure the body depth (it must stay above the base plate, 25 mm under the top).
PANEL = BUTTONS == "panel"
PANEL_HOLE = 16.0 + 0.25           # listed panel hole + print allowance (printed holes come out small)
PANEL_BEZEL = (0.75 * 25.4, 2.5)   # 19.05 dia (listing), height above the top (guess)
PANEL_BODY = (16.0, 22.0)          # dia, depth below the top's underside (incl. lugs)
PANEL_NUT = (22.0, 3.0)            # across the corners, thickness
PANEL_MAX_T = None                 # the button's max panel thickness, if under TOP_T: the top is thinned to it locally from below
SHELL_SUFFIX = SUFFIX + ("_panel" if PANEL else "")   # only the shell (and the assembly) differ
NAME = "freedj_esp" + SHELL_SUFFIX
_BX = 17.5 if PANEL else 16.0   # panel: 1.5 mm right, so PLAY's body clears the front-left corner post
PLAY_C = (_BX, 16.0)
CUE_C = (_BX, 40.0)          # ~4 mm clear of the jog well

# Pitch slider: Bourns PTA6043-2015DPB103 (60 mm travel, no centre detent, 15 mm metal
# DP lever, 10k linear). Datasheet: 75 x 9 mm frame, two M2 tapped holes 71 apart in the
# frame top, 3 PC pins down (62.8 apart end to end). It hangs under the top on two pads,
# held by two M2 x 8 countersunk screws from above (flush: a pan head would catch the knob
# at the travel ends). Wired to the control board; its PC pins aren't used as board pins.
SLIDER_X = JOG_C[0] + WELL_D / 2 + (12.0 if A1S else 14.0)   # 146 on the P4
W = SLIDER_X + 14.0          # the ticks and tempo LED need 14 to the right edge: 160 on the P4
WINDOW_X = W / 2             # the visible window is centred on the deck
SCREEN_X = WINDOW_X - LCD_AA_DX   # glass centre: the active area is off-centre on the glass
SLIDER_C = JOG_C[1]          # slot centred on the jog
# Pot, picked by FREEDJ_POT (default sc6080 on the A1S deck, pta6043 on the P4). Both have
# the 75 x 9 frame with M2 tapped holes 71 apart and 60 mm travel, so the shell's mount is
# the same; the lever (knob socket) and body depth differ.
POT = os.environ.get("FREEDJ_POT", "sc6080" if A1S else "pta6043")
assert POT in ("pta6043", "sc6080"), POT
POT_TRAVEL = 60.0
POT_HOLES = 71.0             # M2 tapped, on the centre line
if POT == "pta6043":
    POT_FRAME = (9.0, 75.0, 6.5) # x (across), y (along the travel), z (frame top -> body bottom)
    POT_PINS = 62.8              # pin 1/2 end to pin 3 end
    LEVER = (1.0, 4.0, 15.0)     # DP lever: across, along the travel, above the frame top
    LEVER_BASE = (4.0, 0.0)      # wider foot of the lever: along the travel, height above the frame top
else:
    # SC6080GH B10K 15C (dual gang, 10k linear): its drawing gives the 75 x 9 frame, M2 x 0.4
    # holes 71 apart, body 7.0 deep, a 1.2 x 4.0 lever L = 15 above the frame top (F = 10 of
    # it straight, 5.0 wide below that), 6 pins (1/2/1'/2' at one end, 3/3' 70 apart at the
    # other) and two 2.0 mm PCB legs 25 and 22.5 either side of the centre, all 3.5 long.
    POT_FRAME = (9.0, 75.0, 7.0)
    POT_PINS = 70.0
    LEVER = (1.2, 4.0, 15.0)
    LEVER_BASE = (5.0, 5.0)
    POT_LEGS = (-25.0, 22.5)
# Pads under the top: frame top at H - TOP_T - POT_PAD. The SC6080 hangs lower so its
# lever's 5 mm foot stays 0.2 under the top plate (on 3 mm pads it rose 2 mm into the plate and
# caught the slot ends; a longer slot would bring them within 0.8 of the countersinks).
POT_PAD = max(3.0, LEVER_BASE[1] + 0.2)                  # 3.0 PTA, 5.2 SC6080
# M2 countersunk screws go through the top and the pad (TOP_T + POT_PAD) into the frame:
# M2 x 8 on the PTA (1.0 into the frame), M2 x 10 on the SC6080 (0.8; x 12 gives 2.8 if its tapped holes are that deep)
# The pads stop 0.5 short of the lever's foot at the end of its travel
POT_PAD_L = 2 * (POT_HOLES / 2 - (POT_TRAVEL / 2 + max(LEVER[1], LEVER_BASE[0]) / 2 + 0.5))
SLOT_W = 2.6
SLOT_L = POT_TRAVEL + LEVER[1] + 0.6                    # 64.6
SLIDER_Y = (SLIDER_C - SLOT_L / 2, SLIDER_C + SLOT_L / 2)
KNOB = (14.0, 11.0, 10.0)    # base x (across the slot), base y (along it), height
KNOB_TOP = (12.0, 5.5)       # flat top: x, y. Tapers from the base, CDJ tempo-knob style
KNOB_SCOOP = (14.0, 1.3)     # finger scoops in the front and back faces: radius, depth
KNOB_LIFT = 1.0              # knob underside above the top
KNOB_SOCKET = (LEVER[0] + 0.4, 4.3, 7.2)   # lever socket: across, along, depth (the lever goes in 7.0)
KNOB_SUFFIX = "" if POT == "pta6043" else "_" + POT   # slider_knob{_sc6080}.stl
KNOB_Y = SLIDER_C - 4.0      # rendered at +1.25 % (pitch range is firmware's business)
TICKS_X = 6.0                # tick scale starts this far right of the slot; long 3.5, short 2
TEMPO_LED_X = 11.0           # tempo-zero LED, right of the slot: clear of the 2 mm edge round
assert SLIDER_C - POT_HOLES / 2 + 1.9 < SLIDER_Y[0] - 1.0, "M2 countersink too close to the slot end"
assert POT_PAD_L >= 4.0, ("pot pads too short for the M2 screws", POT_PAD_L)
LEVER_IN_KNOB = LEVER[2] - TOP_T - POT_PAD - KNOB_LIFT  # 7.0 PTA, 4.8 SC6080
assert LEVER_IN_KNOB >= 4.0, ("lever too short to hold the knob", LEVER_IN_KNOB)

assert not PANEL or PANEL_BODY[1] < H - TOP_T - BASE_T - 1.0, "panel button body reaches the base plate"

# Control board: one PCB under CUE / PLAY with the two tact switches, the light-ring LEDs
# and the I2C chip (CH32V003); the pot and the AS5600 wire to it, one cable to the dev board.
# 6 x 6 SMD tact switches 7.5 mm tall (ZX-QC66-7.5TP, LCSC C7470157), right under the caps.
TACT = (6.0, 6.0, 3.5, 7.5)     # body x, y, body height, actuator top above the board
CAP_BOTTOM = 6.0                # the cap's nub reaches this far below the top surface
CTRL_T = 1.6
CTRL_Z = H - CAP_BOTTOM - TACT[3]                       # board top face
CTRL_XY = (4.0, 4.0, 46.0, 62.0)                       # x0, y0, x1, y1 (the skirts sit fully on it)
CTRL_CORNER_R = 6.0
CTRL_HOLES = [(41.5, 10.0), (41.5, 57.5), (10.0, 57.5)]
CTRL_BOSS_D = 6.0
CTRL_PILOT = (2.2, 5.0)      # M2.5 thread-forming screws up from below: pilot dia, depth

# Rear panel (y = D)
RCA_X, RCA_Z, RCA_HOLE = (() if A1S else (64.0, 80.0)), 15.0, 8.6   # left of the dev board's ports
USB_STICK = not A1S          # USB-A stick slot on the bezel (the A1S has no USB host)
USBA_FACE = (14.5, 13.6, 6.2)     # on the bezel: x, opening w, h (stick goes in from the top)

# Screen bezel. Depth follows from the parts: jog well, a gap, the glass with a
# margin either side. The top tilts up from BEZEL_Y to the back (flat: it doesn't).
JOG_SCREEN_GAP = 8.0         # jog well edge to glass edge, in plan
GLASS_MARGIN = (4.0, 5.0)    # glass edge to the bend line / to the back edge, along the top
TILT = 12.0 if CONFIG == "angled" else 0.0   # degrees
SLOPE_L = GLASS_MARGIN[0] + GLASS[1] + 0.4 + GLASS_MARGIN[1]   # bezel length along the slope
BEZEL_Y = JOG_C[1] + WELL_D / 2 + JOG_SCREEN_GAP - GLASS_MARGIN[0]
D = round(BEZEL_Y + SLOPE_L * math.cos(math.radians(TILT)), 1)
H_BACK = H + SLOPE_L * math.sin(math.radians(TILT))
SCREEN_V = GLASS_MARGIN[0] + (GLASS[1] + 0.4) / 2   # screen centre, measured up the slope
TOP_T_PERP = TOP_T * math.cos(math.radians(TILT))   # top thickness measured square to the bezel
GLASS_Z = -(TOP_T_PERP + GASKET)                    # glass top, face-local: behind the top plate
USBA_V = SCREEN_V + 18.0     # USB-A slot sits up the slope, clear of the screen bosses
BRAND_V = 9.0                # "FREEDJ", left of the screen near the bend

def board_module():
    """The main board's module: devboard (P4) or a1s_board, same interface."""
    if A1S:
        import a1s_board as b
    else:
        import devboard as b
    return b

def face_loc():
    """Location of the tilted bezel face: origin on the bend line at x = W/2,
    local +y up the slope, local +z out of the face."""
    return Pos(W / 2, BEZEL_Y, H) * Rot(TILT, 0, 0)

def place(solid, frm: Location, onto: Location):
    """Snap a part so its mate `frm` (local frame) coincides with world `onto`."""
    return (onto * frm.inverse()) * solid
