audiodestrukt/freedj-esp/p4/deck/main/main.cpp

// SPDX-FileCopyrightText: 2026 Dan Newcome
// SPDX-License-Identifier: GPL-3.0-or-later
// P4 deck: browse a rekordbox USB stick and the SD card with the DJ2Go or the
// touch screen, stream a WAV/MP3 through a PSRAM window, and play it
// CDJ-style on the board speaker. The screen (ui.cpp) shows the list, time,
// tempo and state. On Pro DJ Link (prolink.cpp) it follows the tempo master
// when SYNC is on, using the track's rekordbox beat grid.
//
// Deck A controls:
//   browse knob      move through the track list (also touch: tap a row,
//                    tap it again to load)
//   LOAD A / ENTER   load the selected track (stops the deck)
//   PLAY             play / pause
//   CUE              playing: jump to cue and pause
//                    paused:  set cue here, play while held, return on release
//   pitch fader      ±8 % tempo
//   jog              playing: nudge; paused: scrub
//   SYNC             beat sync to the Link tempo master on/off (needs a
//                    rekordbox track); keylock is on the screen's KEY chip
//   channel volume   level

#include <math.h>
#include <stdint.h>
#include <stdlib.h>
#include <stdio.h>
#include <string.h>
#include "freertos/FreeRTOS.h"
#include "freertos/queue.h"
#include "freertos/semphr.h"
#include "freertos/task.h"
#include "esp_log.h"
#include "esp_timer.h"
#include "esp_heap_caps.h"
#include "driver/uart.h"

#include "audio_out.h"
#include "deck_event.h"
#include "dj2go.h"
#include "xdj_midi.h"
#include "library.h"
#include "net.h"
#include "prolink.h"
#include "rekordbox.h"
#include "sd.h"
#include "stream.h"
#include "ui.h"
#include "usb_midi.h"
#include "usb_stick.h"
#include "usb_audio.h"
#include "vinyl.h"
#include "as5600.h"
#include "panel_gpio.h"
#include "wsola.h"

static const char* TAG = "deck";

constexpr uint32_t kRate       = 44100;
constexpr int      kBlock      = 256;    // frames per write (~5.8 ms)
// ── Feel ──────────────────────────────────────────────────────────────────────
// How the deck responds to hands. Documented, with what to compare against,
// in the README ("Feel parameters"). Tune here.
//
// Pitch fader ranges, as on the XDJ: ±6, ±10 (default), ±16 %, WIDE (±100 %).
constexpr float    kRanges[] = {0.06f, 0.10f, 0.16f, 1.0f};
// Scratch (jog while paused): track moved per jog tick. 441 frames = 10 ms.
constexpr int      kScrubFrames = 441;
// Scratch: the playhead chases the jog's target, closing the gap over about
// this many output frames (1024 = 23 ms). Lower = tighter, rougher.
constexpr double   kScratchChase = 4.0 * 256;
// Scratch: top speed, as a multiple of normal (either direction).
constexpr double   kScratchMaxSpeed = 8.0;
// Nudge (jog while playing): speed change per tick, the most it can add up
// to, and how fast it fades (per 5.8 ms block).
constexpr float    kNudgePerTick = 0.004f, kNudgeMax = 0.3f, kNudgeDecay = 0.97f;
// Beat sync: fraction of the phase error corrected per beat-ish, and the
// most the tempo may bend to do it.
constexpr float    kSyncGain = 0.3f, kSyncMaxBend = 0.03f;
// The bend is low-passed (one pole, per 5.8 ms block, ~0.3 s) so beat-packet
// jitter on the network doesn't wobble the speed; the phase loop itself takes
// ~1.7 s at 120 BPM, so this barely slows it.
constexpr float    kSyncBendSmooth = 0.02f;
// Timecode vinyl: per-block smoothing of the record's speed (0.35 at 5.8 ms
// blocks is ~15 ms, quick enough for a hand on the platter), and below this
// speed keylock hands over to varispeed.
constexpr float    kVinylSmooth = 0.35f;
constexpr float    kVinylKeylockMin = 0.5f;
// Absolute mode: jump to the record's position when the track is this far
// off it (a needle drop), at most this often. Steady play stays within a few
// ms (speed alone keeps it there), and a scratch is followed by speed, so only
// a real jump seeks. Same numbers as the A1S.
constexpr int      kVinylSeekMs = 300;
constexpr int      kVinylSeekGapMs = 250;
// ...and smaller steady errors (after a scratch, or a seek that had to wait
// for the decoder) get re-synced once they've held kVinylTrimHoldMs, and only
// when the audio there is already decoded, so the fix can't stall.
constexpr int      kVinylTrimMs = 25;
constexpr int      kVinylTrimHoldMs = 200;
// What we hear lags the playhead and the record's position lags the record:
// I2S DMA (~33 ms) + USB output ring (~23 ms) + USB input (~5 ms). Aim the
// playhead this far ahead of the record so the sound lines up with it.
constexpr int      kVinylLeadMs = 60;
// Track list on screen: jog ticks per row (AS5600: 180 ticks/rev, so 30 rows a turn).
constexpr int      kBrowseTicksPerRow = 6;
// THRU (a real record through the interface): keep this much input queued,
// enough to ride out its 4 ms bursts (~11.6 ms extra latency). Its clock and
// ours differ, so when the average strays kThruSlack from it, a block reads
// one frame more or less (stretched over the block: 0.4 %, a few blocks a minute).
constexpr int      kThruFill  = 512;
constexpr int      kThruSlack = 64;
// ──────────────────────────────────────────────────────────────────────────────

constexpr uint8_t  kLinkPlayer = 2;      // our Pro DJ Link player number
// Audio queued between the audio task and the speaker: the I2S driver's
// default 6 DMA buffers x 240 frames, plus about half a block in flight.
constexpr int      kOutLatencyFrames = 6 * 240 + kBlock / 2;

static QueueHandle_t s_events;      // deck::Event, USB task → audio task
// Load (or eject) request, audio task / USB task → loader. Carries the
// paths, not a list index: the list can change while a request is queued.
struct LoadReq {
    bool eject = false;             // close the stream if it's on the USB stick
    char path[200] = "";
    char anlz[200] = "";
};
static QueueHandle_t s_loadReq;     // LoadReq → loader
static QueueHandle_t s_loadDone;    // bool ok, loader → audio task
static QueueHandle_t s_ejected;     // bool, loader → audio task: the loaded track's stick is gone
static SemaphoreHandle_t s_ejectDone;   // loader → USB task: nothing open on the stick
struct Pick { int index; uint32_t gen; };
static QueueHandle_t s_select;      // Pick (list index + list generation), screen → audio task
static QueueHandle_t s_seekReq;     // float 0..1, overview needle search → audio task (latest wins)
static TrackStream s_stream;        // deck A
static dj2go::Decoder s_decoder;
static xdj::Decoder s_xdj;
static wsola::Wsola s_wsola;        // ~40 KB, keep out of task stacks
// Beat grid of the loaded track, double-buffered because the screen draws
// from it too: the loader (or the test hook) fills the spare one and the audio
// task swaps it in, so nobody ever reads a grid that is being rewritten.
static rekordbox::Grid s_gridBuf[2];
static rekordbox::Grid* s_gridLive = &s_gridBuf[0];
static rekordbox::Grid& grid() { return *s_gridLive; }
static rekordbox::Grid& spareGrid() { return s_gridLive == &s_gridBuf[0] ? s_gridBuf[1] : s_gridBuf[0]; }
static void swapGrid() { s_gridLive = &spareGrid(); ui::setGrid(s_gridLive); }
static volatile int s_syncOffsetMs; // serial [ / ]: trim our phase against the master
static volatile int s_fakeGridBpm;
static volatile int s_jogTicks;     // jog ticks since the last serial J (calibration)  // serial g: test grid for a track without rekordbox analysis

static bool s_vinylStill;          // the record drives the deck but isn't moving: the jog scratches (audio task)
static volatile bool s_midiLog;   // serial I: print raw USB-MIDI packets (mapping new controllers)

static void onMidiPacket(const uint8_t p[4])
{
    if (s_midiLog) ESP_LOGI(TAG, "midi %02X %02X %02X %02X", p[0], p[1], p[2], p[3]);
    deck::Event ev[2];
    int n = usb_midi::vendor() == 0x2B73 ? s_xdj.decodeUsbPacket(p, ev, 2)    // Pioneer XDJ, USB MIDI mode
                                         : s_decoder.decodeUsbPacket(p, ev, 2);
    for (int i = 0; i < n; i++) {
        // Screen-only: toggled here, as the audio task mustn't take the LVGL lock.
        if (ev[i].type == deck::Type::MeterView) { if (ev[i].pressed) ui::togglePhaseView(); continue; }
        // DJ2Go pitch bend - is key lock; with a USB audio input it's THRU instead
        // (swap the timecode record for a real one without the touch screen).
        if (ev[i].type == deck::Type::KeyLock && usb_midi::vendor() != 0x2B73 && usb_audio::inputActive()) {
            if (ev[i].pressed) vinyl::toggleThru();
            continue;
        }
        xQueueSend(s_events, &ev[i], 0);
    }
}

// Owns the SD card: opens tracks on request and keeps the stream window
// filled. Runs on core 0, away from the audio task.
static void loaderTask(void*)
{
    static LoadReq req;           // static: 400 bytes, keep off the stack
    static char openPath[200];    // what the stream has open
    for (;;) {
        if (xQueueReceive(s_loadReq, &req, 0) == pdTRUE && req.eject) {
            // The stick was pulled. Close the stream if it reads from it,
            // tell the deck, then let the USB task unmount.
            if (s_stream.isOpen() && !strncmp(openPath, usb_stick::kMount, strlen(usb_stick::kMount))) {
                s_stream.detach();   // file closed; the decoded audio stays for an emergency loop
                openPath[0] = 0;
                const bool gone = true;
                xQueueOverwrite(s_ejected, &gone);
            }
            xSemaphoreGive(s_ejectDone);
        } else if (req.path[0]) {
            bool ok = s_stream.open(req.path);
            strlcpy(openPath, ok ? req.path : "", sizeof openPath);
            req.path[0] = 0;                  // handled
            spareGrid().beats.clear();
            spareGrid().preview.clear();
            spareGrid().cues.clear();
            spareGrid().color.clear();
            if (ok && req.anlz[0]) {
                rekordbox::readAnlz(req.anlz, nullptr, &spareGrid().beats, &spareGrid().preview);
                spareGrid().cues = rekordbox::readCues(req.anlz);
                spareGrid().color = rekordbox::readColorWave(req.anlz);
            }
            // Prefill ~1 s before handing over so PLAY starts clean.
            while (ok && s_stream.buffered() < 44100 && s_stream.service()) {}
            xQueueSend(s_loadDone, &ok, portMAX_DELAY);
        }
        if (!s_stream.service()) vTaskDelay(pdMS_TO_TICKS(5) ? pdMS_TO_TICKS(5) : 1);
        // Full speed until ~8 s are decoded ahead (after a load or a needle
        // jump), then pace the rest of the window. Unpaced, refilling 70 s
        // of MP3 from the stick held core 0 at 100 % and the screen at 9 fps
        // for several seconds.
        else if (s_stream.ahead() > 8 * s_stream.sampleRate()) vTaskDelay(pdMS_TO_TICKS(15));
    }
}

struct Deck {
    bool   loaded    = false;
    bool   loading   = false;
    bool   playing   = false;
    bool   previewing = false;  // CUE held from pause
    bool   keylock   = false;
    bool   sync      = false;   // follow the Link tempo master
    bool   alignNext = false;   // snap our beat phase to the master before the next block
    // Loops. One active region at a time: a beat loop, a manual in/out
    // loop, a hot loop, or the emergency loop (the track's media was pulled
    // mid-play, so it loops 4 beats of what's already decoded, as a CDJ does,
    // until another track loads).
    bool   looping   = false;
    bool   emergency = false;
    double loopStart = 0, loopEnd = 0;  // frames; kept after exit for RELOOP
    double loopBeats = 0;               // > 0: a beat-sized loop (halve/double in beats)
    bool   loopInSet = false;           // manual LOOP IN pressed, waiting for OUT
    double loopIn    = 0;
    bool   quantize  = true;            // XDJ default
    struct HotCue { bool set = false, loop = false; double start = 0, end = 0; };
    HotCue hot[8];                      // A..H
    static constexpr int kMaxMem = 16;
    double mem[kMaxMem];                // memory cues, sorted (frames)
    int    nMem = 0;
    // Tempo: fader position, range, and TEMPO RESET (play at 0 %).
    float  fader     = 0.5f;
    int    range     = 1;               // index into kRanges
    bool   tempoReset = false;
    // Slip: while a loop, reverse or held hot cue plays, a shadow playhead
    // keeps going at normal speed; letting go resumes from it.
    bool   slip      = false;
    double slipPos   = 0;
    bool   hotHeld   = false;           // a hot cue pad is held (momentary in slip)
    bool   reverse   = false;
    // Paused jog = scratch: the jog moves a target, the playhead chases it
    // and the audio plays at whatever speed (and direction) that takes.
    bool   scratching = false;
    double scratchTarget = 0;
    double pos       = 0;       // frames into track (fractional for varispeed)
    double cue       = 0;
    float  tempo     = 1.0f;
    float  nudge     = 0.0f;
    float  gain      = 0.7f;
    int    selected  = 0;
    library::Ptr lib;           // the list `selected` indexes
    uint32_t libGen  = 0;
};

static void logSelection(const Deck& d)
{
    if (!d.lib || d.lib->empty()) { ESP_LOGW(TAG, "no tracks"); return; }
    ESP_LOGI(TAG, "> [%d/%d] %s", d.selected + 1, d.lib->size(), d.lib->name(d.selected));
}

// The list changed (stick in or out): follow it, keeping the selection on
// the same track when it's still there.
static void followLibrary(Deck& d)
{
    const uint32_t gen = library::generation();
    if (gen == d.libGen) return;
    library::Ptr next = library::get();
    int sel = 0;
    if (d.lib && next && d.selected < d.lib->size()) {
        const int same = next->find(d.lib->path(d.selected));
        if (same >= 0) sel = same;
    }
    d.lib = next;
    d.libGen = gen;
    d.selected = sel;
}

static void seek(Deck& d, double frame)
{
    if (frame < 0) frame = 0;
    if (frame > s_stream.frames()) frame = s_stream.frames();
    d.pos = frame;
    s_stream.setPlayhead((size_t)frame);
    s_wsola.reset();
    d.scratching = false;
}

// ── Performance: cues, loops, beat jump, quantize ───────────────────────────
// Positions are in track frames; the rekordbox grid converts to beats.
static double rate() { return s_stream.sampleRate() ? s_stream.sampleRate() : kRate; }
static double beatOf(double frame) { return grid().beatAt(frame * 1000.0 / rate()); }
static double frameOf(double beat) { return grid().msAt(beat) * rate() / 1000.0; }

// Quantize: snap to the nearest beat (needs a grid).
static double snap(const Deck& d, double frame)
{
    if (!d.quantize || grid().empty()) return frame;
    return frameOf(floor(beatOf(frame) + 0.5));
}

// Jump to `target`. Quantized and playing, land at the same point within the
// beat as we left, so the track keeps its time (and stays in sync).
static void jumpTo(Deck& d, double target)
{
    if (d.quantize && d.playing && !grid().empty()) {
        const double b = beatOf(d.pos);
        target = frameOf(floor(beatOf(target) + 0.5) + (b - floor(b)));
    } else if (d.sync && d.playing) {
        d.alignNext = true;
    }
    seek(d, target);
}

static void setLoop(Deck& d, double start, double end, double beats)
{
    d.loopStart = start;
    d.loopEnd = end;
    d.loopBeats = beats;
    d.looping = end > start;
    if (d.looping && (d.pos >= end || d.pos < start))      // keep the playhead inside, same phase
        d.pos = start + fmod(fmax(0, d.pos - start), end - start);
}

static void resize(Deck& d, double factor)
{
    if (!d.looping || d.emergency) return;
    if (d.loopBeats > 0 && !grid().empty()) {
        const double nb = d.loopBeats * factor;
        if (nb < 1.0 / 32 || nb > 32) return;
        setLoop(d, d.loopStart, frameOf(beatOf(d.loopStart) + nb), nb);
    } else {
        const double len = (d.loopEnd - d.loopStart) * factor;
        if (len < 32) return;
        setLoop(d, d.loopStart, d.loopStart + len, 0);
    }
    ESP_LOGI(TAG, "loop %s", factor < 1 ? "1/2" : "x2");
}

// Hot cues and memory cues from the track's rekordbox analysis.
static void loadCues(Deck& d)
{
    for (auto& h : d.hot) h = Deck::HotCue{};
    d.nMem = 0;
    const double r = rate() / 1000.0;
    for (const auto& c : grid().cues) {
        if (c.hot >= 1 && c.hot <= 8) {
            auto& h = d.hot[c.hot - 1];
            h.set = true; h.loop = c.loop; h.start = c.ms * r; h.end = c.loopMs * r;
        } else if (c.hot == 0 && d.nMem < Deck::kMaxMem) {
            d.mem[d.nMem++] = c.ms * r;                     // sorted by readCues
        }
    }
    int hots = 0;
    for (auto& h : d.hot) hots += h.set;
    if (hots || d.nMem) ESP_LOGI(TAG, "cues: %d hot, %d memory", hots, d.nMem);
    // Like a CDJ, start at the first memory cue.
    if (d.nMem) { d.cue = d.mem[0]; seek(d, d.cue); }
}

static void apply(Deck& d, const deck::Event& e)
{
    using deck::Type;
    // Browsing without touch. With the track list on screen, the jog scrolls it
    // and PLAY loads (on release; the list goes and the jog is a jog again).
    // Anywhere, hold PLAY and turn the jog: it scrolls (and brings up) the list.
    // PLAY still acts on press, so the first tick undoes that press.
    static bool playHeld, playBrowsed, playWas, listAtPress;
    static double playPos;
    if (e.deck == deck::DeckA && e.type == Type::PlayPause) {
        if (e.pressed) {
            playHeld = true; playBrowsed = false; playWas = d.playing; playPos = d.pos;
            listAtPress = ui::listShown();
            if (listAtPress) return;               // the list: load on release
        } else {
            playHeld = false;
            if (!playBrowsed && listAtPress)
                apply(d, deck::Event{.type = Type::Load, .deck = deck::DeckA, .pressed = true});
            return;
        }
    }
    if (e.deck == deck::DeckA && e.type == Type::Jog && (playHeld || ui::listShown())) {
        if (playHeld && !playBrowsed) {
            playBrowsed = true;
            if (d.playing != playWas) {            // undo the press
                d.playing = playWas;
                if (!playWas) seek(d, playPos);
            }
        }
        static int acc;
        acc += e.delta;
        const int rows = acc / kBrowseTicksPerRow;
        acc -= rows * kBrowseTicksPerRow;
        if (rows) apply(d, deck::Event{.type = Type::Browse, .deck = deck::DeckAny, .delta = (int16_t)rows});
        return;
    }
    if (e.type == Type::Browse) {
        const int n = d.lib ? d.lib->size() : 0;
        if (n) { d.selected = ((d.selected + e.delta) % n + n) % n; logSelection(d); }
        return;
    }
    if (e.type == Type::Load && e.pressed && (e.deck == deck::DeckA || e.deck == deck::DeckAny)) {
        if (!d.lib || d.lib->empty() || d.loading) return;
        static LoadReq req;
        req = LoadReq{};
        strlcpy(req.path, d.lib->path(d.selected), sizeof req.path);
        strlcpy(req.anlz, d.lib->anlz(d.selected), sizeof req.anlz);
        if (xQueueSend(s_loadReq, &req, 0) != pdTRUE) return;
        d.playing = d.previewing = false;
        d.loaded = false;
        d.emergency = d.looping = d.loopInSet = false;
        d.loading = true;
        ui::listDone();
        ESP_LOGI(TAG, "loading…");
        return;
    }
    if (e.deck != deck::DeckA) return;
    switch (e.type) {
    case Type::PlayPause:
        if (e.pressed && d.loaded) {
            d.scratching = false;
            d.playing = !d.playing; d.previewing = false;
            if (d.playing && d.sync) d.alignNext = true;   // start on the master's beat
        }
        break;
    case Type::Cue:
        if (!d.loaded || d.emergency) break;   // no media to cue from
        if (e.pressed) {
            if (d.playing) { seek(d, d.cue); d.playing = false; }
            else { d.cue = snap(d, d.pos); if (d.cue != d.pos) seek(d, d.cue); d.previewing = true; d.playing = true; }
        } else if (d.previewing) {
            d.previewing = false; d.playing = false; seek(d, d.cue);
        }
        break;
    case Type::HotCue: {
        const int i = e.delta - 1;
        if (!e.pressed) {                            // pad released: in slip, a hot cue is momentary
            if (d.hotHeld) { d.hotHeld = false; if (d.slip) d.looping = false; }
            break;
        }
        if (!d.loaded || d.emergency || i < 0 || i > 7) break;
        auto& h = d.hot[i];
        const char letter = 'A' + i;
        if (e.position > 0.5f) { h = Deck::HotCue{}; ESP_LOGI(TAG, "hot cue %c deleted", letter); break; }
        if (!h.set) {                                // empty: store here (or the active loop)
            h.set = true;
            h.loop = d.looping;
            h.start = d.looping ? d.loopStart : snap(d, d.pos);
            h.end = d.looping ? d.loopEnd : 0;
            ESP_LOGI(TAG, "hot cue %c set%s", letter, h.loop ? " (loop)" : "");
        } else {
            jumpTo(d, h.start);
            if (h.loop) setLoop(d, h.start, h.end, grid().empty() ? 0 : beatOf(h.end) - beatOf(h.start));
            else d.looping = false;
            if (!d.playing) { d.playing = true; if (d.sync) d.alignNext = true; }   // like a CDJ: plays from the cue
            d.previewing = false;
            d.hotHeld = true;
        }
        break;
    }
    case Type::BeatLoop: {
        if (!e.pressed || !d.loaded || d.emergency) break;
        if (grid().empty()) { ESP_LOGW(TAG, "beat loop needs a beat grid"); break; }
        const double beats = e.position > 0 ? e.position : 4;
        const double start = d.quantize ? frameOf(floor(beatOf(d.pos) + 1e-6)) : d.pos;
        setLoop(d, start, frameOf(beatOf(start) + beats), beats);
        ESP_LOGI(TAG, "loop %g beat%s", beats, beats == 1 ? "" : "s");
        break;
    }
    case Type::LoopIn:
        if (!e.pressed || !d.loaded || d.emergency) break;
        d.loopIn = snap(d, d.pos);
        d.loopInSet = true;
        break;
    case Type::LoopOut:
        if (!e.pressed || !d.loaded || d.emergency) break;
        if (d.looping) { d.looping = false; ESP_LOGI(TAG, "loop exit"); break; }  // no RELOOP button on the DJ2Go
        if (d.loopInSet && snap(d, d.pos) > d.loopIn) {
            const double end = snap(d, d.pos);
            setLoop(d, d.loopIn, end, 0);
            d.loopInSet = false;
            ESP_LOGI(TAG, "loop in/out %.2f s", (end - d.loopStart) / rate());
        }
        break;
    case Type::ReloopExit:
        if (!e.pressed || !d.loaded || d.emergency) break;
        if (d.looping) d.looping = false;
        else if (d.loopEnd > d.loopStart) { jumpTo(d, d.loopStart); setLoop(d, d.loopStart, d.loopEnd, d.loopBeats); }
        ESP_LOGI(TAG, "%s", d.looping ? "reloop" : "loop exit");
        break;
    case Type::LoopHalve:  if (e.pressed) resize(d, 0.5); break;
    case Type::LoopDouble: if (e.pressed) resize(d, 2.0); break;
    case Type::BeatJump: {
        if (!e.pressed || !d.loaded || d.emergency || e.delta == 0) break;
        if (grid().empty()) { seek(d, d.pos + e.delta * 0.5 * rate()); break; }
        const double to = frameOf(beatOf(d.pos) + e.delta);
        if (d.looping) {                                     // a jump moves the loop with it
            const double shift = to - d.pos;
            d.loopStart += shift; d.loopEnd += shift;
        }
        seek(d, to);
        break;
    }
    case Type::CueCall: {
        if (!e.pressed || !d.loaded || d.emergency || d.nMem == 0) break;
        const double eps = 0.05 * rate();
        int pick = -1;
        if (e.delta > 0) { for (int i = 0; i < d.nMem; i++) if (d.mem[i] > d.pos + eps) { pick = i; break; } }
        else { for (int i = d.nMem - 1; i >= 0; i--) if (d.mem[i] < d.pos - eps) { pick = i; break; } }
        if (pick < 0) break;
        d.cue = d.mem[pick];
        d.looping = false;
        jumpTo(d, d.cue);
        ESP_LOGI(TAG, "call memory cue %d/%d", pick + 1, d.nMem);
        break;
    }
    case Type::Quantize:
        if (e.pressed) { d.quantize = !d.quantize; ESP_LOGI(TAG, "quantize %s", d.quantize ? "on" : "off"); }
        break;
    case Type::TempoFader:
        d.fader = e.position;
        if (!d.tempoReset) d.tempo = 1.0f + (d.fader - 0.5f) * 2.0f * kRanges[d.range];
        break;
    case Type::TempoRange:
        if (!e.pressed) break;
        d.range = (d.range + 1) % 4;
        if (!d.tempoReset && !d.sync) d.tempo = 1.0f + (d.fader - 0.5f) * 2.0f * kRanges[d.range];
        ESP_LOGI(TAG, "tempo range %s", d.range == 3 ? "WIDE" : d.range == 0 ? "6 %" : d.range == 1 ? "10 %" : "16 %");
        break;
    case Type::TempoReset:
        if (!e.pressed) break;
        d.tempoReset = !d.tempoReset;
        if (!d.sync) d.tempo = d.tempoReset ? 1.0f : 1.0f + (d.fader - 0.5f) * 2.0f * kRanges[d.range];
        ESP_LOGI(TAG, "tempo reset %s", d.tempoReset ? "on" : "off");
        break;
    case Type::MemoryAdd: {
        if (!e.pressed || !d.loaded || d.emergency) break;
        const double at = d.looping ? d.loopStart : d.cue;
        for (int i = 0; i < d.nMem; i++) if (fabs(d.mem[i] - at) < 0.01 * rate()) return;   // already there
        if (d.nMem >= Deck::kMaxMem) break;
        int i = d.nMem++;
        while (i > 0 && d.mem[i - 1] > at) { d.mem[i] = d.mem[i - 1]; i--; }
        d.mem[i] = at;
        ESP_LOGI(TAG, "memory cue stored (%d); this session only, not written to the stick", d.nMem);
        break;
    }
    case Type::MemoryDelete: {
        if (!e.pressed || !d.loaded) break;
        int pick = -1;
        for (int i = 0; i < d.nMem; i++)
            if (fabs(d.mem[i] - d.cue) < 0.1 * rate() || fabs(d.mem[i] - d.pos) < 0.1 * rate()) { pick = i; break; }
        if (pick < 0) break;
        for (int i = pick; i + 1 < d.nMem; i++) d.mem[i] = d.mem[i + 1];
        d.nMem--;
        ESP_LOGI(TAG, "memory cue deleted (%d left)", d.nMem);
        break;
    }
    case Type::Slip:
        if (e.pressed) { d.slip = !d.slip; d.slipPos = d.pos; ESP_LOGI(TAG, "slip %s", d.slip ? "on" : "off"); }
        break;
    case Type::Reverse:
        if (!e.pressed || !d.loaded || d.emergency) break;
        d.reverse = !d.reverse;
        s_wsola.reset();
        if (!d.reverse && d.sync && !d.slip) d.alignNext = true;
        ESP_LOGI(TAG, "reverse %s", d.reverse ? "on" : "off");
        break;
    case Type::Jog:
        s_jogTicks += e.delta;                           // for jog calibration (serial J)
        if (d.playing && !s_vinylStill) d.nudge += e.delta * kNudgePerTick;
        else if (d.loaded && !d.emergency) {
            if (!d.scratching) { d.scratching = true; d.scratchTarget = d.pos; s_wsola.reset(); }
            d.scratchTarget += e.delta * kScrubFrames;
            if (d.scratchTarget < 0) d.scratchTarget = 0;
            if (d.scratchTarget > s_stream.frames()) d.scratchTarget = s_stream.frames();
        }
        break;
    case Type::Sync:
        if (e.pressed) {
            d.sync = !d.sync;
            // Off: the deck keeps the synced tempo until the fader moves.
            if (d.sync) d.alignNext = d.playing;
        }
        break;
    case Type::KeyLock:
        if (e.pressed) { d.keylock = !d.keylock; s_wsola.reset(); }
        break;
    case Type::Volume:
        d.gain = e.position;
        break;
    default: break;
    }
}

// Varispeed: read at a fractional rate with linear interpolation. Pitch
// follows speed, like a turntable. Also absorbs file/output rate mismatch.
// Returns false on a stream underrun (window not filled yet).
static bool renderPitched(Deck& d, float speed, int16_t* out)
{
    const double step = (d.reverse ? -1 : 1) * speed * (double)s_stream.sampleRate() / kRate;
    for (int i = 0; i < kBlock; i++) {
        if (d.pos < 0) { d.pos = 0; memset(out + 2 * i, 0, (kBlock - i) * 4); d.playing = false; return true; }  // reversed to 0:00
        const size_t i0 = (size_t)d.pos;
        if (i0 + 1 >= s_stream.frames()) { memset(out + 2 * i, 0, (kBlock - i) * 4); d.playing = false; return true; }
        int16_t two[4];
        if (!s_stream.get(i0, two, 2)) { memset(out + 2 * i, 0, (kBlock - i) * 4); return false; }
        const float fr = (float)(d.pos - i0);
        out[2 * i]     = (int16_t)(two[0] + fr * (two[2] - two[0]));
        out[2 * i + 1] = (int16_t)(two[1] + fr * (two[3] - two[1]));
        d.pos += step;
        if (d.looping && d.pos >= d.loopEnd) d.pos -= d.loopEnd - d.loopStart;
        else if (d.looping && d.reverse && d.pos < d.loopStart) d.pos += d.loopEnd - d.loopStart;
    }
    return true;
}

// THRU: the USB interface's input straight out, the deck bypassed.
static volatile uint32_t s_thruUnderruns, s_thruTrims;
static bool s_thruPrimed;
static void renderThru(int16_t* out)
{
    static int16_t in[(kBlock + 1) * 2];
    static float avg;
    size_t fill = usb_audio::inputFill();
    if (!s_thruPrimed) {
        // Wait for a cushion, then drop anything beyond it (stale input).
        if (fill < (size_t)kThruFill) { memset(out, 0, kBlock * 4); return; }
        while (fill > (size_t)kThruFill) {
            const size_t n = usb_audio::read(in, fill - kThruFill > kBlock ? kBlock : fill - kThruFill);
            if (!n) break;
            fill -= n;
        }
        avg = kThruFill;
        s_thruPrimed = true;
    }
    avg += 0.02f * ((float)fill - avg);
    int want = kBlock;
    if (avg > kThruFill + kThruSlack) want++;        // the input runs fast: catch up a frame
    else if (avg < kThruFill - kThruSlack) want--;   // slow: stretch a frame
    if (want != kBlock) s_thruTrims = s_thruTrims + 1;
    const int n = (int)usb_audio::read(in, want);
    if (n < want) {   // ran dry: play what came, re-prime
        s_thruUnderruns = s_thruUnderruns + 1;
        s_thruPrimed = false;
        memcpy(out, in, n * 4);
        memset(out + n * 2, 0, (kBlock - (n < kBlock ? n : kBlock)) * 4);
        return;
    }
    if (want == kBlock) { memcpy(out, in, kBlock * 4); return; }
    // want input frames onto kBlock output frames, linearly.
    const float step = (float)(want - 1) / (kBlock - 1);
    for (int i = 0; i < kBlock; i++) {
        const float x = i * step;
        const int j = (int)x;
        const float f = x - j;
        const int k = j + 1 < want ? j + 1 : j;
        out[2 * i]     = (int16_t)(in[2 * j]     + f * (in[2 * k]     - in[2 * j]));
        out[2 * i + 1] = (int16_t)(in[2 * j + 1] + f * (in[2 * k + 1] - in[2 * j + 1]));
    }
}

// Scratch (paused jog): each output frame moves the playhead a fraction of
// the way to the target, so speed and direction follow the hand and glide to
// a stop. Linear interpolation, like varispeed. Returns false once it has
// arrived (nothing more to play).
static bool renderScratch(Deck& d, int16_t* out)
{
    bool moving = false;
    for (int i = 0; i < kBlock; i++) {
        double step = (d.scratchTarget - d.pos) / kScratchChase;
        if (step > kScratchMaxSpeed) step = kScratchMaxSpeed;
        if (step < -kScratchMaxSpeed) step = -kScratchMaxSpeed;
        if (fabs(d.scratchTarget - d.pos) < 0.5) step = 0;
        if (step != 0) moving = true;
        const size_t i0 = (size_t)d.pos;
        int16_t two[4];
        if (step == 0 || !s_stream.get(i0, two, 2)) { out[2 * i] = out[2 * i + 1] = 0; continue; }
        const float fr = (float)(d.pos - i0);
        out[2 * i]     = (int16_t)(two[0] + fr * (two[2] - two[0]));
        out[2 * i + 1] = (int16_t)(two[1] + fr * (two[3] - two[1]));
        d.pos += step;
        if (d.pos < 0) d.pos = 0;
    }
    return moving;
}

// Keylock: feed WSOLA at the output rate (resampling the file to 44.1 kHz
// first, so a 48 kHz track isn't heard 8.8 % slow and flat), let it
// stretch to `speed`.
static bool renderKeylock(Deck& d, float speed, int16_t* out)
{
    constexpr int kFeed = 512;
    static int16_t feed[kFeed * 2];
    static int16_t raw[(kFeed * 3 + 4) * 2];          // file frames for one feed (rates up to 3x 44.1k)
    const double step = (double)s_stream.sampleRate() / kRate;
    s_wsola.setSpeed(speed);
    int got = 0;
    while (got < kBlock) {
        got += s_wsola.pullFrames(out + 2 * got, kBlock - got);
        if (got >= kBlock) break;
        if (d.looping && d.pos >= d.loopEnd) d.pos -= d.loopEnd - d.loopStart;
        const size_t base = (size_t)d.pos;
        const size_t total = s_stream.frames();
        if (base + 1 >= total) { memset(out + 2 * got, 0, (kBlock - got) * 4); d.playing = false; return true; }
        // How many output-rate frames fit before the end of the track.
        int n = s_wsola.inputCapacity();
        if (n > kFeed) n = kFeed;
        const double frac = d.pos - base;
        const int fit = (int)((total - 1 - base - frac) / step);
        if (n > fit) n = fit;
        if (d.looping) {                        // stop at the loop end; wrap next pass
            const int toEnd = (int)((d.loopEnd - d.pos) / step) + 1;
            if (n > toEnd) n = toEnd;
        }
        if (n <= 0) { memset(out + 2 * got, 0, (kBlock - got) * 4); d.playing = false; return true; }
        // Linear-interpolate n frames at `step` out of a contiguous run of file frames.
        const size_t span = (size_t)(frac + (n - 1) * step) + 2;
        if (!s_stream.get(base, raw, span)) { memset(out + 2 * got, 0, (kBlock - got) * 4); return false; }
        for (int i = 0; i < n; i++) {
            const double x = frac + i * step;
            const size_t j = (size_t)x;
            const float f = (float)(x - j);
            const int16_t* a0 = raw + 2 * j;
            feed[2 * i]     = (int16_t)(a0[0] + f * (a0[2] - a0[0]));
            feed[2 * i + 1] = (int16_t)(a0[1] + f * (a0[3] - a0[1]));
        }
        d.pos += s_wsola.pushFrames(feed, n) * step;
    }
    return true;
}

// The loaded track's media is gone while playing: loop 4 beats from the
// current beat out of what's already decoded (2 s without a grid). Whole
// beats, so SYNC stays locked through the loop.
static void startEmergencyLoop(Deck& d)
{
    const double rate = s_stream.sampleRate();
    int16_t probe[2];
    if (!grid().empty()) {
        const double b = floor(grid().beatAt(d.pos * 1000.0 / rate));
        d.loopStart = grid().msAt(b) * rate / 1000.0;
        d.loopEnd = grid().msAt(b + 4) * rate / 1000.0;
        // Not decoded that far ahead: loop the 4 beats before instead.
        if (!s_stream.get((size_t)d.loopEnd + 1, probe, 1)) {
            d.loopEnd = d.loopStart;
            d.loopStart = grid().msAt(b - 4) * rate / 1000.0;
        }
    } else {
        d.loopStart = d.pos;
        d.loopEnd = d.pos + 2 * rate;
        if (!s_stream.get((size_t)d.loopEnd + 1, probe, 1)) { d.loopEnd = d.pos; d.loopStart = d.pos - 2 * rate; }
    }
    if (d.loopStart < 0) d.loopStart = 0;
    if (!s_stream.get((size_t)d.loopStart, probe, 1) || d.loopEnd <= d.loopStart) {
        d.loaded = d.playing = false;                  // nothing usable decoded: stop
        ESP_LOGW(TAG, "track's USB stick removed: nothing buffered to loop, unloaded");
        return;
    }
    d.emergency = true;
    d.looping = true;
    d.loopBeats = 0;
    if (d.pos >= d.loopEnd || d.pos < d.loopStart) d.pos = d.loopStart;
    ESP_LOGW(TAG, "track's USB stick removed: EMERGENCY LOOP %.2f s (load another track to leave it)",
             (d.loopEnd - d.loopStart) / rate);
}

// ── Beat sync ────────────────────────────────────────────────────────────────
// Track time (ms) of what is coming out of the speaker now: the playhead
// minus the audio still queued in the DMA (and in WSOLA, in keylock).
static double s_wsolaLag;   // smoothed: the raw estimate is a sawtooth (input arrives in 512-frame chunks)

// Once per block. Approximate: input WSOLA holds (its 4096-frame buffer
// minus free space) beyond the middle of the frame it is windowing, plus
// output it has made but not handed over. Trim the rest with [ ].
static void stepWsolaLag(float speed)
{
    const int held = 4096 - s_wsola.inputCapacity() - wsola::Wsola::FRAME_N / 2;
    const double raw = (held > 0 ? held : 0) + s_wsola.outputAvailable() * speed;
    s_wsolaLag += (raw - s_wsolaLag) * 0.02;    // ~50 blocks, ~0.3 s
}

static double heardMs(const Deck& d, float speed)
{
    double lagOut = kOutLatencyFrames * speed;               // output-rate frames, in track time
    if (d.keylock) lagOut += s_wsolaLag;
    const double fileRate = s_stream.sampleRate();
    const double frames = d.pos - lagOut * fileRate / kRate;
    return frames * 1000.0 / fileRate + s_syncOffsetMs;
}

// Error between our beat phase and the master's at time `atUs`, in beats,
// -0.5..0.5. Positive: we are ahead.
static double phaseError(double ourBeat, const prolink::Master& m, int64_t atUs)
{
    const double masterBeat = (atUs - m.beatUs) * (double)m.bpm / 60e6;   // beats since its last beat
    double e = ourBeat - masterBeat;
    e -= floor(e + 0.5);
    return e;
}

// The master's tempo as a speed for our track, taking half or double time
// when that's closer (a 70 BPM track against a 140 BPM master plays at 1.0).
static float syncSpeed(float masterBpm, float trackBpm)
{
    float s = masterBpm / trackBpm;
    if (s > 1.5f) s *= 0.5f;
    else if (s < 0.75f) s *= 2.0f;
    return s < 0.5f ? 0.5f : s > 2.0f ? 2.0f : s;
}

struct SyncStats { double errSumMs = 0, errMaxMs = 0; int n = 0; };
static SyncStats s_syncStats;
static float s_syncBend;           // smoothed phase bend (audio task only)

// Click detector on what actually goes to the DAC. A clean signal changes
// slope smoothly; a dropout, a missed block or a bad splice makes the second
// difference spike far above its running average. Exact on a test tone
// (sine.wav); on music, sharp transients can count too, so treat it as a
// hint there. Only measures while playing continuously.
struct ClickProbe {
    int16_t p1 = 0, p2 = 0;
    int     primed = 0;      // samples of history so far
    float   avg = 0;         // running mean |second difference|
    uint32_t clicks = 0;
    int     worst = 0;       // largest |second difference| seen in a click

    void reset() { primed = 0; }
    void feed(const int16_t* lr, int frames)
    {
        for (int i = 0; i < frames; i++) {
            const int x = lr[2 * i];
            if (primed >= 2) {
                const int d2 = abs(x - 2 * p1 + p2);
                if (primed > 2000 && d2 > 1500 && d2 > 8 * avg) {
                    clicks++;
                    if (d2 > worst) worst = d2;
                }
                avg += (d2 - avg) * 0.001f;
            }
            if (primed <= 2000) primed++;
            p2 = p1;
            p1 = x;
        }
    }
};
static ClickProbe s_clicks;

static void onUiEvent(const deck::Event& e) { xQueueSend(s_events, &e, 0); }
static void onUiSelect(int index, uint32_t gen) { Pick p{index, gen}; xQueueSend(s_select, &p, 0); }
static void onStickMounted() { library::scanUsb(usb_stick::kMount); }

// USB task: the stick is gone. Stop the scan, drop its tracks, and close the
// stream if it plays from the stick, before the USB task unmounts it.
static void onStickRemoved()
{
    library::dropUsb();
    static LoadReq eject;
    eject = LoadReq{};
    eject.eject = true;
    xSemaphoreTake(s_ejectDone, 0);
    if (xQueueSend(s_loadReq, &eject, pdMS_TO_TICKS(1000)) == pdTRUE)
        xSemaphoreTake(s_ejectDone, pdMS_TO_TICKS(3000));
}

static void onUiSeek(float fraction) { xQueueOverwrite(s_seekReq, &fraction); }

static prolink::Master s_master;     // audio task's copy, refreshed every block

static uint8_t s_vinylLive;        // ui::State::vinylLive, set by the audio task
static volatile uint32_t s_vinylSeeks;   // seeks to the record (audio task), for the report
static volatile uint32_t s_vinylTrims;   // ...of which small re-syncs
static volatile int s_vinylErrMs;        // playhead - (record + lead), latest while locked
static volatile int s_vinylDriftMs;      // track vs record before the last seek

static void publishState(const Deck& d, float speed)
{
    ui::State u;
    const vinyl::State vs = vinyl::state();
    u.vinylMode = !vs.input ? 0 : 1 + (int)vinyl::mode();
    u.vinylLive = s_vinylLive;
    u.selected = d.selected;
    u.libGen = d.libGen;
    u.loaded = d.loaded;
    u.loading = d.loading;
    u.playing = d.playing;
    u.previewing = d.previewing;
    u.keylock = d.keylock;
    u.emergency = d.emergency;
    u.quantize = d.quantize;
    u.rangePct = (int)lroundf(kRanges[d.range] * 100);
    u.tempoReset = d.tempoReset;
    u.slip = d.slip;
    u.reverse = d.reverse;
    u.slipFrame = (size_t)d.slipPos;
    u.looping = d.looping;
    u.loopStart = (size_t)d.loopStart;
    u.loopEnd = (size_t)d.loopEnd;
    for (int i = 0; i < 8; i++) {
        if (d.hot[i].set) { u.hotSet |= 1 << i; u.hotFrame[i] = (size_t)d.hot[i].start; }
        if (d.hot[i].loop) u.hotLoop |= 1 << i;
    }
    u.nMem = (uint8_t)d.nMem;
    for (int i = 0; i < d.nMem && i < ui::State::kMaxMem; i++) u.memFrame[i] = (size_t)d.mem[i];
    if (d.loaded && !grid().empty()) {
        const double here = beatOf(d.pos);
        auto beatsTo = [&](double frame) { return (int)ceil(beatOf(frame) - here - 1e-6); };
        for (int i = 0; i < d.nMem; i++) if (d.mem[i] > d.pos + 1) { u.barsToMem = beatsTo(d.mem[i]); break; }
        double next = -1;
        for (const auto& h : d.hot) if (h.set && h.start > d.pos + 1 && (next < 0 || h.start < next)) next = h.start;
        if (next >= 0) u.barsToHot = beatsTo(next);
    }
    if (d.loaded) {
        const float rate = s_stream.sampleRate();
        u.pos = d.pos / rate;
        u.len = s_stream.seconds();
        u.cue = d.cue / rate;
        u.frame = (size_t)d.pos;
        u.cueFrame = (size_t)d.cue;
        strlcpy(u.name, s_stream.name(), sizeof u.name);
    }
    // Tempo and BPM as a CDJ shows them: the fader's tempo, or the synced one
    // (d.tempo = master BPM / track BPM). Not `speed`, which adds the jog
    // nudge and sync's phase bend (up to +-3 %, recalculated every block), so
    // the display jumped around while synced.
    (void)speed;
    u.tempoPct = (d.tempo - 1.0f) * 100.0f;
    u.sync = d.sync;
    u.hasGrid = d.loaded && !grid().empty();
    if (u.hasGrid) u.bpm = grid().bpmAt(d.pos * 1000.0 / s_stream.sampleRate()) * d.tempo;
    u.masterPlayer = s_master.present ? s_master.player : 0;
    u.weMaster = prolink::isMaster();
    u.onAir = prolink::onAir();
    u.masterBpm = s_master.bpm;
    // Phase meter: where we are in our beat/bar/phrase as heard, and where the
    // master is in its beat.
    if (u.hasGrid) {
        const double b = grid().beatAt(heardMs(d, speed));
        const long k = (long)floor(b);
        u.beatPhase = (float)(b - k);
        u.beatInBar = (uint8_t)grid().inBarAt(k);
        // Bars counted from the grid's first downbeat.
        const long firstDown = (5 - grid().inBarAt(0)) % 4;     // index of the first beat 1
        const long bar = (long)floor((k - firstDown) / 4.0);
        u.barInPhrase = (uint8_t)(((bar % 4) + 4) % 4 + 1);
    }
    if (s_master.present && s_master.beating) {
        const double since = (esp_timer_get_time() - s_master.beatUs) * (double)s_master.bpm / 60e6;
        const long k = (long)floor(since);
        u.masterPhase = (float)(since - k);
        u.masterInBar = (uint8_t)((s_master.beatInBar - 1 + k) % 4 + 1);
    }
    ui::publish(u);
}

static SemaphoreHandle_t s_audioUp;

// Audio health over one ~2 s period, measured in the audio task and printed
// by reporterTask. realtime = frames sent to the DAC / frames it must have
// played in that wall time; under 100 % means gaps of silence.
struct Report {
    int64_t  t0 = 0, t1 = 0;
    int64_t  blocks = 0, workSumUs = 0, workMaxUs = 0, minSlackUs = INT64_MAX;
    bool     playing = false, keylock = false;
    float    pos = 0, speedPct = 0;
    uint32_t underruns = 0, clicks = 0;
    int      clickWorst = 0;
    bool     synced = false;           // sync on and following a playing master
    double   syncErrAvgMs = 0, syncErrMaxMs = 0;
};
static QueueHandle_t s_report;   // length 1, overwritten

// Top CPU users since the last call, as "name 12% name 8% ...".
static void topTasks(char* out, size_t n, double wallUs)
{
    struct Prev { TaskHandle_t h; uint32_t t; };
    static Prev prev[32];
    static int nPrev;
    static TaskStatus_t st[32];   // static: too big for the stack
    uint32_t total;
    const int count = uxTaskGetSystemState(st, 32, &total);
    struct Use { const char* name; uint32_t dt; BaseType_t core; };
    static Use use[32];
    for (int i = 0; i < count; i++) {
        uint32_t before = 0;
        for (int j = 0; j < nPrev; j++) if (prev[j].h == st[i].xHandle) { before = prev[j].t; break; }
        use[i] = {st[i].pcTaskName, st[i].ulRunTimeCounter - before, st[i].xCoreID};
    }
    for (int i = 0; i < count; i++) prev[i] = {st[i].xHandle, st[i].ulRunTimeCounter};
    nPrev = count;
    for (int i = 0; i < count; i++)          // sort by usage, descending
        for (int j = i + 1; j < count; j++)
            if (use[j].dt > use[i].dt) { Use t = use[i]; use[i] = use[j]; use[j] = t; }
    int len = 0;
    out[0] = 0;
    for (int i = 0; i < count && i < 7 && len < (int)n; i++) {
        const char* core = use[i].core == 0 ? "/0" : use[i].core == 1 ? "/1" : "";
        len += snprintf(out + len, n - len, "%s%s %.0f%%  ", use[i].name, core, 100.0 * use[i].dt / wallUs);
    }
}

static void logVinyl()
{
    const vinyl::State v = vinyl::state();
    if (!v.input) return;
    const usb_audio::InputStats is = usb_audio::inputStats();
    char pos[24] = "-";
    if (v.rawMs >= 0) snprintf(pos, sizeof pos, "%d:%04.1f", (int)(v.rawMs / 60000), fmodf(v.rawMs / 1000.0f, 60));
    ESP_LOGI(TAG, "  vinyl: %s%s, %s  speed %+.3f  record at %s (start %ld)  seeks %lu (%lu re-syncs, last %d ms off)  track - record %+d ms  peak %d  bit lock %s  flags %lu"
             "  (%lu Hz, %lu packets, %lu errors, %lu overflows, %lu restarts)  thru: %lu dry, %lu trims",
             vinyl::mode() == vinyl::Mode::Thru ? "THRU" : !vinyl::enabled() ? "off (V)" : v.armed ? "driving" : "waiting for carrier", v.armed && !v.signal ? ", record stopped" : "",
             v.absolute ? "absolute" : "relative", v.speed, pos, (long)vinyl::startMs(), (unsigned long)s_vinylSeeks, (unsigned long)s_vinylTrims, s_vinylDriftMs, s_vinylErrMs,
             v.peak, v.locked ? "yes" : "no", (unsigned long)v.flags, (unsigned long)v.rate,
             (unsigned long)is.packets, (unsigned long)is.errors, (unsigned long)is.overflows, (unsigned long)is.restarts,
             (unsigned long)s_thruUnderruns, (unsigned long)s_thruTrims);
}

static void reporterTask(void*)
{
    Report r;
    uint32_t idle0 = ulTaskGetIdleRunTimeCounterForCore(0), idle1 = ulTaskGetIdleRunTimeCounterForCore(1);
    int64_t tIdle = esp_timer_get_time();
    for (;;) {
        xQueueReceive(s_report, &r, portMAX_DELAY);
        // CPU load per core = 1 - idle time / wall time since the last report.
        // Core 0 is the shared one (UI, SD, USB, and later the network).
        const uint32_t i0 = ulTaskGetIdleRunTimeCounterForCore(0), i1 = ulTaskGetIdleRunTimeCounterForCore(1);
        const int64_t now = esp_timer_get_time();
        const double wall = (double)(now - tIdle);
        const double load0 = 100.0 * (1.0 - (uint32_t)(i0 - idle0) / wall);
        const double load1 = 100.0 * (1.0 - (uint32_t)(i1 - idle1) / wall);
        idle0 = i0; idle1 = i1; tIdle = now;
        if (!r.playing) { logVinyl(); continue; }
        const double realtime = 100.0 * r.blocks * kBlock / ((r.t1 - r.t0) * (kRate / 1e6));
        ESP_LOGI(TAG, "%s  %d:%04.1f / %d:%04.1f  %+.2f %%%s  buffered %.0f s  underruns %u",
                 s_stream.name(), (int)r.pos / 60, fmodf(r.pos, 60),
                 (int)s_stream.seconds() / 60, fmodf(s_stream.seconds(), 60), r.speedPct,
                 r.keylock ? "  keylock" : "", s_stream.buffered() / 44100.0, (unsigned)r.underruns);
        ESP_LOGI(TAG, "  audio: realtime %.1f %%  block work avg %.2f / max %.2f ms (budget %.2f)  "
                 "min slack %.1f ms  clicks %u (worst %d)",
                 realtime, r.blocks ? r.workSumUs / 1000.0 / r.blocks : 0.0, r.workMaxUs / 1000.0,
                 kBlock * 1000.0 / kRate, r.minSlackUs / 1000.0, (unsigned)r.clicks, r.clickWorst);
        static char top[256];
        topTasks(top, sizeof top, wall);
        if (usb_audio::active())
            ESP_LOGI(TAG, "  usb audio: underruns %u  drift corrections %u",
                     (unsigned)usb_audio::underruns(), (unsigned)usb_audio::corrections());
        logVinyl();
        ESP_LOGI(TAG, "  cpu: core0 %.0f %%  core1 %.0f %%  (%s)", load0, load1, ui::waveStats());
        ESP_LOGI(TAG, "  mem: internal %u KB free (lowest %u KB, largest block %u KB), PSRAM %u KB free",
                 (unsigned)(heap_caps_get_free_size(MALLOC_CAP_INTERNAL) / 1024),
                 (unsigned)(heap_caps_get_minimum_free_size(MALLOC_CAP_INTERNAL) / 1024),
                 (unsigned)(heap_caps_get_largest_free_block(MALLOC_CAP_INTERNAL) / 1024),
                 (unsigned)(heap_caps_get_free_size(MALLOC_CAP_SPIRAM) / 1024));
        ESP_LOGI(TAG, "  top: %s", top);
        static char link[160];
        prolink::summary(link, sizeof link);
        ESP_LOGI(TAG, "  link: %s", link);
        if (r.synced)
            ESP_LOGI(TAG, "  sync: phase error avg %.1f / max %.1f ms (offset %+d ms)",
                     r.syncErrAvgMs, r.syncErrMaxMs, s_syncOffsetMs);
    }
}

static void audioTask(void*)
{
    // Bring up I2S + codec from this task so the I2S interrupt lands on
    // core 1 with the audio, not on core 0 behind the screen's SPI traffic.
    if (!audio_out::begin(kRate, 70)) ESP_LOGE(TAG, "audio init failed");
    xSemaphoreGive(s_audioUp);
    static int16_t buf[kBlock * 2];
    Deck d;
    s_wsola.begin(2);
    followLibrary(d);
    logSelection(d);
    uint32_t underruns = 0, clicksAtStart = 0;
    int64_t tWrote = esp_timer_get_time();
    Report r;
    r.t0 = tWrote;

    for (;;) {
        deck::Event e;
        while (xQueueReceive(s_events, &e, 0) == pdTRUE) apply(d, e);
        followLibrary(d);
        // From the network: a player switched our SYNC, or the mixer's fader start.
        if (const int rs = prolink::takeRemoteSync()) { d.sync = rs == 1; if (d.sync) d.alignNext = d.playing; }
        if (const int fs = prolink::takeFaderStart(); fs && d.loaded && !d.emergency) {
            if (fs == 1 && !d.playing) { d.playing = true; if (d.sync) d.alignNext = true; }
            else if (fs == 2 && d.playing) { d.playing = false; seek(d, d.cue); }   // back to the cue, as a CDJ does
        }
        Pick pick;
        while (xQueueReceive(s_select, &pick, 0) == pdTRUE)    // ignore picks from an older list
            if (pick.gen == d.libGen && d.lib && pick.index >= 0 && pick.index < d.lib->size() && pick.index != d.selected) {
                d.selected = pick.index; logSelection(d);
            }
        bool gone;
        if (xQueueReceive(s_ejected, &gone, 0) == pdTRUE) {
            if (d.loaded && d.playing && !d.previewing) startEmergencyLoop(d);
            else {
                d.loaded = d.playing = d.previewing = false;
                ESP_LOGW(TAG, "track's USB stick removed: unloaded");
            }
        }
        bool ok;
        if (xQueueReceive(s_loadDone, &ok, 0) == pdTRUE) {
            d.loading = false;
            d.loaded = ok;
            d.cue = 0;
            d.pos = 0;
            s_wsola.reset();
            swapGrid();
            d.looping = d.emergency = d.loopInSet = false;
            d.scratching = false;
            d.loopStart = d.loopEnd = 0;
            if (ok) loadCues(d);
            if (ok) ESP_LOGI(TAG, "beat grid: %s", grid().empty() ? "none (SYNC needs a rekordbox track)" : "yes");
            if (!ok) {
                ESP_LOGE(TAG, "load failed");
            } else {
                ESP_LOGI(TAG, "ready: %s (%d:%02d) — PLAY", s_stream.name(),
                         (int)s_stream.seconds() / 60, (int)s_stream.seconds() % 60);
            }
        }

        float needle;
        if (xQueueReceive(s_seekReq, &needle, 0) == pdTRUE && d.loaded && !d.loading && !d.emergency) {
            // Needle search. Synced and playing: land back on the master's beat.
            seek(d, needle * s_stream.frames());
            if (d.sync && d.playing) d.alignNext = true;
        }
        if (s_fakeGridBpm && d.loaded) {
            // Test hook: a constant grid from the track start. The loader
            // only touches the spare grid while loading, and we're loaded.
            const double period = 60000.0 / s_fakeGridBpm;
            auto& g = spareGrid().beats;
            g.clear();
            for (uint32_t i = 0; i * period < s_stream.seconds() * 1000 + period; i++)
                g.push_back({(uint32_t)(i * period + 0.5), (uint16_t)(s_fakeGridBpm * 100), (uint8_t)(i % 4 + 1)});
            swapGrid();
            s_fakeGridBpm = 0;
        }
        if (d.nudge > kNudgeMax) d.nudge = kNudgeMax;
        if (d.nudge < -kNudgeMax) d.nudge = -kNudgeMax;
        prolink::master(s_master);
        float speed = d.tempo + d.nudge;
        // Timecode vinyl: once armed, the record is the tempo (fader, nudge
        // and sync don't apply) and its direction; a stopped record is 0.
        const vinyl::State vs = vinyl::state();
        const bool vinylOn = d.loaded && vinyl::driving(vs);
        static float vinylSpeed;
        static bool wasVinylOn;
        // Switched to INT while the record drove it: carry on at the record's
        // speed (as Serato does) until the fader moves, like SYNC off.
        if (wasVinylOn && !vinylOn && vinyl::mode() == vinyl::Mode::Int && fabsf(vinylSpeed) > 0.05f)
            d.tempo = fabsf(vinylSpeed);
        wasVinylOn = vinylOn;
        if (vinylOn) {
            vinylSpeed += kVinylSmooth * (vs.speed - vinylSpeed);
            speed = vinylSpeed;
            d.nudge = 0;
        } else {
            vinylSpeed = 0;
        }
        s_vinylLive = !vinylOn ? 0 : vs.signal ? 1 : 2;
        s_vinylStill = vinylOn && !vs.signal && !vs.settling;
        if (vinylOn && vs.signal) d.scratching = false;   // the record moves again: it has the deck
        // Absolute: follow the needle. Not in a loop (the loop wins, as in Serato).
        static int64_t vinylOffSinceUs;     // small error first seen (0 = none)
        if (vinylOn && vs.absolute && vs.posMs >= 0 && d.playing && !d.looping && !d.emergency) {
            const double target = (vs.posMs + kVinylLeadMs * vinylSpeed) * (double)s_stream.sampleRate() / 1000.0;
            const double driftMs = fabs(d.pos - target) * 1000.0 / s_stream.sampleRate();
            s_vinylErrMs = (int)((d.pos - target) * 1000.0 / s_stream.sampleRate());
            static int64_t lastSeekUs;
            const int64_t now = esp_timer_get_time();
            bool go = false;
            if (driftMs >= kVinylSeekMs) {
                go = now - lastSeekUs >= kVinylSeekGapMs * 1000;    // needle drop: jump even if it has to wait
                vinylOffSinceUs = 0;
            } else if (driftMs >= kVinylTrimMs) {
                if (!vinylOffSinceUs) vinylOffSinceUs = now;
                int16_t probe[2];
                go = now - vinylOffSinceUs >= kVinylTrimHoldMs * 1000 && s_stream.get((size_t)target, probe, 1);
            } else {
                vinylOffSinceUs = 0;
            }
            if (go && target < s_stream.frames()) {
                s_vinylDriftMs = (int)driftMs;
                seek(d, target);
                lastSeekUs = now;
                vinylOffSinceUs = 0;
                s_vinylSeeks = s_vinylSeeks + 1;
                if (driftMs < kVinylSeekMs) s_vinylTrims = s_vinylTrims + 1;
            }
        } else {
            vinylOffSinceUs = 0;
        }
        if (d.keylock) stepWsolaLag(speed);
        bool synced = false;
        if (!vinylOn && d.sync && d.loaded && !d.reverse && !grid().empty() && s_master.present && s_master.bpm > 0) {
            const float trackBpm = grid().bpmAt(d.pos * 1000.0 / s_stream.sampleRate());
            const float base = syncSpeed(s_master.bpm, trackBpm);
            d.tempo = base;                           // stays here if sync is switched off
            speed = base + d.nudge;
            if (s_master.beating && d.playing && !d.previewing) {
                const int64_t now = esp_timer_get_time();
                int16_t probe[2];
                if (d.alignNext && !s_stream.get((size_t)d.pos, probe, 1)) {
                    // Nothing decoded here yet (just jumped): snap once the
                    // audio is there, or the master moves on while we wait.
                } else if (d.alignNext) {
                    // Jump so our next block lands on the master's phase. At
                    // play start nothing is audible yet, so this is silent.
                    const double audibleUs = now + kOutLatencyFrames * 1e6 / kRate;
                    const double here = d.pos * 1000.0 / s_stream.sampleRate() + s_syncOffsetMs;
                    const double e = phaseError(grid().beatAt(here), s_master, (int64_t)audibleUs);
                    double target = grid().beatAt(here) - e;
                    if (grid().msAt(target) - s_syncOffsetMs < 0) target += 1;   // can't go before 0:00: next beat instead
                    seek(d, (grid().msAt(target) - s_syncOffsetMs) * s_stream.sampleRate() / 1000.0);
                    d.alignNext = false;
                } else {
                    // Then keep it there by bending the tempo a little.
                    const double e = phaseError(grid().beatAt(heardMs(d, speed)), s_master, now);
                    float bend = (float)(-kSyncGain * e);
                    if (bend > kSyncMaxBend) bend = kSyncMaxBend;
                    if (bend < -kSyncMaxBend) bend = -kSyncMaxBend;
                    s_syncBend += kSyncBendSmooth * (bend - s_syncBend);
                    speed = base * (1 + s_syncBend) + d.nudge;
                    const double errMs = fabs(e) * 60000.0 / s_master.bpm;
                    s_syncStats.errSumMs += errMs;
                    if (errMs > s_syncStats.errMaxMs) s_syncStats.errMaxMs = errMs;
                    s_syncStats.n++;
                    synced = true;
                }
            }
        }
        if (!synced) s_syncBend = 0;   // start each sync from no bend
        d.nudge *= kNudgeDecay;

        // Slip: while slipping, the shadow playhead runs on at normal speed;
        // when it ends, playback resumes from it.
        static bool wasSlipping = false;
        const bool slipping = d.slip && d.playing && (((d.looping && !d.emergency)) || d.reverse || d.hotHeld);
        if (wasSlipping && !slipping && d.loaded) seek(d, d.slipPos);
        wasSlipping = slipping;
        const bool thru = vinyl::mode() == vinyl::Mode::Thru && usb_audio::inputActive() && usb_audio::inputRate() == kRate;
        if (!thru) s_thruPrimed = false;
        if (thru) {
            // THRU: the record on the turntable, not the track (the deck holds its place).
            renderThru(buf);
            const float g = d.gain;
            for (int i = 0; i < kBlock * 2; i++) buf[i] = (int16_t)(buf[i] * g);
            s_clicks.reset();
        } else if (d.loaded && d.scratching && s_vinylStill) {
            // Record still, jog moving: scratch, as when paused.
            if (!renderScratch(d, buf)) { d.scratching = false; d.pos = d.scratchTarget; }
            s_stream.setPlayhead((size_t)d.pos);
            const float g = d.gain;
            for (int i = 0; i < kBlock * 2; i++) buf[i] = (int16_t)(buf[i] * g);
            s_clicks.reset();
        } else if (d.playing && d.loaded) {
            // Reverse always plays varispeed: the time-stretcher only runs forwards.
            // Slow or backwards record: varispeed (WSOLA only runs forwards, and smears near 0).
            const bool stretch = d.keylock && !d.reverse && !(vinylOn && speed < kVinylKeylockMin);
            const bool fed = stretch ? renderKeylock(d, speed, buf) : renderPitched(d, speed, buf);
            if (slipping) d.slipPos += kBlock * speed * (double)s_stream.sampleRate() / kRate;
            else d.slipPos = d.pos;
            if (!fed) {
                underruns++;
                if (d.sync) d.alignNext = true;   // we stalled; the master didn't: re-snap
            }
            s_stream.setPlayhead((size_t)d.pos);
            const float g = d.gain;
            for (int i = 0; i < kBlock * 2; i++) buf[i] = (int16_t)(buf[i] * g);
            if (!d.playing) ESP_LOGI(TAG, "end of track");
            if (fed && d.playing) s_clicks.feed(buf, kBlock); else s_clicks.reset();
            if (vinylOn && vs.settling) memset(buf, 0, sizeof buf);   // needle landing: silent until it has a position
        } else if (d.loaded && d.scratching) {
            // Paused, jog moving: play the scratch.
            if (!renderScratch(d, buf)) { d.scratching = false; d.pos = d.scratchTarget; }
            s_stream.setPlayhead((size_t)d.pos);
            const float g = d.gain;
            for (int i = 0; i < kBlock * 2; i++) buf[i] = (int16_t)(buf[i] * g);
            s_clicks.reset();
        } else {
            memset(buf, 0, sizeof buf);
            s_clicks.reset();
        }
        // Measure, but never print from here: a log line over the UART takes
        // longer than an audio block. The reporter task prints instead.
        const int64_t workUs = esp_timer_get_time() - tWrote;
        if (workUs > r.workMaxUs) r.workMaxUs = workUs;
        r.workSumUs += workUs;
        r.blocks++;
        const int64_t tWrite = esp_timer_get_time();
        audio_out::write(buf, kBlock);
        tWrote = esp_timer_get_time();
        // Time spent waiting for DMA room = slack before the DAC would starve.
        if (tWrote - tWrite < r.minSlackUs) r.minSlackUs = tWrote - tWrite;

        publishState(d, speed);  // every block (~170 Hz) so the waveform scrolls smoothly
        if ((r.blocks & 3) == 0) {   // what Link peers see, ~43 Hz (also times our beat packets)
            prolink::Ours o;
            o.loaded = d.loaded;
            o.playing = d.playing;
            o.emergencyLoop = d.emergency && d.playing;
            o.sync = d.sync;
            o.pitch = speed;
            if (d.loaded && !grid().empty()) {
                const double ms = heardMs(d, speed);
                const double b = grid().beatAt(ms);
                o.trackBpm = grid().bpmAt(ms);
                if (b >= 0) { o.beat = (uint32_t)b + 1; o.beatInBar = (uint8_t)grid().inBarAt((long)b); }
                // When our next beat will be heard, for the beat packet.
                if (d.playing && !d.reverse && speed > 0.05f) {
                    const double next = floor(b) + 1;
                    const double inMs = (grid().msAt(next) - ms) / speed;   // track ms -> real ms
                    o.nextBeatUs = esp_timer_get_time() + (int64_t)(inMs * 1000);
                    o.nextBeat = next >= 0 ? (uint32_t)next + 1 : 0;
                    o.nextBeatInBar = (uint8_t)grid().inBarAt((long)next);
                }
            }
            prolink::publish(o);
        }

        if (tWrote - r.t0 >= 2000000) {
            r.t1 = tWrote;
            r.playing = d.playing && d.loaded;
            r.pos = d.loaded ? d.pos / s_stream.sampleRate() : 0;
            r.speedPct = (speed - 1) * 100;
            r.keylock = d.keylock;
            r.synced = synced && s_syncStats.n > 0;
            if (r.synced) { r.syncErrAvgMs = s_syncStats.errSumMs / s_syncStats.n; r.syncErrMaxMs = s_syncStats.errMaxMs; }
            s_syncStats = SyncStats{};
            r.underruns = underruns;
            r.clicks = s_clicks.clicks - clicksAtStart;
            r.clickWorst = s_clicks.worst;
            xQueueOverwrite(s_report, &r);
            clicksAtStart = s_clicks.clicks;
            s_clicks.worst = 0;
            r = Report{};
            r.t0 = tWrote;
        }
    }
}

// Serial console keys, for testing without touching the hardware:
//   1-9 select track   l load   p play/pause   c cue (press+release)
//   k keylock          s sync             [ ] phase trim -/+ 2 ms
//   g give the loaded track a 120 BPM test grid (for SYNC without rekordbox)
//   v switch the phase meter view (beat boxes / alignment ticks)
//   n needle search to the middle of the track
//   ! @ # $ % ^ & * (shift 1-8) hot cue A-H, set / jump   D delete hot cue A
//   o 4-beat loop   x reloop/exit   ( ) loop 1/2, x2   i u loop in/out
//   , . beat jump -/+4   < > call previous/next memory cue   q quantize
//   t tempo range   T tempo reset   m M memory cue add/delete   z slip   r reverse
//   Y become tempo master   J jog calibration (ticks since the last J)   e jog encoder readings   E its magnet status   R 4 s of its raw samples   I raw MIDI log   P panel buttons + pitch pot
//   V timecode vinyl mode ABS / REL / INT   f cycle its decoder flags (backwards record / swapped channels)   L vinyl status   A absolute / relative   Z the needle is at the record's start (track 0:00)
//   w cycle waveform test mode (normal / no flush / off)
static void serialKeysTask(void*)
{
    uart_driver_install(UART_NUM_0, 256, 0, 0, nullptr, 0);
    for (;;) {
        uint8_t ch;
        if (uart_read_bytes(UART_NUM_0, &ch, 1, portMAX_DELAY) != 1) continue;
        deck::Event e;
        e.deck = deck::DeckA;
        e.pressed = true;
        switch (ch) {
        case '1' ... '9': onUiSelect(ch - '1', library::generation()); continue;
        case 'l': e.type = deck::Type::Load; break;
        case 'p': e.type = deck::Type::PlayPause; break;
        case 'k': e.type = deck::Type::KeyLock; break;
        case 's': e.type = deck::Type::Sync; break;
        case 'v': ui::togglePhaseView(); continue;
        case 'n': onUiSeek(0.5f); continue;   // needle search to the middle (test)
        case '!': case '@': case '#': case '$': case '%': case '^': case '&': case '*': {
            static const char kHot[] = "!@#$%^&*";               // shift + 1..8 = hot cue A..H
            e.type = deck::Type::HotCue; e.delta = (int16_t)(strchr(kHot, ch) - kHot + 1);
            onUiEvent(e);                                        // press + release, like a tap
            e.pressed = false; break;
        }
        case 'D': e.type = deck::Type::HotCue; e.delta = 1; e.position = 1; break;   // delete hot cue A
        case 'o': e.type = deck::Type::BeatLoop; e.position = 4; break;
        case 'x': e.type = deck::Type::ReloopExit; break;
        case '(': e.type = deck::Type::LoopHalve; break;
        case ')': e.type = deck::Type::LoopDouble; break;
        case 'i': e.type = deck::Type::LoopIn; break;
        case 'u': e.type = deck::Type::LoopOut; break;
        case ',': e.type = deck::Type::BeatJump; e.delta = -4; break;
        case '.': e.type = deck::Type::BeatJump; e.delta = 4; break;
        case '<': e.type = deck::Type::CueCall; e.delta = -1; break;
        case '>': e.type = deck::Type::CueCall; e.delta = 1; break;
        case 'q': e.type = deck::Type::Quantize; break;
        case 't': e.type = deck::Type::TempoRange; break;
        case 'T': e.type = deck::Type::TempoReset; break;
        case 'm': e.type = deck::Type::MemoryAdd; break;
        case 'M': e.type = deck::Type::MemoryDelete; break;
        case 'z': e.type = deck::Type::Slip; break;
        case 'r': e.type = deck::Type::Reverse; break;
        case 'Y': prolink::requestMaster(); ESP_LOGI(TAG, "requesting tempo master"); continue;
        case 'e': {   // jog encoder: raw reading, learned range, ticks sent
            const as5600::Stats s = as5600::stats();
            ESP_LOGI(TAG, "jog encoder %s (%s): raw %d, range %d..%d, %d ticks, read %d us, %d lost", s.active ? "on" : "OFF", s.i2c ? "I2C" : "analog", s.raw, s.lo, s.hi, s.ticks, s.readUs, s.lost);
            continue;
        }
        case 'P': {   // panel: buttons and pitch pot
            const panel_gpio::Stats s = panel_gpio::stats();
            ESP_LOGI(TAG, "panel: CUE %s (%d presses)  PLAY %s (%d presses)  pitch raw %d filtered %.0f range %d..%d -> %.3f (%d sent)%s",
                     s.cue ? "DOWN" : "up", s.cuePresses, s.play ? "DOWN" : "up", s.playPresses, s.raw, s.filtered, s.lo, s.hi,
                     s.position, s.sent, s.adc ? "" : "  ADC OFF");
            continue;
        }
        case 'E': as5600::probe(audio_out::i2cBus()); continue;   // jog encoder status over I2C (pins 3/5)
        case 'I': s_midiLog = !s_midiLog; ESP_LOGI(TAG, "raw MIDI log %s", s_midiLog ? "on" : "off"); continue;
        case 'R': {   // jog encoder: 4 s of raw samples at 500 Hz, printed as RAW lines
            const int16_t* v;
            const int n = as5600::capture(2000, &v);
            for (int i = 0; i < n; i += 25) {
                printf("RAW");
                for (int j = i; j < i + 25 && j < n; j++) printf(" %d", v[j]);
                printf("\n");
            }
            printf("RAW END %d\n", n);
            continue;
        }
        case 'J': {   // jog calibration: press, turn the jog exactly once, press again
            const int t = s_jogTicks;
            s_jogTicks = 0;
            ESP_LOGI(TAG, "jog: %d ticks since last J; at %d frames/tick that's %.2f s of track", t, kScrubFrames,
                     t * kScrubFrames / (double)kRate);
            continue;
        }
        case 'V': vinyl::cycleMode(); continue;   // ABS -> REL -> INT -> THRU, like tapping the chip
        case 'f': ESP_LOGI(TAG, "timecode flags -> %lu", (unsigned long)vinyl::cycleFlags()); continue;
        case 'L': logVinyl(); continue;
        case 'Z': vinyl::setStartHere(); continue;
        case 'A': vinyl::setAbsolute(!vinyl::absolute()); ESP_LOGI(TAG, "timecode vinyl: %s", vinyl::absolute() ? "absolute (needle drops seek)" : "relative"); continue;
        case 'g': s_fakeGridBpm = 120; ESP_LOGI(TAG, "test grid: 120 BPM from the start"); continue;
        case '[': s_syncOffsetMs -= 2; ESP_LOGI(TAG, "sync offset %+d ms", s_syncOffsetMs); continue;
        case ']': s_syncOffsetMs += 2; ESP_LOGI(TAG, "sync offset %+d ms", s_syncOffsetMs); continue;
        case 'c':
            e.type = deck::Type::Cue; onUiEvent(e);
            e.pressed = false; break;
        case 'w': ESP_LOGI(TAG, "waveform test mode %d", ui::cycleWaveTestMode()); continue;
        default: continue;
        }
        onUiEvent(e);
    }
}

extern "C" void app_main(void)
{
    s_events   = xQueueCreate(64, sizeof(deck::Event));
    s_loadReq  = xQueueCreate(2, sizeof(LoadReq));
    s_loadDone = xQueueCreate(1, sizeof(bool));
    s_ejected  = xQueueCreate(1, sizeof(bool));
    s_ejectDone = xSemaphoreCreateBinary();
    s_select   = xQueueCreate(8, sizeof(Pick));
    s_seekReq  = xQueueCreate(1, sizeof(float));
    s_report   = xQueueCreate(1, sizeof(Report));
    // Screen first, so there's a splash instead of a blank panel while the
    // rest starts (touch comes later: it needs the codec's I2C bus).
    ui::splash();
    ui::splashStatus("SD card");
    const bool sdOk = sd::begin();
    if (!sdOk) ESP_LOGW(TAG, "no SD card");
    s_stream.begin(12 * 1024 * 1024);
    // The SD list now; a stick's tracks join in the background when it mounts
    // (and leave when it's pulled), so boot doesn't wait for USB.
    library::begin(sdOk ? sd::kMount : nullptr);
    ui::splashStatus("USB");
    usb_midi::begin(onMidiPacket);
    usb_stick::begin(onStickMounted, onStickRemoved);
    usb_audio::begin(kRate);
    vinyl::begin();
    usb_midi::powerOn();
    // Network from core 0, so the EMAC interrupt stays off the audio core.
    ui::splashStatus("network");
    net::begin();
    prolink::begin(kLinkPlayer, "FREEDJ-ESP");
    xTaskCreatePinnedToCore(loaderTask, "loader", 32768, nullptr, 4, nullptr, 0);
    ui::splashStatus("audio");
    s_audioUp = xSemaphoreCreateBinary();
    xTaskCreatePinnedToCore(audioTask, "audio", 8192, nullptr, 10, nullptr, 1);
    xSemaphoreTake(s_audioUp, portMAX_DELAY);  // the screen's touch shares the codec's I2C bus
    ui::begin(s_stream, onUiEvent, onUiSelect, onUiSeek, [] { prolink::requestMaster(); });
    ui::onVinylTap([] { vinyl::cycleMode(); });
    as5600::begin(onUiEvent, audio_out::i2cBus());   // jog encoder: I2C on pins 3/5, else analog on pin 7 (core 0)
    panel_gpio::begin(onUiEvent);                    // CUE/PLAY on GPIO 24/25, pitch pot on 22
    xTaskCreatePinnedToCore(reporterTask, "report", 6144, nullptr, 1, nullptr, 0);
    xTaskCreatePinnedToCore(serialKeysTask, "keys", 3072, nullptr, 2, nullptr, 0);
    ESP_LOGI(TAG, "memory free: internal %u KB (largest %u KB), PSRAM %u KB",
             (unsigned)(heap_caps_get_free_size(MALLOC_CAP_INTERNAL) / 1024),
             (unsigned)(heap_caps_get_largest_free_block(MALLOC_CAP_INTERNAL) / 1024),
             (unsigned)(heap_caps_get_free_size(MALLOC_CAP_SPIRAM) / 1024));
    ESP_LOGI(TAG, "browse with the knob, LOAD A to load, PLAY to play");
}
