audiodestrukt/freedj-esp/p4/deck/hardware/cad/machine.py

# SPDX-FileCopyrightText: 2026 Dan Newcome
# SPDX-License-Identifier: CERN-OHL-S-2.0
"""machine.py: the whole freedj-esp, every part placed by its mates, exported as a GLB
for rendering (metres, Y-up) plus a cutaway through the jog axis.

python3 machine.py -> build/freedj_esp.glb, build/freedj_esp_cut.glb
(machine_flat.py builds the flat-top configuration: build/freedj_esp_flat*.glb)
"""
import os, sys
import numpy as np
import trimesh
from trimesh.visual.material import PBRMaterial
from PIL import Image
from build123d import *
import machine_params as M
from machine_params import place
import shell, base, jog, controls, stock, ctrlboard

# name: (rgba, metallic, roughness, emissive rgb or None)
LOOK = {
    "shell":    ((0.075, 0.08, 0.09, 1), 0, 0.55, None),
    "base":     ((0.05, 0.05, 0.055, 1), 0, 0.6, None),
    "feet":     ((0.02, 0.02, 0.02, 1), 0, 0.9, None),
    "platter":  ((0.035, 0.035, 0.04, 1), 0, 0.42, None),
    "touch":    ((0.78, 0.79, 0.81, 1), 1, 0.32, None),
    "cap":      ((0.10, 0.10, 0.11, 1), 0, 0.35, None),
    "marker":   ((1.0, 0.55, 0.12, 1), 0, 0.4, (1.0, 0.45, 0.08)),
    "steel":    ((0.62, 0.63, 0.65, 1), 1, 0.3, None),
    "bearing":  ((0.62, 0.63, 0.65, 1), 1, 0.3, None),
    "magnet":   ((0.35, 0.35, 0.37, 1), 1, 0.4, None),
    "pcb":      ((0.05, 0.22, 0.12, 1), 0, 0.5, None),
    "chip":     ((0.02, 0.02, 0.02, 1), 0, 0.4, None),
    "btn":      ((0.06, 0.06, 0.065, 1), 0, 0.75, None),
    "ring_cue": ((1.0, 0.55, 0.1, 1), 0, 0.3, (1.0, 0.42, 0.05)),
    "ring_play": ((0.2, 0.95, 0.4, 1), 0, 0.3, (0.1, 0.9, 0.3)),
    "icon_cue": ((1.0, 0.6, 0.2, 1), 0, 0.5, None),
    "icon_play": ((0.85, 0.87, 0.88, 1), 0, 0.5, None),
    "knob":     ((0.03, 0.03, 0.035, 1), 0, 0.45, None),
    "white":    ((0.9, 0.9, 0.9, 1), 0, 0.5, None),
    "led_green": ((0.2, 1.0, 0.4, 1), 0, 0.3, (0.1, 1.0, 0.3)),
    "led_blue": ((0.3, 0.6, 1.0, 1), 0, 0.3, (0.2, 0.5, 1.0)),
    "glass":    ((0.02, 0.02, 0.025, 0.12), 0, 0.04, None),
    "lcd":      ((0.02, 0.02, 0.02, 1), 0, 0.5, None),
    "usb_blue": ((0.1, 0.25, 0.8, 1), 0, 0.5, None),
    "pcb_black": ((0.03, 0.03, 0.035, 1), 0, 0.5, None),
    "rca_red":  ((0.75, 0.08, 0.06, 1), 0, 0.5, None),
    "rca_white": ((0.85, 0.85, 0.85, 1), 0, 0.5, None),
    "gold":     ((0.95, 0.75, 0.35, 1), 1, 0.3, None),
}

def scene_parts():
    S = shell.MATES
    out = []
    add = lambda name, solid, look: out.append((name, solid, look))
    add("shell", shell.part(), "shell")
    add("base", place(base.part(), base.MATES["to_shell"], S["base"]), "base")
    for i, f in enumerate(base.feet()):
        add(f"foot{i}", f, "feet")
    # jog stack: each part seated on the axis at its STACK height
    axis = Pos(*M.JOG_C, 0)
    seat = lambda key: axis * Pos(0, 0, jog.STACK[key])
    platter_fn, ring_z = jog.platter, 0.0
    if M.PLATTER == "pioneer":
        import pioneer_platter
        platter_fn, ring_z = pioneer_platter.platter, pioneer_platter.RING_Z
    for key, fn, look in (("platter", platter_fn, "platter"), ("touch_plate", jog.touch_plate, "touch"),
                          ("center_cap", jog.center_cap, "cap"), ("cap_marker", jog.cap_marker, "marker"),
                          ("inertia_ring", jog.inertia_ring, "steel"), ("bearing_top", jog.bearing, "bearing"),
                          ("bearing_bot", jog.bearing, "bearing"),
                          ("magnet", jog.magnet, "magnet"), ("encoder_header", jog.encoder_header, "chip"),
                          ("encoder_pcb", jog.encoder_pcb, "pcb"), ("encoder_chip", jog.encoder_chip, "chip")):
        lift = Pos(0, 0, ring_z if key == "inertia_ring" else 0)   # pioneer: ring up inside the skirt
        add(key, place(fn(), jog.MATES["seat"], lift * seat(key)), look)
    # buttons
    for which in ("play", "cue"):
        at = S[which]; P = lambda s: place(s, controls.MATES["seat"], at)
        if M.PANEL:
            add(f"{which}_panel", P(controls.panel_button()), "btn")
            continue
        plain = M.BUTTONS == "plain"
        if not plain:
            add(f"{which}_ring", P(controls.light_ring()), f"ring_{which}")
        add(f"{which}_cap", P(controls.button_cap(which, plain)), "btn")
        fill = controls.icon_solid(which) & Pos(0, 0, controls.CAP_RISE - 0.5) * Box(20, 20, 0.45, align=(Align.CENTER, Align.CENTER, Align.MIN))
        add(f"{which}_icon", P(fill), f"icon_{which}")
    at = S["slider"]; P = lambda s: place(s, controls.MATES["seat"], at)
    add("slider_knob", P(controls.slider_knob()), "knob")
    add("slider_line", P(controls.knob_line()), "white")
    add("slider_pot", place(controls.pot(M.KNOB_Y - M.SLIDER_C), controls.MATES["seat"], S["pot"]), "steel")
    # control board under CUE / PLAY
    if not M.PANEL:
        add("ctrl_board", ctrlboard.board(), "pcb")
        for n, s_, lk in ctrlboard.parts():
            add(n, s_, lk)
    add("tempo_led", place(controls.led(), controls.MATES["seat"], S["slider_led"]), "led_green")
    if M.USB_STICK:
        add("usb_led", place(controls.led(), controls.MATES["seat"], S["usb_led"]), "led_blue")
    # screen + connectors
    seat_on = lambda s, m: place(s, stock.MATES["seat"], S[m])
    add("gasket", seat_on(stock.gasket(), "screen"), "feet")
    add("glass", seat_on(stock.touch_glass(), "screen"), "glass")
    add("tft", seat_on(stock.tft(), "screen"), "lcd")
    add("lcd_pcb", seat_on(stock.lcd_pcb(), "screen"), "pcb")
    add("lcd_header", seat_on(stock.lcd_header(), "screen"), "chip")
    for i in range(4):
        add(f"screen_screw{i}", seat_on(stock.screw_m3(), f"screen_screw{i}"), "steel")
    if M.USB_STICK:
        add("usb_a", seat_on(stock.usb_a(), "usb_a"), "steel")
        add("usb_a_tongue", seat_on(stock.usb_a_tongue(), "usb_a"), "usb_blue")
    # main board (P4 dev kit or A1S) on the base plate's standoffs
    B = M.board_module()
    add("devboard", B.LOC * B.board(), "pcb_black")
    for n, s in B.ports():
        add(n, B.LOC * s, "steel")
    for n, s in B.parts():
        add(n, B.LOC * s, "chip")
    for side, look in (("rca_l", "rca_white"), ("rca_r", "rca_red"))[:len(M.RCA_X)]:
        add(side, seat_on(stock.rca(), side), "gold")
        add(side + "_ring", seat_on(stock.rca_ring(), side), look)
    return out

def screen_mesh():
    """The LCD image as a textured quad just under the cover glass."""
    aw, ah = M.LCD_ACTIVE
    # just above the TFT, under the touch glass; the active area is off-centre away from the header
    loc = shell.MATES["screen"] * Pos(M.LCD_AA_DX, 0, -M.CTP_T - M.CTP_TAPE + 0.03)
    pts = []
    for x, y in ((-aw / 2, -ah / 2), (aw / 2, -ah / 2), (aw / 2, ah / 2), (-aw / 2, ah / 2)):
        p = (loc * Pos(x, y, 0)).position; pts.append((p.X, p.Y, p.Z))
    img = Image.open("build/screen.png").convert("RGB")
    mat = PBRMaterial(name="screen", baseColorTexture=img, emissiveTexture=img,
                      emissiveFactor=[1.0, 1.0, 1.0], metallicFactor=0, roughnessFactor=0.2)
    uv = np.array([(0, 0), (1, 0), (1, 1), (0, 1)])
    return trimesh.Trimesh(vertices=np.array(pts), faces=[[0, 1, 2], [0, 2, 3]],
                           visual=trimesh.visual.TextureVisuals(uv=uv, material=mat), process=False)

CUT_LOOK = {   # section view: lighter plastics so the cut faces read
    "shell": ((0.42, 0.44, 0.47, 1), 0, 0.6, None), "base": ((0.30, 0.31, 0.33, 1), 0, 0.6, None),
    "platter": ((0.16, 0.16, 0.18, 1), 0, 0.5, None), "steel": ((0.80, 0.81, 0.83, 1), 0.4, 0.4, None), "bearing": ((0.55, 0.65, 0.85, 1), 0.4, 0.4, None),
    "magnet": ((0.75, 0.2, 0.2, 1), 0, 0.4, None), "pcb": ((0.1, 0.5, 0.25, 1), 0, 0.5, None),
}

def export(parts, path, with_screen=True, look=None):
    look = {**LOOK, **(look or {})}
    scene = trimesh.Scene()
    for name, solid, lk in parts:
        f = f"build/viz_{name}.stl"
        export_stl(solid, f, tolerance=0.02, angular_tolerance=0.08)
        m = trimesh.load(f)
        rgba, metal, rough, emis = look[lk]
        kw = dict(name=lk, baseColorFactor=rgba, metallicFactor=metal, roughnessFactor=rough,
                  alphaMode="BLEND" if rgba[3] < 1 else "OPAQUE", doubleSided=True)
        if emis: kw["emissiveFactor"] = list(emis)
        m.visual = trimesh.visual.TextureVisuals(material=PBRMaterial(**kw))
        scene.add_geometry(m, geom_name=name)
    if with_screen:
        scene.add_geometry(screen_mesh(), geom_name="screen")
    scene.apply_transform(trimesh.transformations.scale_matrix(0.001))                  # mm -> m
    scene.apply_transform(trimesh.transformations.rotation_matrix(-np.pi / 2, [1, 0, 0]))  # Z-up -> Y-up
    scene.export(path)

def manifest(parts):
    lo = np.array([1e9] * 3); hi = -lo
    for name, solid, _ in parts:
        bb = solid.bounding_box(); lo = np.minimum(lo, bb.min.to_tuple()); hi = np.maximum(hi, bb.max.to_tuple())
    print(f"{len(parts)} parts, assembly bbox {np.round(hi - lo, 1)} mm (min {np.round(lo, 1)})")

def build():
    os.makedirs("build", exist_ok=True)
    print("config:", M.CONFIG)
    parts = scene_parts()
    manifest(parts)
    export(parts, f"build/{M.NAME}.glb")
    # cutaway: keep x <= jog axis, i.e. a section through the jog module
    keep = Pos(M.JOG_C[0], M.D / 2, 0) * Box(400, 400, 200, align=(Align.MAX, Align.CENTER, Align.CENTER))
    cut = []
    for name, solid, look in parts:
        bb = solid.bounding_box()
        if bb.min.X > M.JOG_C[0]: continue
        if bb.max.X <= M.JOG_C[0]: cut.append((name, solid, look)); continue
        s = solid & keep
        if s.volume > 0.01: cut.append((name, s, look))
    export(cut, f"build/{M.NAME}_cut.glb", with_screen=False, look=CUT_LOOK)
    print(f"wrote build/{M.NAME}.glb, build/{M.NAME}_cut.glb")

if __name__ == "__main__":
    build()
