audiodestrukt/freedj-esp/p4/deck/hardware/cad/ctrlboard.py

# SPDX-FileCopyrightText: 2026 Dan Newcome
# SPDX-License-Identifier: CERN-OHL-S-2.0
"""ctrlboard.py: the control board under CUE / PLAY, as an outline for the PCB layout and
a stand-in for clearance checks.

All SMD parts on the top side (up, toward the top plate), so JLCPCB assembles one side:
two 6 x 6 tact switches right under the caps, four 0805 LEDs under each ring's skirt, a
resistor per LED inside the skirt, and the CH32V003 I2C target with its passives in the
strip right of the buttons. Bottom side: three JST-XH connectors, top entry, so the plugs
go in from below: the pitch pot (3 pins) and the AS5600 (5) on the right edge, the dev
board (5: 3V3, GND, SDA, SCL, INT) on the back edge. The PCB itself is ../ctrl-pcb.
Three M2.5 thread-forming screws from below into bosses that come down from the top.

World frame (deck): the board's top face is at z = CTRL_Z.
python3 ctrlboard.py -> build/ctrl_board_outline.dxf, prints the hole and part positions
"""
import math, os
from build123d import *
import machine_params as M

C = (Align.CENTER, Align.CENTER, Align.MIN)
HOLE_D = 2.7                       # M2.5 clearance
LED = (2.0, 1.25, 0.8)             # 0805, on the ring's centre circle
LED_R = M.SKIRT_D / 2 - M.SKIRT_WALL / 2           # under the ring's skirt wall
LED_ANGLES = (45, 135, 225, 315)
XH_PITCH, XH_W, XH_H = 2.5, 5.75, 7.0
# bottom side: (name, pins, centre x, centre y, along): pot and encoder on the right edge,
# the dev board cable off the back edge
JST = [("j_pot", 3, 40.0, 20.0, "y"), ("j_enc", 5, 40.0, 37.0, "y"), ("j_host", 5, 26.0, 58.5, "x")]
IC = ("u1", 26.0, 28.0, (5.0, 5.0, 1.0))   # placeholder: the I2C chip, bottom side

def outline():
    x0, y0, x1, y1 = M.CTRL_XY
    return Pos((x0 + x1) / 2, (y0 + y1) / 2) * RectangleRounded(x1 - x0, y1 - y0, M.CTRL_CORNER_R)

def board():
    b = Pos(0, 0, M.CTRL_Z - M.CTRL_T) * extrude(outline(), M.CTRL_T)
    return b - [Pos(x, y, M.CTRL_Z - M.CTRL_T - 1) * Cylinder(HOLE_D / 2, M.CTRL_T + 2, align=C) for x, y in M.CTRL_HOLES]

def button_plate():
    """Printable button plate for builds with no control board (release 1): the board's
    outline, thickness and screw holes, with a low locating frame for a through-hole 6 x 6
    tact switch under each cap and holes for its legs (both 6.5 x 4.5 orientations), so
    the switch body sits on the plate exactly where the SMD switch sits on the PCB and the
    wires solder on underneath. Bottom face on z = 0: prints flat, no supports."""
    FRAME_IN, FRAME_W, FRAME_H, LEG_D = 6.4, 0.8, 1.0, 1.3
    b = board()
    for c in (M.PLAY_C, M.CUE_C):
        f = Pos(c[0], c[1], M.CTRL_Z) * (Box(FRAME_IN + 2 * FRAME_W, FRAME_IN + 2 * FRAME_W, FRAME_H, align=C)
                                         - Box(FRAME_IN, FRAME_IN, FRAME_H, align=C))
        b = b + f
        for dx, dy in ((3.25, 2.25), (2.25, 3.25)):
            for sx in (-1, 1):
                for sy in (-1, 1):
                    b = b - Pos(c[0] + sx * dx, c[1] + sy * dy, M.CTRL_Z - M.CTRL_T - 1) * Cylinder(LEG_D / 2, M.CTRL_T + 3, align=C)
    return Pos(0, 0, -(M.CTRL_Z - M.CTRL_T)) * b


def leds(c):
    return [Pos(*c, M.CTRL_Z) * Rot(0, 0, a) * Pos(LED_R, 0, 0) * Rot(0, 0, 90) * Box(*LED, align=C)
            for a in LED_ANGLES]

def tact(c):
    bx, by, bh, top = M.TACT
    body = Pos(*c, M.CTRL_Z) * Box(bx, by, bh, align=C)
    act = Pos(*c, M.CTRL_Z + bh) * Cylinder(1.75, top - bh, align=C)
    return body.fuse(act)

def parts():
    """(name, solid, look) for the render and clearance checks."""
    out = []
    for n, c in (("play", M.PLAY_C), ("cue", M.CUE_C)):
        out.append((f"{n}_switch", tact(c), "chip"))
        for i, l in enumerate(leds(c)):
            out.append((f"{n}_led{i}", l, "white"))
    zb = M.CTRL_Z - M.CTRL_T
    for n, pins, x, y, along in JST:
        L = pins * XH_PITCH + 2.4
        bx, by = (XH_W, L) if along == "y" else (L, XH_W)
        out.append((n, Pos(x, y, zb - XH_H) * Box(bx, by, XH_H, align=C), "white"))
    n, x, y, (a, b, h) = IC
    out.append((n, Pos(x, y, zb - h) * Box(a, b, h, align=C), "chip"))
    return out

if __name__ == "__main__":
    os.makedirs("build", exist_ok=True)
    x0, y0, x1, y1 = M.CTRL_XY
    print(f"config {M.CONFIG}: board {x1 - x0:.1f} x {y1 - y0:.1f} mm, corner r {M.CTRL_CORNER_R}, "
          f"top face at z {M.CTRL_Z:.1f}, {M.CTRL_T} thick")
    print("  coordinates below are relative to the board's lower-left corner (deck x0, y0 =", x0, y0, ")")
    for x, y in M.CTRL_HOLES:
        print(f"  hole M2.5 ({HOLE_D} mm) at {x - x0:.2f}, {y - y0:.2f}")
    for n, c in (("PLAY", M.PLAY_C), ("CUE", M.CUE_C)):
        print(f"  {n} switch centre {c[0] - x0:.2f}, {c[1] - y0:.2f}; 4 LEDs (tangential) on r {LED_R:.2f} at 45/135/225/315 deg;"
              f" ring skirt sits on r {M.SKIRT_D / 2 - M.SKIRT_WALL:.1f}-{M.SKIRT_D / 2:.1f}: keep it clear")
    for n, pins, x, y, along in JST:
        print(f"  {n}: JST-XH {pins}-pin (bottom side), centre {x - x0:.2f}, {y - y0:.2f}, along {along}")
    try:
        exporter = ExportDXF(); exporter.add_shape(Pos(-x0, -y0) * outline())
        for x, y in M.CTRL_HOLES:
            exporter.add_shape(Pos(x - x0, y - y0) * Circle(HOLE_D / 2))
        exporter.write("build/ctrl_board_outline.dxf"); print("wrote build/ctrl_board_outline.dxf")
    except Exception as e:
        print("  (DXF skipped:", e, ")")
