audiodestrukt/freedj-esp/p4/deck/main/as5600.cpp

// SPDX-FileCopyrightText: 2026 Dan Newcome
// SPDX-License-Identifier: GPL-3.0-or-later
// AS5600 jog encoder. See as5600.h.
//
// I2C (preferred): RAW ANGLE, 12 bits over the turn, two reads per sample. Read at
// 500 Hz from this core-0 task; the bus driver serialises it with the codec
// and touch (never touched from the audio task).
// Analog (fallback, when nothing answers at 0x36): the OUT pin is 0..VCC over
// a turn. The P4's ADC wanders ~±40 counts, so that path is smoothed, and its
// range is learned from what's seen (lo/hi), so the first turn calibrates it.
#include "as5600.h"
#include <math.h>
#include "board.h"
#include "esp_adc/adc_oneshot.h"
#include "esp_log.h"
#include "esp_heap_caps.h"
#include "esp_timer.h"
#include "freertos/FreeRTOS.h"
#include "freertos/task.h"

namespace as5600 {
namespace {
const char* TAG = "as5600";

// Ticks per revolution. At kScrubFrames (10 ms of track per tick) 180 ticks
// is 1.8 s of track per turn, about a record at 33 1/3 rpm.
constexpr float kTicksPerRev = 180.0f;
// Sign of the jog: clockwise (spinning right, seen from above) must advance the track.
// With the breakout's DIR tied to GND that's +1. (It read backwards once, only because
// DIR had come off GND and was floating.)
constexpr float kDirection = 1.0f;
constexpr int   kOversample  = 2;      // ADC reads averaged per sample (~140 us each on the P4)
constexpr int   kPeriodMs    = 2;      // 500 Hz: ~6 % of core 0
// Noise handling, tuned offline on captured `R` data (2026-11-02: the sensor
// read ~±100 counts, ~±4 ticks, at rest; the ADC fallback wanders ~±40):
// - Speed-adaptive smoothing (1-euro style) on the unwrapped position, in ticks:
//   kMinCutoff Hz at rest, rising kBeta Hz per tick/s, so 1 rev/s (180 ticks/s)
//   gets ~28 Hz and a turn isn't lagged.
// - Speed comes from a separate 5 Hz low-pass, differenced over 100 ms, so
//   noise can't open the cutoff.
// - Deadband: starting or reversing needs kDeadband ticks; once moving, every
//   tick goes out. Below kStopSpeed it counts as stopped again.
// On the captures: 0 stray ticks in 3 x 4 s at rest; a spin within 1-2 ticks.
// 2026-11-05: with DIR grounded and the speaker away (muted for USB audio), it
// reads 0 counts of spread at rest (2000 samples, AGC 128), so the filter was
// loosened from 1 Hz / 3-tick deadband: first tick after a start 88 -> 38 ms,
// a 4 Hz +-40 degree baby scratch trails by at most 3.1 ticks (was 10.7), in a
// simulation with +-1 count noise. If the ±100 count noise comes back (speaker
// coil playing next to the sensor), these two go back to 1.0 / 3.0.
constexpr float kMinCutoff   = 30.0f;
constexpr float kBeta        = 0.15f;
constexpr float kSpeedCutoff = 5.0f;
constexpr int   kSpeedWin    = 50;     // samples (100 ms)
constexpr float kDeadband    = 1.0f;   // ticks
constexpr float kStopSpeed   = 6.0f;   // ticks/s
constexpr int   kMinSpan     = 1500;   // don't trust the learned range below this

EventFn s_onEvent;
i2c_master_dev_handle_t s_dev;     // set: I2C mode
adc_oneshot_unit_handle_t s_adc;
adc_channel_t s_ch;
volatile int s_raw, s_lo = 4095, s_hi = 0, s_ticks;
volatile bool s_active;
volatile int s_readUs;    // time for one reading
volatile int s_lost;      // samples skipped: no magnet / I2C error
int16_t* s_cap;           // capture(): raw samples, -1 = lost
volatile int s_capN, s_capI;

int readAvg()
{
    int sum = 0, n = 0;
    for (int i = 0; i < kOversample; i++) {
        int v;
        if (adc_oneshot_read(s_adc, s_ch, &v) == ESP_OK) { sum += v; n++; }
    }
    return n ? sum / n : -1;
}

// I2C: the 12-bit raw angle, or -1 if the read fails or the magnet isn't seen.
int readI2c()
{
    static int n;
    uint8_t reg = 0x0B, st = 0x20, b[2];
    if (++n % 50 == 0 && (i2c_master_transmit_receive(s_dev, &reg, 1, &st, 1, 5) != ESP_OK || !(st & 0x20)))
        return -1;                     // status every 100 ms: no magnet, hold still
    reg = 0x0C;
    int v[2];
    for (int& x : v) {                 // two reads, averaged across the 0/4095 seam
        if (i2c_master_transmit_receive(s_dev, &reg, 1, b, 2, 5) != ESP_OK) return -1;
        x = ((b[0] & 0x0F) << 8) | b[1];
    }
    int d = v[1] - v[0];
    if (d > 2048) d -= 4096; else if (d < -2048) d += 4096;
    return (v[0] + d / 2 + 4096) % 4096;
}

float alpha(float cutoffHz)
{
    const float tau = 1.0f / (6.2831853f * cutoffHz), dt = kPeriodMs / 1000.0f;
    return dt / (dt + tau);
}

int sample() { return s_dev ? readI2c() : readAvg(); }

void task(void*)
{
    const bool i2c = s_dev != nullptr;
    const float aS = alpha(kSpeedCutoff);
    int prev;
    while ((prev = sample()) < 0) vTaskDelay(pdMS_TO_TICKS(100));
    float pos = 0;          // ticks, continuous
    float smooth = 0;       // pos, low-passed (speed-adaptive)
    float slow = 0;         // pos, low-passed at kSpeedCutoff, for the speed estimate
    static float hist[kSpeedWin];   // slow, over the last kSpeedWin samples
    int hi = 0;
    int dir = 0;            // direction we're moving in; 0 = stopped (deadband applies)
    bool reseed = false;
    int emitted = 0;        // ticks sent
    for (;;) {
        vTaskDelay(pdMS_TO_TICKS(kPeriodMs));   // always yield: the ADC reads aren't free, and core 0's idle task needs time
        const int64_t t0 = esp_timer_get_time();
        const int raw = sample();
        s_readUs = (int)(esp_timer_get_time() - t0);
        if (s_capI < s_capN) s_cap[s_capI++] = (int16_t)raw;
        if (raw < 0) { s_lost++; reseed = true; continue; }
        if (reseed) { prev = raw; reseed = false; }   // magnet back: no jump from where it was
        s_raw = raw;
        if (raw < s_lo) s_lo = raw;
        if (raw > s_hi) s_hi = raw;
        const int span = i2c ? 4096 : (s_hi - s_lo) > kMinSpan ? (s_hi - s_lo) : 4095;

        int d = raw - prev;
        prev = raw;
        // Crossing the 0/1 turn point jumps the whole range: unwrap it.
        if (d > span / 2) d -= span;
        else if (d < -span / 2) d += span;
        pos += kDirection * d * kTicksPerRev / span;
        slow += aS * (pos - slow);
        const float speed = (slow - hist[hi]) * (1000.0f / (kSpeedWin * kPeriodMs));
        hist[hi] = slow;
        hi = (hi + 1) % kSpeedWin;
        smooth += alpha(kMinCutoff + kBeta * fabsf(speed)) * (pos - smooth);

        int out = 0;
        if (smooth >= emitted + 1 && (dir == 1 || smooth >= emitted + kDeadband)) {
            while (smooth >= emitted + 1) { emitted++; out++; }
            dir = 1;
        } else if (smooth <= emitted - 1 && (dir == -1 || smooth <= emitted - kDeadband)) {
            while (smooth <= emitted - 1) { emitted--; out--; }
            dir = -1;
        }
        if (fabsf(speed) < kStopSpeed) dir = 0;
        if (out) {
            s_ticks += out;
            deck::Event e;
            e.type = deck::Type::Jog;
            e.deck = deck::DeckA;
            e.delta = (int16_t)out;
            s_onEvent(e);
        }
    }
}
} // namespace

void begin(EventFn onEvent, i2c_master_bus_handle_t bus)
{
    s_onEvent = onEvent;
    if (bus) {
        i2c_device_config_t dc = {};
        dc.dev_addr_length = I2C_ADDR_BIT_LEN_7;
        dc.device_address = 0x36;
        dc.scl_speed_hz = 400000;
        uint8_t reg = 0x0B, st;
        if (i2c_master_bus_add_device(bus, &dc, &s_dev) == ESP_OK &&
            i2c_master_transmit_receive(s_dev, &reg, 1, &st, 1, 20) == ESP_OK) {
            s_active = true;
            xTaskCreatePinnedToCore(task, "jog", 3072, nullptr, 5, nullptr, 0);
            ESP_LOGI(TAG, "jog on I2C 0x36, magnet %s, %.0f ticks/rev", (st & 0x20) ? "detected" : "NOT detected", kTicksPerRev);
            return;
        }
        if (s_dev) { i2c_master_bus_rm_device(s_dev); s_dev = nullptr; }
        ESP_LOGI(TAG, "no AS5600 on I2C, trying analog on GPIO %d", board::JOG_ADC);
    }
    adc_unit_t unit;
    if (adc_oneshot_io_to_channel(board::JOG_ADC, &unit, &s_ch) != ESP_OK) {
        ESP_LOGE(TAG, "GPIO %d has no ADC channel", board::JOG_ADC);
        return;
    }
    adc_oneshot_unit_init_cfg_t ucfg = {};
    ucfg.unit_id = unit;
    if (adc_oneshot_new_unit(&ucfg, &s_adc) != ESP_OK) { ESP_LOGE(TAG, "ADC unit init failed"); return; }
    adc_oneshot_chan_cfg_t ccfg = {};
    ccfg.atten = ADC_ATTEN_DB_12;          // full 0..~3.1 V
    ccfg.bitwidth = ADC_BITWIDTH_12;
    if (adc_oneshot_config_channel(s_adc, s_ch, &ccfg) != ESP_OK) { ESP_LOGE(TAG, "ADC channel config failed"); return; }
    s_active = true;
    xTaskCreatePinnedToCore(task, "jog", 3072, nullptr, 5, nullptr, 0);
    ESP_LOGI(TAG, "jog on GPIO %d (ADC%d ch %d), %.0f ticks/rev", board::JOG_ADC, (int)unit + 1, (int)s_ch, kTicksPerRev);
}

void probe(i2c_master_bus_handle_t bus)
{
    i2c_device_config_t dc = {};
    dc.dev_addr_length = I2C_ADDR_BIT_LEN_7;
    dc.device_address = 0x36;
    dc.scl_speed_hz = 100000;
    i2c_master_dev_handle_t dev;
    if (i2c_master_bus_add_device(bus, &dc, &dev) != ESP_OK) { ESP_LOGE(TAG, "probe: add device failed"); return; }
    auto rd = [&](uint8_t reg, uint8_t* out, size_t n) {
        return i2c_master_transmit_receive(dev, &reg, 1, out, n, 50);
    };
    uint8_t st = 0, agc = 0, mag[2] = {}, raw[2] = {}, conf[2] = {}, zmco = 0;
    if (rd(0x0B, &st, 1) != ESP_OK) {
        ESP_LOGE(TAG, "probe: no answer at 0x36 (SDA on pin 3, SCL on pin 5?)");
    } else {
        rd(0x00, &zmco, 1); rd(0x07, conf, 2); rd(0x0C, raw, 2); rd(0x1A, &agc, 1); rd(0x1B, mag, 2);
        char seq[200]; int n = 0;
        for (int i = 0; i < 16; i++) {      // back-to-back raw angle reads (~0.3 ms apart at 100 kHz)
            uint8_t r[2]; rd(0x0C, r, 2);
            n += snprintf(seq + n, sizeof seq - n, " %d", ((r[0] & 0x0F) << 8) | r[1]);
        }
        ESP_LOGI(TAG, "probe: back-to-back raw:%s", seq);
        ESP_LOGI(TAG, "probe: magnet %s%s%s (status 0x%02x), AGC %u (lower = stronger field), magnitude %u, raw angle %u/4095",
                 (st & 0x20) ? "DETECTED" : "NOT detected", (st & 0x10) ? ", TOO WEAK" : "", (st & 0x08) ? ", TOO STRONG" : "",
                 st, agc, ((mag[0] & 0x0F) << 8) | mag[1], ((raw[0] & 0x0F) << 8) | raw[1]);
        const unsigned outs = (conf[1] >> 4) & 3;
        ESP_LOGI(TAG, "probe: CONF 0x%02x%02x, output %s, burned %u times",
                 conf[0], conf[1], outs == 0 ? "analog 0-100%" : outs == 1 ? "analog 10-90%" : "PWM", zmco & 3);
    }
    i2c_master_bus_rm_device(dev);
}

int capture(int n, const int16_t** out)
{
    if (!s_active) return 0;
    if (!s_cap) s_cap = (int16_t*)heap_caps_malloc(kCaptureMax * sizeof(int16_t), MALLOC_CAP_SPIRAM);
    if (!s_cap) return 0;
    if (n > kCaptureMax) n = kCaptureMax;
    s_capI = 0;
    s_capN = n;
    while (s_capI < n) vTaskDelay(pdMS_TO_TICKS(20));
    s_capN = 0;
    *out = s_cap;
    return n;
}

Stats stats() { return {s_raw, s_lo, s_hi, s_ticks, s_readUs, s_lost, s_active, s_dev != nullptr}; }
} // namespace as5600
