audiodestrukt/freedj-esp/p4/deck/main/ui.cpp

// SPDX-FileCopyrightText: 2026 Dan Newcome
// SPDX-License-Identifier: GPL-3.0-or-later
#include "ui.h"

#include <math.h>
#include <atomic>
#include <stdio.h>
#include <string.h>
#include "freertos/FreeRTOS.h"
#include "esp_log.h"
#include "esp_lvgl_port.h"
#include "display.h"
#include "esp_heap_caps.h"
#include "esp_app_desc.h"
#include "library.h"
#include "rekordbox.h"
#include "stream.h"

extern "C" volatile bool lvgl_mem_psram;   // lvgl_mem.c

namespace ui {

static const char* TAG = "ui";

// Layout, 4" (480 x 320):
//   y   0.. 34  track name ................... SYNC  KEY  state chip
//   y  36.. 90  elapsed (big)  -remaining               tempo %
//                                          master BPM | our BPM
//   y  94..116  track overview (rekordbox preview), touch to jump there
//   y 120..264  track list; while playing, the phase meter (120..152) and
//               the scrolling waveform (156..236) instead
//   y 272..318  XDJ touch keys: BROWSE  TAG LIST  INFO  MENU  PERFORM
// 2.8" (320 x 240): the same bands at about the same physical size (the two
// panels are ~5.7 px/mm), so smaller fonts and fewer list rows:
//   y 0..26 header, 28..66 time, 70..86 overview, 90..196 list or meter
//   (90..118) + waveform (122..196), 202..238 keys. The PERFORM pads are 6 x 4
//   and cover 28..198 (time row too), so each stays ~7 mm wide.
#if CONFIG_FREEDJ_SCREEN_28
constexpr int kMargin = 6;
constexpr int kHeadY = 4, kNameW = 0;           // 0: up to the chips
#define FONT_NAME   lv_font_montserrat_16
#define FONT_CHIP   lv_font_montserrat_12
#define FONT_TIME   lv_font_montserrat_32
#define FONT_REMAIN lv_font_montserrat_16
#define FONT_TEMPO  lv_font_montserrat_20
#define FONT_SMALL  lv_font_montserrat_12       // pitch range, BPM line
#define FONT_KEY    lv_font_montserrat_10       // PERFORM, LINK INFO: 63 px at 12, keys are 60
#define FONT_KEYCAP lv_font_montserrat_10
#define FONT_PAD    lv_font_montserrat_12
#define FONT_PAD_NARROW lv_font_montserrat_10   // for a label wider than its pad (RELOOP)
#define FONT_METER  lv_font_montserrat_12
constexpr int kChipPadH = 5, kChipPadV = 2, kChipGap = 4;
// Widths (Montserrat advance tables): time 100-112, remaining <= 48, tempo
// <= 90 (-100.00 %), range <= 39, BPM line <= 140.
constexpr int kTimeY = 28, kRemainX = 124, kRemainY = 38, kTempoY = 28, kRangeDX = -100, kRangeY = 34, kBpmY = 53;
constexpr int kOvY = 70, kOvH = 16;
constexpr int kBandY = 90, kBandH = 106, kRowH = 30;
constexpr int kKeyY = 202, kKeyH = 36, kKeyLabelDY = -6, kKeyCapDY = 6;
constexpr int kPadsY = 28, kPadsH = 170, kPadCols = 6, kPadH = 38;
constexpr int kToastY = 170;
#else
constexpr int kMargin = 10;
constexpr int kHeadY = 8, kNameW = 200;
#define FONT_NAME   lv_font_montserrat_20
#define FONT_CHIP   lv_font_montserrat_16
#define FONT_TIME   lv_font_montserrat_40
#define FONT_REMAIN lv_font_montserrat_24
#define FONT_TEMPO  lv_font_montserrat_24
#define FONT_SMALL  lv_font_montserrat_16
#define FONT_KEY    lv_font_montserrat_16
#define FONT_KEYCAP lv_font_montserrat_12
#define FONT_PAD    lv_font_montserrat_16
#define FONT_PAD_NARROW lv_font_montserrat_12
#define FONT_METER  lv_font_montserrat_16
constexpr int kChipPadH = 8, kChipPadV = 3, kChipGap = 6;
constexpr int kTimeY = 42, kRemainX = 160, kRemainY = 56, kTempoY = 44, kRangeDX = -122, kRangeY = 52, kBpmY = 76;
constexpr int kOvY = 94, kOvH = 22;
constexpr int kBandY = 120, kBandH = 144, kRowH = 36;
constexpr int kKeyY = 272, kKeyH = 46, kKeyLabelDY = -6, kKeyCapDY = 11;
constexpr int kPadsY = 120, kPadsH = 144, kPadCols = 8, kPadH = 44;
constexpr int kToastY = 240;
#endif
// Track overview: the whole track in one strip, from rekordbox's preview
// waveform (PWAV). Touch or drag it to jump (needle search).
constexpr int kOvX = kMargin, kOvW = display::W - 2 * kMargin;

static const lv_color_t kBg     = lv_color_hex(0x0B0D10);
static const lv_color_t kPanel  = lv_color_hex(0x1A1E24);
static const lv_color_t kText   = lv_color_hex(0xE8EAED);
static const lv_color_t kDim    = lv_color_hex(0x8A9099);
static const lv_color_t kGreen  = lv_color_hex(0x2FBF71);
static const lv_color_t kOrange = lv_color_hex(0xF29D38);
static const lv_color_t kBlue   = lv_color_hex(0x3D7EFF);
static const lv_color_t kDimBlue = lv_color_hex(0x243A5C);
static const lv_color_t kGold   = lv_color_hex(0xE8C547);

static portMUX_TYPE s_mux = portMUX_INITIALIZER_UNLOCKED;
static State s_pub;           // written by publish(), read by refresh()
static State s_shown;         // what's on screen now
static bool  s_first = true;

static EventFn  s_onEvent;
static SelectFn s_onSelect;
static SeekFn   s_onSeek;
static Fn       s_onMaster;
static Fn       s_onVinyl;
static lv_obj_t* s_vinyl;          // timecode chip, left of Q; shown only with a USB audio input
static int      s_nameW;           // the name's width without it

static lv_obj_t *s_name, *s_state, *s_time, *s_remain, *s_tempo, *s_key, *s_sync, *s_bpm, *s_quant;
static lv_obj_t *s_barsMem, *s_barsHot;   // XDJ "Bars" countdowns
static lv_obj_t *s_range;                 // pitch range; tap cycles, long press = tempo reset
static lv_obj_t *s_slipPad, *s_revPad;
// PADS panel (the XDJ's PERFORM pads): hot cues, CALL, loop size, beat
// loops, RELOOP/EXIT, beat jump. Covers the waveform while it's open.
static lv_obj_t *s_pads, *s_hotPad[8], *s_reloopPad;
static lv_obj_t *s_ov, *s_list;
// Which screen the middle band shows, as picked with the XDJ-style keys.
// PLAY: waveform (the list pops up for a few seconds while browsing).
// BROWSE: the track list until BROWSE again or a track loads.
// PERFORM: the performance pads.
enum class View { Play, Browse, Perform };
static View s_view = View::Play;
static lv_obj_t *s_browseKey, *s_performKey;
static uint16_t* s_ovBuf;            // kOvW x kOvH RGB565, PSRAM; redrawn when the playhead moves a pixel
static std::vector<lv_obj_t*> s_rows;
static uint32_t s_listGen = 0xFFFFFFFF;   // library generation the rows show
static lv_obj_t* s_toast;                 // "Reading USB…" etc., on the top layer

// Scrolling waveform: playhead fixed in the middle, track moves right to
// left. Shown while playing, unless the list was used in the last few
// seconds. Drawn into a canvas straight from the stream's peak bins.
#if CONFIG_FREEDJ_SCREEN_28
constexpr int kWaveY = 122, kWaveH = 74;
#else
constexpr int kWaveY = 156, kWaveH = 80;
#endif
constexpr int kBinsPerPx = 4;                  // 512 frames/px: ~5.6 s across at 44.1 kHz (3.7 s on the 2.8")
constexpr uint32_t kListLingerMs = 3000;
static const TrackStream* s_stream;
static std::atomic<const rekordbox::Grid*> s_grid{nullptr};
static lv_obj_t* s_wave;
static uint16_t* s_waveBuf;                    // RGB565, W x kWaveH, PSRAM
static uint32_t s_lastListUse;                 // lv_tick of last select/scroll
static bool s_waveShown;
// fps measurement: s_screenFrames counts frames LVGL actually rendered and
// sent to the panel; s_waveFrames counts waveform redraws, which can outrun
// the panel when LVGL merges several into one frame.
static uint32_t s_waveFrames, s_waveT0;
static std::atomic<uint32_t> s_screenFrames;
static volatile int s_waveTest;                 // see cycleWaveTestMode()

int cycleWaveTestMode() { s_waveTest = (s_waveTest + 1) % 3; return s_waveTest; }

void publish(const State& s)
{
    taskENTER_CRITICAL(&s_mux);
    s_pub = s;
    taskEXIT_CRITICAL(&s_mux);
}

static void send(deck::Type t, bool pressed)
{
    deck::Event e;
    e.type = t;
    e.deck = deck::DeckA;
    e.pressed = pressed;
    s_onEvent(e);
}

// Tap a row to select it; tap the selected row again to load it.
static void onRow(lv_event_t* e)
{
    const int i = (int)(intptr_t)lv_event_get_user_data(e);
    if (i == s_shown.selected && s_shown.libGen == s_listGen) send(deck::Type::Load, true);
    else s_onSelect(i, s_listGen);
}

static void onWaveTap(lv_event_t*) { s_lastListUse = lv_tick_get(); }

static void onSyncTap(lv_event_t*) { send(deck::Type::Sync, true); }
static void onQuantTap(lv_event_t*) { send(deck::Type::Quantize, true); }
static void onKeyTap(lv_event_t*) { send(deck::Type::KeyLock, true); }

static void fmtTime(char* out, size_t n, float sec, bool tenths)
{
    if (sec < 0) sec = 0;
    const int m = (int)sec / 60;
    if (tenths) snprintf(out, n, "%d:%04.1f", m, fmodf(sec, 60));
    else        snprintf(out, n, "%d:%02d", m, (int)sec % 60);
}

static lv_obj_t* label(lv_obj_t* parent, const lv_font_t* font, lv_color_t color)
{
    lv_obj_t* l = lv_label_create(parent);
    lv_obj_set_style_text_font(l, font, 0);
    lv_obj_set_style_text_color(l, color, 0);
    lv_label_set_text(l, "");
    return l;
}

// XDJ touch keys (colours from freedj-3000, matched to photos of the unit):
// flat slate faces, white label, a small grey caption under it; the key of
// the screen that's showing lights blue.
static const lv_color_t kKeyFace = lv_color_hex(0x3A4658), kKeyDim = lv_color_hex(0x2A3340),
                        kKeyLit = lv_color_hex(0x2F7FE0), kKeyFaint = lv_color_hex(0x4A525C);
constexpr int kKeyGap = 2;

static lv_obj_t* key(lv_obj_t* parent, const char* text, const char* caption, int i, int n, lv_event_cb_t cb)
{
    const int w = (display::W - 2 * kMargin - (n - 1) * kKeyGap) / n;
    lv_obj_t* b = lv_button_create(parent);
    lv_obj_set_pos(b, kMargin + i * (w + kKeyGap), kKeyY);
    lv_obj_set_size(b, w, kKeyH);
    lv_obj_set_style_radius(b, 2, 0);
    lv_obj_set_style_shadow_width(b, 0, 0);
    lv_obj_set_style_bg_color(b, cb ? kKeyFace : kKeyDim, 0);
    lv_obj_t* l = label(b, &FONT_KEY, cb ? kText : kKeyFaint);
    lv_label_set_text(l, text);
    lv_obj_align(l, LV_ALIGN_CENTER, 0, caption[0] ? kKeyLabelDY : 0);
    if (caption[0]) {
        lv_obj_t* c = label(b, &FONT_KEYCAP, cb ? kDim : kKeyFaint);
        lv_label_set_text(c, caption);
        lv_obj_align(c, LV_ALIGN_CENTER, 0, kKeyCapDY);
    }
    if (cb) lv_obj_add_event_cb(b, cb, LV_EVENT_CLICKED, nullptr);
    else lv_obj_remove_flag(b, LV_OBJ_FLAG_CLICKABLE);    // not built yet: drawn, dimmed
    return b;
}

// A tappable status chip in the header (SYNC, KEY).
static lv_obj_t* chip(lv_obj_t* parent, const char* text, lv_event_cb_t cb)
{
    lv_obj_t* c = label(parent, &FONT_CHIP, kDim);
    lv_label_set_text(c, text);
    lv_obj_set_style_bg_opa(c, LV_OPA_COVER, 0);
    lv_obj_set_style_bg_color(c, kPanel, 0);
    lv_obj_set_style_radius(c, 4, 0);
    lv_obj_set_style_pad_hor(c, kChipPadH, 0);
    lv_obj_set_style_pad_ver(c, kChipPadV, 0);
    lv_obj_set_ext_click_area(c, 8);
    lv_obj_add_flag(c, LV_OBJ_FLAG_CLICKABLE);
    lv_obj_add_event_cb(c, cb, LV_EVENT_PRESSED, nullptr);
    return c;
}

// Needle search: press or drag on the overview. Only sends when the touch
// moves to a new pixel, so a held finger doesn't keep re-seeking.
static void onOverviewTouch(lv_event_t* e)
{
    static int lastX = -1;
    if (!s_shown.loaded) return;
    lv_point_t p;
    lv_indev_get_point(lv_indev_active(), &p);
    int x = p.x - kOvX;
    x = x < 0 ? 0 : x >= kOvW ? kOvW - 1 : x;
    if (lv_event_get_code(e) == LV_EVENT_PRESSED) lastX = -1;   // a new touch always seeks
    if (x == lastX) return;
    lastX = x;
    s_onSeek((float)x / (kOvW - 1));
}

static const rekordbox::Grid* overviewGrid();

// rekordbox colour column (PWV5) -> RGB565; `dim` darkens the played part.
static inline uint16_t pwv5Color(uint16_t v, bool dim)
{
    const int k = dim ? 20 : 36;                     // 7 * 36 = 252
    return lv_color_to_u16(lv_color_make(((v >> 13) & 7) * k, ((v >> 10) & 7) * k, ((v >> 7) & 7) * k));
}
static inline int pwv5Height(uint16_t v) { return (v >> 2) & 31; }

// The tallest colour column between two track frames (0 if none).
static uint16_t pwv5Max(const std::vector<uint16_t>& c, double rate, size_t f0, size_t f1)
{
    size_t i0 = (size_t)(f0 * rekordbox::kColorWavePerSec / rate), i1 = (size_t)(f1 * rekordbox::kColorWavePerSec / rate);
    if (i1 <= i0) i1 = i0 + 1;
    uint16_t best = 0;
    for (size_t i = i0; i < i1 && i < c.size(); i++) if (pwv5Height(c[i]) > pwv5Height(best)) best = c[i];
    return best;
}

// The overview strip. rekordbox's preview columns are stretched to the
// width; the played part is dimmed, as on the XDJ. Without a preview (SD
// tracks) it's a plain bar. White line = playhead, orange = cue.
static void drawOverview(const State& s, int playX, int cueX)
{
    const uint16_t bg = lv_color_to_u16(kBg), base = lv_color_to_u16(kPanel);
    for (int i = 0; i < kOvW * kOvH; i++) s_ovBuf[i] = bg;
    const rekordbox::Grid* g = overviewGrid();
    const bool wave = s.loaded && g && !g->preview.empty();
    const bool colour = s.loaded && g && !g->color.empty() && s.len > 0 && s_stream->sampleRate();
    const double rate = s_stream->sampleRate();
    for (int x = 0; x < kOvW; x++) {
        int h = 2;
        uint16_t c = base;
        if (colour) {                                // colour, from the detail waveform
            const double fpx = s.len * rate / kOvW;
            const uint16_t v = pwv5Max(g->color, rate, (size_t)(x * fpx), (size_t)((x + 1) * fpx));
            h = pwv5Height(v) * kOvH / 31;
            if (h < 1) h = 1;
            c = pwv5Color(v, x < playX);
        } else if (wave) {
            const uint8_t v = g->preview[(size_t)x * g->preview.size() / kOvW];
            h = (v & 31) * kOvH / 31;
            if (h < 1) h = 1;
            // Whiteness 0..7 blends blue toward white, like the XDJ preview.
            const int w = v >> 5;
            const lv_color_t col = lv_color_mix(lv_color_white(), kBlue, (lv_opa_t)(w * 255 / 7 / 2));
            c = lv_color_to_u16(x < playX ? lv_color_mix(col, kBg, 90) : col);
        } else if (s.loaded && x < playX) {
            c = lv_color_to_u16(kDimBlue);
        }
        for (int y = kOvH - h; y < kOvH; y++) s_ovBuf[y * kOvW + x] = c;
    }
    if (s.loaded && s.len > 0) {
        const double fpx = s.len * (s_stream->sampleRate() ? s_stream->sampleRate() : 44100) / (kOvW - 1);
        auto tick = [&](size_t frame, uint16_t c) {
            const int x = (int)(frame / fpx);
            if (x >= 0 && x < kOvW) for (int y = 0; y < 6; y++) s_ovBuf[y * kOvW + x] = c;
        };
        for (int i = 0; i < s.nMem; i++) tick(s.memFrame[i], lv_color_to_u16(lv_color_hex(0xE0453A)));
        for (int i = 0; i < 8; i++) if (s.hotSet & (1 << i)) tick(s.hotFrame[i], lv_color_to_u16(kGreen));
    }
    if (s.loaded) {
        if (cueX >= 0 && cueX < kOvW) for (int y = 0; y < kOvH; y++) s_ovBuf[y * kOvW + cueX] = lv_color_to_u16(kOrange);
        if (playX >= 0 && playX < kOvW) for (int y = 0; y < kOvH; y++) {
            s_ovBuf[y * kOvW + playX] = 0xFFFF;
            if (playX + 1 < kOvW) s_ovBuf[y * kOvW + playX + 1] = 0xFFFF;
        }
    }
    lv_obj_invalidate(s_ov);
}

// ── PADS ─────────────────────────────────────────────────────────────────────
struct PadDef { const char* text; deck::Type type; int16_t delta; float position; };
static const PadDef kPadRows[3][8] = {
    {{"A", deck::Type::HotCue, 1, 0}, {"B", deck::Type::HotCue, 2, 0}, {"C", deck::Type::HotCue, 3, 0},
     {"D", deck::Type::HotCue, 4, 0}, {"E", deck::Type::HotCue, 5, 0}, {"F", deck::Type::HotCue, 6, 0},
     {"G", deck::Type::HotCue, 7, 0}, {"H", deck::Type::HotCue, 8, 0}},
    {{LV_SYMBOL_LEFT, deck::Type::CueCall, -1, 0}, {LV_SYMBOL_RIGHT, deck::Type::CueCall, 1, 0},
     {"MEM", deck::Type::MemoryAdd, 0, 0}, {"DEL", deck::Type::MemoryDelete, 0, 0},
     {"/2", deck::Type::LoopHalve, 0, 0}, {"x2", deck::Type::LoopDouble, 0, 0},
     {"RELOOP", deck::Type::ReloopExit, 0, 0}, {"SLIP", deck::Type::Slip, 0, 0}},
    {{"1", deck::Type::BeatLoop, 0, 1}, {"2", deck::Type::BeatLoop, 0, 2}, {"4", deck::Type::BeatLoop, 0, 4},
     {"8", deck::Type::BeatLoop, 0, 8}, {"16", deck::Type::BeatLoop, 0, 16},
     {LV_SYMBOL_PREV " 4", deck::Type::BeatJump, -4, 0}, {"4 " LV_SYMBOL_NEXT, deck::Type::BeatJump, 4, 0},
     {"REV", deck::Type::Reverse, 0, 0}},
};

static void onPad(lv_event_t* e)
{
    const PadDef* p = (const PadDef*)lv_event_get_user_data(e);
    deck::Event ev;
    ev.type = p->type;
    ev.deck = deck::DeckA;
    ev.pressed = true;
    ev.delta = p->delta;
    ev.position = p->position;
    const lv_event_code_t code = lv_event_get_code(e);
    // Long press on a hot cue pad deletes it; releasing it ends a momentary
    // (slip) hot cue.
    if (code == LV_EVENT_LONG_PRESSED) {
        if (p->type != deck::Type::HotCue) return;
        ev.position = 1;
    } else if (code == LV_EVENT_RELEASED || code == LV_EVENT_PRESS_LOST) {
        if (p->type != deck::Type::HotCue) return;
        ev.pressed = false;
    }
    s_onEvent(ev);
}

static void setView(View v)
{
    s_view = v;
    lv_obj_set_hidden(s_pads, v != View::Perform);
    lv_obj_set_style_bg_color(s_browseKey, v == View::Browse ? kKeyLit : kKeyFace, 0);
    lv_obj_set_style_bg_color(s_performKey, v == View::Perform ? kKeyLit : kKeyFace, 0);
}

static void onBrowseKey(lv_event_t*) { setView(s_view == View::Browse ? View::Play : View::Browse); }
static void onPerformKey(lv_event_t*) { setView(s_view == View::Perform ? View::Play : View::Perform); }

static void buildPads(lv_obj_t* scr)
{
    // 4": three rows of eight over the meter and waveform (y 120..264).
    // 2.8": the same 24 pads in reading order, six to a row (y 28..198).
    s_pads = lv_obj_create(scr);
    lv_obj_remove_style_all(s_pads);
    lv_obj_set_pos(s_pads, 0, kPadsY);
    lv_obj_set_size(s_pads, display::W, kPadsH);
    lv_obj_set_style_bg_opa(s_pads, LV_OPA_COVER, 0);
    lv_obj_set_style_bg_color(s_pads, kBg, 0);
    const int gap = 4, w = (display::W - 2 * kMargin - (kPadCols - 1) * gap) / kPadCols, h = kPadH;
    for (int k = 0; k < 24; k++) {
            const PadDef* p = &kPadRows[k / 8][k % 8];
            const int r = k / kPadCols, c = k % kPadCols;
            lv_obj_t* b = lv_button_create(s_pads);
            lv_obj_set_pos(b, kMargin + c * (w + gap), 2 + r * (h + gap));
            lv_obj_set_size(b, w, h);
            lv_obj_set_style_radius(b, 6, 0);
            lv_obj_set_style_shadow_width(b, 0, 0);
            lv_obj_set_style_pad_all(b, 0, 0);
            lv_obj_set_style_bg_color(b, p->type == deck::Type::HotCue ? kDimBlue : kPanel, 0);
            lv_obj_t* l = label(b, &FONT_PAD, kText);
            lv_label_set_text(l, p->text);
            lv_obj_update_layout(l);                 // a label wider than its pad (RELOOP on the 2.8") steps down
            if (lv_obj_get_width(l) > w - 4) lv_obj_set_style_text_font(l, &FONT_PAD_NARROW, 0);
            lv_obj_center(l);
            lv_obj_add_event_cb(b, onPad, LV_EVENT_PRESSED, (void*)p);
            if (p->type == deck::Type::HotCue) {
                lv_obj_add_event_cb(b, onPad, LV_EVENT_LONG_PRESSED, (void*)p);
                lv_obj_add_event_cb(b, onPad, LV_EVENT_RELEASED, (void*)p);
                lv_obj_add_event_cb(b, onPad, LV_EVENT_PRESS_LOST, (void*)p);
                s_hotPad[p->delta - 1] = b;
            }
            if (p->type == deck::Type::ReloopExit) s_reloopPad = b;
            if (p->type == deck::Type::Slip) s_slipPad = b;
            if (p->type == deck::Type::Reverse) s_revPad = b;
        }
    lv_obj_set_hidden(s_pads, true);
}

static void buildMeter(lv_obj_t* scr);   // phase meter, below

// (Re)build the list rows from the current library snapshot.
static void fillList()
{
    library::Ptr lib = library::get();
    s_listGen = library::generation();
    lv_obj_clean(s_list);
    s_rows.clear();
    // One shared style for every row: per-object style setters allocate a
    // local style each, which adds up over hundreds of tracks.
    static lv_style_t rowStyle, rowChecked;
    static bool styled = false;
    if (!styled) {
        styled = true;
        lv_style_init(&rowStyle);
        lv_style_set_radius(&rowStyle, 0);
        lv_style_set_shadow_width(&rowStyle, 0);
        lv_style_set_pad_left(&rowStyle, kMargin);
        lv_style_set_bg_color(&rowStyle, kBg);
        lv_style_set_text_color(&rowStyle, kText);
        lv_style_set_text_font(&rowStyle, &lv_font_montserrat_16);
        lv_style_set_border_width(&rowStyle, 0);
        lv_style_init(&rowChecked);
        lv_style_set_bg_color(&rowChecked, kBlue);
    }
    lvgl_mem_psram = true;          // rows live until the next list change: PSRAM
    const int n = lib ? lib->size() : 0;
    s_rows.reserve(n);
    for (int i = 0; i < n; i++) {
        lv_obj_t* row = lv_button_create(s_list);
        lv_obj_set_size(row, LV_PCT(100), kRowH);
        lv_obj_add_style(row, &rowStyle, 0);
        lv_obj_add_style(row, &rowChecked, LV_STATE_CHECKED);
        lv_obj_t* text = lv_label_create(row);
        lv_label_set_text(text, lib->name(i));
        lv_label_set_long_mode(text, LV_LABEL_LONG_MODE_DOTS);
        lv_obj_set_size(text, LV_PCT(100), lv_font_get_line_height(&lv_font_montserrat_16));
        lv_obj_align(text, LV_ALIGN_LEFT_MID, 0, 0);
        lv_obj_add_event_cb(row, onRow, LV_EVENT_CLICKED, (void*)(intptr_t)i);
        s_rows.push_back(row);
    }
    if (n == 0) {
        lv_obj_t* l = label(s_list, &lv_font_montserrat_16, kDim);
        lv_label_set_text(l, "  no tracks on the USB stick or SD card");
    }
    lvgl_mem_psram = false;
}

// Bottom-left notice for USB activity: scanning progress, or a short
// message when the list changes.
static void updateToast()
{
    static uint32_t hideAt = 0, lastFound = 0;
    static bool wasScanning = false, hadUsb = false;
    const library::Progress p = library::progress();
    char buf[48];
    // USB tracks come first and have analysis; their absence means the stick is gone.
    library::Ptr lib = library::get();
    const bool usb = lib && !lib->empty() && lib->anlz(0)[0];
    if (hadUsb && !usb && !p.scanning) {
        lv_label_set_text(s_toast, "USB stick removed");
        lv_obj_set_hidden(s_toast, false);
        hideAt = lv_tick_get() + 3000;
    }
    hadUsb = usb;
    if (p.scanning) {
        if (!wasScanning || (uint32_t)p.found != lastFound) {
            snprintf(buf, sizeof buf, "Reading USB stick... %d", p.found);
            lv_label_set_text(s_toast, buf);
            lv_obj_set_hidden(s_toast, false);
            lastFound = p.found;
        }
        hideAt = 0;
    } else if (wasScanning) {
        snprintf(buf, sizeof buf, "USB stick: %d tracks", (int)lastFound);
        lv_label_set_text(s_toast, buf);
        hideAt = lv_tick_get() + 3000;
    }
    if (hideAt && (int32_t)(lv_tick_get() - hideAt) >= 0) { lv_obj_set_hidden(s_toast, true); hideAt = 0; }
    wasScanning = p.scanning;
}

static void build()
{
    lv_obj_t* scr = lv_screen_active();
    lv_obj_set_style_bg_color(scr, kBg, 0);
    lv_obj_set_scrollable(scr, false);

    s_name = label(scr, &FONT_NAME, kText);
    lv_obj_set_pos(s_name, kMargin, kHeadY);
    lv_label_set_long_mode(s_name, LV_LABEL_LONG_MODE_DOTS);

    s_state = label(scr, &FONT_CHIP, kBg);
    lv_obj_set_style_bg_opa(s_state, LV_OPA_COVER, 0);
    lv_obj_set_style_radius(s_state, 4, 0);
    lv_obj_set_style_pad_hor(s_state, kChipPadH, 0);
    lv_obj_set_style_pad_ver(s_state, kChipPadV, 0);
    lv_obj_align(s_state, LV_ALIGN_TOP_RIGHT, -kMargin, kHeadY);
    lv_label_set_text(s_state, "PLAYING");      // widest text: chips sit left of it
    lv_obj_update_layout(s_state);
    s_key = chip(scr, "KEY", onKeyTap);
    lv_obj_align_to(s_key, s_state, LV_ALIGN_OUT_LEFT_MID, -kChipGap, 0);
    s_sync = chip(scr, "SYNC", onSyncTap);
    lv_obj_add_event_cb(s_sync, [](lv_event_t*) { s_onMaster(); }, LV_EVENT_LONG_PRESSED, nullptr);
    lv_obj_align_to(s_sync, s_key, LV_ALIGN_OUT_LEFT_MID, -kChipGap, 0);
    s_quant = chip(scr, "Q", onQuantTap);
    lv_obj_align_to(s_quant, s_sync, LV_ALIGN_OUT_LEFT_MID, -kChipGap, 0);
    s_vinyl = chip(scr, "ABS", [](lv_event_t*) { if (s_onVinyl) s_onVinyl(); });
    lv_obj_align_to(s_vinyl, s_quant, LV_ALIGN_OUT_LEFT_MID, -kChipGap, 0);
    lv_obj_add_flag(s_vinyl, LV_OBJ_FLAG_HIDDEN);
    // DOTS only truncates a label with a fixed height; without one a long
    // name wraps onto the time counter.
    int nameW = kNameW;
    if (!nameW) { lv_obj_update_layout(s_quant); nameW = lv_obj_get_x(s_quant) - kMargin - kChipGap; }
    lv_obj_set_size(s_name, nameW, lv_font_get_line_height(&FONT_NAME));
    s_nameW = nameW;

    s_time = label(scr, &FONT_TIME, kText);
    lv_obj_set_pos(s_time, kMargin, kTimeY);

    s_remain = label(scr, &FONT_REMAIN, kDim);
    lv_obj_set_pos(s_remain, kRemainX, kRemainY);

    s_tempo = label(scr, &FONT_TEMPO, kText);
    lv_obj_align(s_tempo, LV_ALIGN_TOP_RIGHT, -kMargin, kTempoY);

    s_range = label(scr, &FONT_SMALL, kDim);
    lv_obj_align(s_range, LV_ALIGN_TOP_RIGHT, kRangeDX, kRangeY);
    lv_obj_set_ext_click_area(s_range, 10);
    lv_obj_add_flag(s_range, LV_OBJ_FLAG_CLICKABLE);
    lv_obj_add_event_cb(s_range, [](lv_event_t*) { send(deck::Type::TempoRange, true); }, LV_EVENT_SHORT_CLICKED, nullptr);
    lv_obj_add_event_cb(s_range, [](lv_event_t*) { send(deck::Type::TempoReset, true); }, LV_EVENT_LONG_PRESSED, nullptr);

    s_bpm = label(scr, &FONT_SMALL, kDim);
    lv_obj_align(s_bpm, LV_ALIGN_TOP_RIGHT, -kMargin, kBpmY);

    s_ovBuf = (uint16_t*)heap_caps_malloc(kOvW * kOvH * 2, MALLOC_CAP_SPIRAM);
    s_ov = lv_canvas_create(scr);
    lv_canvas_set_buffer(s_ov, s_ovBuf, kOvW, kOvH, LV_COLOR_FORMAT_RGB565);
    lv_obj_set_pos(s_ov, kOvX, kOvY);
    lv_obj_add_flag(s_ov, LV_OBJ_FLAG_CLICKABLE);
    lv_obj_set_ext_click_area(s_ov, 6);
    lv_obj_add_event_cb(s_ov, onOverviewTouch, LV_EVENT_PRESSED, nullptr);
    lv_obj_add_event_cb(s_ov, onOverviewTouch, LV_EVENT_PRESSING, nullptr);

    s_list = lv_obj_create(scr);     // flex column of rows (lv_list is deprecated)
    lv_obj_set_flex_flow(s_list, LV_FLEX_FLOW_COLUMN);
    lv_obj_set_style_radius(s_list, 0, 0);
    lv_obj_set_pos(s_list, 0, kBandY);
    lv_obj_set_size(s_list, display::W, kBandH);
    lv_obj_set_style_bg_color(s_list, kBg, 0);
    lv_obj_set_style_border_width(s_list, 0, 0);
    lv_obj_set_style_pad_all(s_list, 0, 0);
    lv_obj_set_style_pad_row(s_list, 0, 0);
    fillList();

    s_waveBuf = (uint16_t*)heap_caps_malloc(display::W * kWaveH * 2, MALLOC_CAP_SPIRAM);
    s_wave = lv_canvas_create(scr);
    lv_canvas_set_buffer(s_wave, s_waveBuf, display::W, kWaveH, LV_COLOR_FORMAT_RGB565);
    lv_obj_set_pos(s_wave, 0, kWaveY);
    lv_obj_set_clickable(s_wave, true);
    lv_obj_add_event_cb(s_wave, onWaveTap, LV_EVENT_CLICKED, nullptr);
    lv_obj_set_hidden(s_wave, true);

    buildMeter(scr);

    s_toast = label(lv_layer_top(), &lv_font_montserrat_16, kText);
    lv_obj_set_style_bg_opa(s_toast, LV_OPA_COVER, 0);
    lv_obj_set_style_bg_color(s_toast, kPanel, 0);
    lv_obj_set_style_radius(s_toast, 4, 0);
    lv_obj_set_style_pad_hor(s_toast, 8, 0);
    lv_obj_set_style_pad_ver(s_toast, 3, 0);
    lv_obj_set_pos(s_toast, kMargin, kToastY);
    lv_obj_set_hidden(s_toast, true);

    buildPads(scr);
    // The XDJ's touch keys. TAG LIST, INFO and MENU aren't built yet.
    s_browseKey  = key(scr, "BROWSE",   "SEARCH",    0, 5, onBrowseKey);
    key(scr, "TAG LIST", "",          1, 5, nullptr);
    key(scr, "INFO",     "LINK INFO", 2, 5, nullptr);
    key(scr, "MENU",     "UTILITY",   3, 5, nullptr);
    s_performKey = key(scr, "PERFORM",  "",          4, 5, onPerformKey);
    setView(View::Play);
}

// ── Phase meter, XDJ style ───────────────────────────────────────────────────
// Two views, switched by tapping the meter, as on the unit:
//  beat display:   two rows of four boxes. Top: bar within the 4-bar phrase.
//                  Bottom: beat within the bar (orange if we were master).
//  alignment view: "MASTER n", then beat ticks scrolling under a fixed
//                  playhead. Top row the master, bottom row us; the tall tick
//                  is each deck's own downbeat. Phase offset reads as
//                  horizontal displacement.
// The "Bars" readouts on the right count down to the next memory / hot cue
// on an XDJ. There are no cues yet, so they show dashes, like the unit does
// for a track without cues.
#if CONFIG_FREEDJ_SCREEN_28
constexpr int kMeterY = kBandY, kMeterH = 28, kMeterW = 220, kTagW = 70, kTagNumX = 50, kBarsDX = 34;
#else
constexpr int kMeterY = kBandY, kMeterH = 32, kMeterW = 330, kTagW = 92, kTagNumX = 64, kBarsDX = 48;
#endif
constexpr int kTickW = kMeterW - kTagW, kTickH = kMeterH;
static lv_obj_t *s_meter, *s_boxes[8], *s_ticks, *s_tag, *s_tagNum;
static uint16_t* s_tickBuf;           // kTickW x kTickH RGB565, PSRAM (internal RAM is the scarce one)
static bool s_tickView;
static int s_litTop = -1, s_litBot = -1;

static void onMeterTap(lv_event_t*)
{
    s_tickView = !s_tickView;
    for (auto* b : s_boxes) lv_obj_set_hidden(b, s_tickView);
    lv_obj_set_hidden(s_ticks, !s_tickView);
    lv_obj_set_hidden(s_tag, !s_tickView);
    lv_obj_set_hidden(s_tagNum, !s_tickView);
    s_litTop = s_litBot = -1;
}

static void buildMeter(lv_obj_t* scr)
{
    s_meter = lv_obj_create(scr);
    lv_obj_remove_style_all(s_meter);
    lv_obj_set_pos(s_meter, 0, kMeterY);
    lv_obj_set_size(s_meter, display::W, kMeterH);
    lv_obj_add_flag(s_meter, LV_OBJ_FLAG_CLICKABLE);
    lv_obj_add_event_cb(s_meter, onMeterTap, LV_EVENT_CLICKED, nullptr);
    lv_obj_set_hidden(s_meter, true);

    const int gap = 4, cw = (kMeterW - 3 * gap) / 4, rh = (kMeterH - gap) / 2;
    for (int i = 0; i < 8; i++) {
        lv_obj_t* b = lv_obj_create(s_meter);
        lv_obj_remove_style_all(b);
        lv_obj_set_pos(b, kMargin + (i % 4) * (cw + gap), i < 4 ? 0 : rh + gap);
        lv_obj_set_size(b, cw, rh);
        lv_obj_set_style_border_width(b, 1, 0);
        lv_obj_set_style_border_color(b, i < 4 ? kDimBlue : kBlue, 0);
        lv_obj_set_style_radius(b, 1, 0);
        lv_obj_set_style_bg_opa(b, LV_OPA_COVER, 0);
        lv_obj_set_style_bg_color(b, kBg, 0);
        lv_obj_remove_flag(b, LV_OBJ_FLAG_CLICKABLE);
        s_boxes[i] = b;
    }

    const int tagY = (kMeterH - lv_font_get_line_height(&FONT_METER)) / 2;
    s_tag = label(s_meter, &FONT_METER, kText);
    lv_label_set_text(s_tag, "MASTER");
    lv_obj_set_pos(s_tag, kMargin, tagY + 1);
    s_tagNum = label(s_meter, &FONT_METER, kBg);
    lv_obj_set_style_bg_opa(s_tagNum, LV_OPA_COVER, 0);
    lv_obj_set_style_bg_color(s_tagNum, kGold, 0);
    lv_obj_set_style_pad_hor(s_tagNum, 5, 0);
    lv_obj_set_pos(s_tagNum, kMargin + kTagNumX, tagY);
    s_tickBuf = (uint16_t*)heap_caps_malloc(kTickW * kTickH * 2, MALLOC_CAP_SPIRAM);
    s_ticks = lv_canvas_create(s_meter);
    lv_canvas_set_buffer(s_ticks, s_tickBuf, kTickW, kTickH, LV_COLOR_FORMAT_RGB565);
    lv_obj_set_pos(s_ticks, kTagW, 0);
    lv_obj_remove_flag(s_ticks, LV_OBJ_FLAG_CLICKABLE);
    lv_obj_set_hidden(s_ticks, true);
    lv_obj_set_hidden(s_tag, true);
    lv_obj_set_hidden(s_tagNum, true);

    const int bx = kMeterW + 2 * kMargin;
    for (int row = 0; row < 2; row++) {
        const lv_color_t c = row ? kBlue : kOrange;
        lv_obj_t* v = label(s_meter, &FONT_METER, c);
        lv_label_set_text(v, "--.-");
        lv_obj_set_pos(v, bx, row * (rh + gap) - 2);
        (row ? s_barsHot : s_barsMem) = v;
        lv_obj_t* u = label(s_meter, &FONT_METER, c);
        lv_label_set_text(u, "Bars");
        lv_obj_set_pos(u, bx + kBarsDX, row * (rh + gap) - 2);
    }
}

static void drawTicks(const State& s)
{
    const uint16_t bg = lv_color_to_u16(kBg), base = lv_color_to_u16(kPanel), dim = lv_color_to_u16(kDim),
                   white = 0xFFFF;
    for (int i = 0; i < kTickW * kTickH; i++) s_tickBuf[i] = bg;
    const float beatPx = kTickW / 8.0f;          // 8 beats across
    const int cx = kTickW / 2;
    struct Row { int y; float phase; int inBar; uint16_t bar; };
    const Row rows[2] = {
        {kTickH * 30 / 100, s.masterPhase, s.masterInBar, lv_color_to_u16(kOrange)},   // master
        {kTickH * 80 / 100, s.beatPhase,   s.beatInBar,   lv_color_to_u16(kBlue)},     // us
    };
    for (const Row& r : rows) {
        for (int x = 0; x < kTickW; x++) s_tickBuf[r.y * kTickW + x] = base;
        if (r.phase < 0 || r.inBar < 1) continue;
        for (int i = -5; i <= 5; i++) {
            const int x = (int)lroundf(cx + (i - r.phase) * beatPx);
            if (x < 0 || x + 1 >= kTickW) continue;
            const bool down = ((i + r.inBar - 1) % 4 + 4) % 4 == 0;
            const int len = down ? 10 : 5;
            const uint16_t c = down ? r.bar : dim;
            for (int y = r.y - len; y <= r.y; y++) {
                if (y < 0) continue;
                s_tickBuf[y * kTickW + x] = c;
                s_tickBuf[y * kTickW + x + 1] = c;
            }
        }
    }
    for (int y = 0; y < kTickH; y++) s_tickBuf[y * kTickW + cx] = white;
    lv_obj_invalidate(s_ticks);
}

static void updateMeter(const State& s)
{
    if (s_tickView) {
        static uint8_t shownMaster = 0xFF;
        if (s.masterPlayer != shownMaster) {
            shownMaster = s.masterPlayer;
            char b[4];
            snprintf(b, sizeof b, "%s", "-");
            if (shownMaster) snprintf(b, sizeof b, "%u", shownMaster);
            lv_label_set_text(s_tagNum, b);
        }
        drawTicks(s);
        return;
    }
    // Beat display: only touch the boxes when the lit cell changes.
    const int top = s.beatPhase >= 0 ? s.barInPhrase - 1 : -1;
    const int bot = s.beatPhase >= 0 ? s.beatInBar - 1 : -1;
    if (top != s_litTop) {
        if (s_litTop >= 0) lv_obj_set_style_bg_color(s_boxes[s_litTop], kBg, 0);
        if (top >= 0) lv_obj_set_style_bg_color(s_boxes[top], kBlue, 0);
        s_litTop = top;
    }
    if (bot != s_litBot) {
        if (s_litBot >= 0) lv_obj_set_style_bg_color(s_boxes[4 + s_litBot], kBg, 0);
        if (bot >= 0) lv_obj_set_style_bg_color(s_boxes[4 + bot], kBlue, 0);   // orange once we can be master
        s_litBot = bot;
    }
}

static void drawWave(const State& s)
{
    const int W = display::W, mid = kWaveH / 2;
    const uint16_t bg = lv_color_to_u16(kBg), played = lv_color_to_u16(lv_color_hex(0x27466F)),
                   ahead = lv_color_to_u16(lv_color_hex(0x4FA3FF)), axis = lv_color_to_u16(kPanel);
    const size_t framesPerPx = TrackStream::kPeakFrames * kBinsPerPx;
    const long centre = (long)(s.frame / framesPerPx);
    const long bins = (long)s_stream->peakBins();
    static int16_t h[display::W];
    static uint16_t col[display::W];
    // rekordbox's colour waveform when the track has one (frequency-shaded,
    // as on the XDJ), else our own peaks from the decoder in blue.
    const rekordbox::Grid* cg = s_grid.load();
    const bool colour = s.loaded && cg && !cg->color.empty() && s_stream->sampleRate();
    for (int x = 0; x < W; x++) {
        const long px = centre + (x - W / 2);
        if (colour) {
            const uint16_t v = px < 0 ? 0 : pwv5Max(cg->color, s_stream->sampleRate(), px * framesPerPx, (px + 1) * framesPerPx);
            h[x] = (int16_t)(pwv5Height(v) * (mid - 2) / 31);
            col[x] = pwv5Color(v, px < centre);
            continue;
        }
        int p = 0;
        if (px >= 0) for (long b = px * kBinsPerPx, e = b + kBinsPerPx; b < e && b < bins; b++) {
            const int v = s_stream->peak(b);
            if (v > p) p = v;
        }
        h[x] = (int16_t)(p * (mid - 2) / 255);
        col[x] = px < centre ? played : ahead;
    }
    for (int y = 0; y < kWaveH; y++) {
        uint16_t* row = s_waveBuf + y * W;
        const int dy = abs(y - mid);
        for (int x = 0; x < W; x++) row[x] = dy <= h[x] ? col[x] : (dy == 0 ? axis : bg);
    }
    // Beat grid, as on the XDJ: a short tick at the top and bottom edge for
    // every beat, longer and red for each bar's first beat.
    const rekordbox::Grid* g = s_grid.load();
    if (s.loaded && s.hasGrid && g && !g->empty() && s_stream->sampleRate()) {
        const double msPerPx = framesPerPx * 1000.0 / s_stream->sampleRate();
        const double leftMs = (centre - W / 2) * msPerPx, rightMs = (centre + W / 2) * msPerPx;
        const uint16_t beat = lv_color_to_u16(lv_color_hex(0xC8CCD2)), bar = lv_color_to_u16(lv_color_hex(0xE0453A));
        long i = (long)floor(g->beatAt(leftMs > 0 ? leftMs : 0));
        if (i < 0) i = 0;
        for (; i < (long)g->beats.size(); i++) {
            const auto& b = g->beats[i];
            if (b.ms > rightMs) break;
            const long x = (long)(b.ms / msPerPx) - centre + W / 2;
            if (x < 0 || x >= W) continue;
            const bool down = b.inBar == 1;
            const int len = down ? 14 : 7;
            const uint16_t c = down ? bar : beat;
            for (int y = 0; y < len; y++) {
                s_waveBuf[y * W + x] = c;
                s_waveBuf[(kWaveH - 1 - y) * W + x] = c;
            }
        }
    }
    // Active loop: tint its background, as on the XDJ.
    if (s.loaded && s.looping && s.loopEnd > s.loopStart) {
        const uint16_t tint = lv_color_to_u16(lv_color_hex(0x3A2A10));
        long x0 = (long)(s.loopStart / framesPerPx) - centre + W / 2, x1 = (long)(s.loopEnd / framesPerPx) - centre + W / 2;
        if (x0 < 0) x0 = 0;
        if (x1 > W) x1 = W;
        for (int y = 0; y < kWaveH; y++)
            for (long x = x0; x < x1; x++) if (s_waveBuf[y * W + x] == bg) s_waveBuf[y * W + x] = tint;
    }
    // Memory cues red, hot cues green (top half), the cue point orange, then
    // the playhead on top.
    if (s.loaded) {
        auto mark = [&](size_t frame, uint16_t c, int h) {
            const long x = (long)(frame / framesPerPx) - centre + W / 2;
            if (x >= 0 && x < W) for (int y = 0; y < h; y++) s_waveBuf[y * W + x] = c;
        };
        for (int i = 0; i < s.nMem; i++) mark(s.memFrame[i], lv_color_to_u16(lv_color_hex(0xE0453A)), kWaveH);
        for (int i = 0; i < 8; i++) if (s.hotSet & (1 << i)) mark(s.hotFrame[i], lv_color_to_u16(kGreen), kWaveH / 2);
        mark(s.cueFrame, lv_color_to_u16(kOrange), kWaveH);
        // Slip: where the track would be, as a grey line.
        if (s.slip && s.slipFrame != s.frame) mark(s.slipFrame, lv_color_to_u16(kDim), kWaveH);
    }
    for (int y = 0; y < kWaveH; y++) {
        s_waveBuf[y * W + W / 2 - 1] = 0xFFFF;
        s_waveBuf[y * W + W / 2] = 0xFFFF;
    }
    if (s_waveTest == 0) lv_obj_invalidate(s_wave);

    s_waveFrames++;
}

static char s_stats[64] = "list";

const char* waveStats()
{
    if (!s_waveShown) return "list";
    const uint32_t now = lv_tick_get(), dt = now - s_waveT0;
    if (dt >= 1000) {
        snprintf(s_stats, sizeof s_stats, "screen %.1f fps, waveform drawn %.0f/s",
                 s_screenFrames.exchange(0) * 1000.0f / dt, s_waveFrames * 1000.0f / dt);
        s_waveFrames = 0;
        s_waveT0 = now;
    }
    return s_stats;
}

// Runs as fast as LVGL can flush; only redraws while the waveform is up.
static void waveTick(lv_timer_t*)
{
    State s;
    taskENTER_CRITICAL(&s_mux);
    s = s_pub;
    taskEXIT_CRITICAL(&s_mux);
    // Waveform whenever a track is loaded and the view is PLAY; the list
    // pops up for a few seconds while browsing, or stays in BROWSE.
    const bool want = s.loaded && s_view == View::Play && lv_tick_elaps(s_lastListUse) > kListLingerMs;
    if (want != s_waveShown) {
        s_waveShown = want;
        lv_obj_set_hidden(s_wave, !want);
        lv_obj_set_hidden(s_meter, !want);
        lv_obj_set_hidden(s_list, want);
        s_waveFrames = 0;
        s_screenFrames = 0;
        s_waveT0 = lv_tick_get();
    }
    if (want && s_waveTest != 2) { drawWave(s); updateMeter(s); }
}
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
