audiodestrukt/freedj-esp/(commit log)

2026-10-30 deck events + DJ2Go MIDI decoder
    Adds a value-carrying deck event type (names follow freedj-3000's
    ControlEvent) and a transport-agnostic DJ2Go decoder built from
    freedj's verified MIDI map. LOAD-as-shift no longer loads on release
    if another control on that deck was used while it was held.
    Host test: make -C native dj2go_test. Not wired into the player yet.
2026-10-30 p4: USB MIDI host probe for the DJ2Go
    ESP-IDF 5.5 app for the Waveshare ESP32-P4-Module dev kit. Enumerates
    USB devices on the high-speed host, claims the MIDI streaming
    interface, and prints packets decoded by the shared src/dj2go.cpp.
    Build in espressif/idf:release-v5.5 with IDF_COMPONENT_MANAGER=0.
2026-10-30 p4/deck: DJ2Go-controlled test signal on the ES8311 speaker
    First P4 deck app. USB MIDI host (lifted from the probe into
    usb_midi.cpp) feeds the shared DJ2Go decoder; deck A's play, pitch
    fader (±8 %), jog nudge, cue and volume drive a two-tone + 120 BPM
    click generator out through ES8311 → NS4150B (amp enable GPIO53).
    Mounts the microSD slot (4-bit, 40 MHz, LDO ch4) and lists audio files.
    Pins from the espp ESP32-P4-Module-DEV-KIT BSP. Verified on hardware.
2026-10-30 p4/deck: stream WAVs from SD through a PSRAM window, CDJ-style deck
    Browse the SD card with the DJ2Go knob, LOAD A to load, PLAY/CUE/jog/
    pitch fader on deck A, SYNC toggles keylock (shared src/wsola.cpp built
    with WSOLA_NATIVE). Tracks stream through a 12 MB (~71 s) PSRAM window
    refilled by a loader task on core 0, so track length doesn't matter
    and cue/jog inside the window are instant. No screen yet, so the deck
    beeps: tick per browse step, chirp when ready, buzz on load failure.
    Config fixes found on hardware: PSRAM wasn't enabled (hex, 200 MHz,
    copied from the board's Linux build), and the 100 Hz default tick made
    pdMS_TO_TICKS(5) == 0 so the loader spun and tripped the watchdog.
    Verif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
2026-10-30 p4/deck: MP3 playback via minimp3 with sample-accurate seek
    Vendor minimp3 (CC0, lieff/minimp3@ea99364, unmodified) and split
    TrackStream's decoding behind a Source interface with WAV and MP3
    implementations. MP3 opens with MP3D_SEEK_TO_SAMPLE so the frame index
    is built once at load and seeks land on exact samples. The library now
    lists .mp3 files. The loader task stack goes from 4 KB to 32 KB because
    minimp3 decodes with ~16 KB of stack scratch.
2026-10-30 p4/deck: MSP4021 stand-in screen (ST7796S SPI + FT6336U touch)
    4" 480x320 module on the 40-pin header: ST7796S on SPI2 at 20 MHz
    (landscape, BGR), FT6336U touch sharing the codec's I2C bus on GPIO 7/8.
    audio_out now exposes that bus. Boot draws colour bars with a corner
    marker and drops a dot under each touch, as a wiring check.
2026-10-30 p4/deck: LVGL deck screen replaces the beeps
    esp_lvgl_port drives the MSP4021 (LVGL task on core 0, away from audio).
    The screen shows the loaded track, elapsed/remaining, a progress bar with
    the cue point, tempo %, keylock, play state and the track list; tap a row
    to select, tap again (or LOAD) to load, and CUE/PLAY buttons work like the
    DJ2Go's. The audio task publishes a state snapshot; touches come back as
    deck events. Beeps are removed now that there's a screen, and the audio
    loop logs DAC underflows with its slowest block. App partition goes to
    single-app-large: LVGL pushed the binary past 1 MB.
2026-10-30 p4/deck: scrolling waveform, audio on its own core, glitch metrics
    Waveform: the loader records a peak byte per 128 frames as it decodes
    (TrackStream::peak), and the UI draws a playhead-centred scrolling view
    from them into an LVGL canvas while playing (~19 fps over SPI). The list
    comes back on knob/touch use and hides again after 3 s.
    The SPI flushes starved the DAC: playback ran at ~80 % real time. The
    I2S interrupt was on core 0 with the screen; bringing audio_out up from
    the audio task puts it on core 1, and real time is back to 100 %. Also
    -O2 and a 256 KB L2 cache.
    Audio health is measured in the audio task and printed by a low-priority
    reporter (printing from the audio loop took lon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
2026-10-30 p4/deck: keylock resamples to 44.1 kHz before WSOLA
    A 48 kHz track went into the time-stretcher as if it were 44.1 kHz, so
    keylock played it 8.8 % slow and flat. The keylock feed now linearly
    interpolates the file to the output rate first (any rate up to 3x).
2026-10-30 p4/deck: free core 0 for networking; waveform at ~47 fps
    Measured with new per-core and per-task CPU in the status report:
    - LVGL waited for each SPI flush with a busy loop. A flush-wait callback
    now sleeps on a semaphore given by the transfer-done ISR.
    - The touch INT line picked up the SPI clock on jumper wires; every
    false edge woke LVGL through an event group (FreeRTOS timer task,
    ~25 % of a core). INT is unused now; LVGL polls touch anyway.
    - SPI to the screen at 40 MHz.
    Playing with the waveform up: core 0 98 % -> 30 %, core 1 42 % -> 8 %
    (audio only), waveform 39 -> 47 fps, audio at 100 % real time. The
    headroom on core 0 is for Pro DJ Link.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
2026-10-30 docs: P4 deck README (wiring, controls, tasks, audio health, screen notes incl. vsync)
    Also tools/p4_serial.py: the no-reset logger + key injector used for
    hands-off testing, and a pointer from the top-level README.
2026-10-30 wsola: unity-gain overlap-add (keylock was ~6 dB hot and clipping)
    Four Hann windows at 75 % overlap sum to 2.0, and the overlap-add never
    divided that out, so keylock played ~+5.5 dB louder than the source and
    clipped ~13 % of samples on a loud master (790k clipped samples vs 92 in
    the input, house.wav at 1.0x) - heard as 'louder and brighter'. Windows
    are now periodic Hann scaled by 1/2: 0.0 dB and 8 clipped samples at 1.0x.
    Shared with the A1S firmware: its keylock output drops ~6 dB to the
    correct level. Builds; the A1S hardware suite hasn't been re-run.
2026-10-31 deck_event: add KeyLock button type
    Appended at the end so existing values (and the A1S build) don't change.
2026-10-31 p4/deck: Pro DJ Link beat sync using rekordbox beat grids
    - Ethernet (IP101, DHCP with link-local fallback), lwIP on core 0
    - prolink: announce as player 2, send status, track peers and the tempo
    master (packet layouts and status template from freedj-3000)
    - USB stick (usb_host_msc) mounted at /usb; the library lists every
    rekordbox-analysed track from its ANLZ file (PPTH path + PQTZ grid)
    - SYNC: match master tempo (half/double aware), snap to its beat on PLAY,
    hold phase by bending tempo up to 3 %, measured at the speaker
    - UI: SYNC and KEY chips, BPM and master readout; keylock moves off the
    DJ2Go SYNC button
    - LVGL objects for the track list go to PSRAM (lvgl_mem.c); 224 rows had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
2026-10-31 p4/deck: beat grid on the waveform, XDJ phase meter, real screen fps
    - Grid ticks from the rekordbox grid on the waveform (bar starts red, longer)
    - Phase meter above the waveform, tap or serial v to switch views:
    beat display (bar in phrase / beat in bar) and alignment view (master's
    and our beat ticks under one playhead)
    - Beat grid double-buffered now that the screen reads it too
    - Report: screen fps counts frames actually sent (LV_EVENT_RENDER_READY);
    the old figure counted waveform redraws and read high. Adds internal RAM
    free / lowest / largest block
    - Waveform 100 -> 80 px tall to make room for the meter
    Budget (house.mp3, synced, waveform + grid + meter up):
    screen 40-42 f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
2026-10-31 docs: P4 deck changelog with the resource budget at each step
    README gets a single current Resource budget section; old fps figures are
    marked as redraw counts.
2026-10-31 p4/deck: fix reset when loading a track from the USB stick
    usb_host_msc grows its DMA transfer buffer for large reads (~32 KB while
    minimp3 indexes an MP3). From internal RAM that failed once the largest
    free block was 31 KB; the driver had already freed the old transfer and
    freed it again on the error path -> tlsf assert -> reset.
    - CONFIG_USB_HOST_DWC_DMA_CAP_MEMORY_IN_PSRAM: USB transfer buffers in PSRAM
    - phase meter tick canvas (15 KB) moved to PSRAM
    Budget (stick MP3s, synced, waveform+grid+meter, 224-track list):
    screen 37-38 fps; core0 49-50 % (LVGL 34, loader 9, link 3);
    core1 10-11 %; worst block 1.5 ms; internal 65-69 KB free, 43 KB lowest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
2026-10-31 p4/deck: long track names truncate with … instead of wrapping onto the time
    LVGL's DOTS mode only truncates a label with a fixed height; give the name
    and list-row labels a one-line height.
2026-10-31 p4/deck: track overview from rekordbox preview, touch to needle search
    - Overview strip (PWAV, 400 columns) replaces the progress bar: played part
    dimmed, playhead and cue marks; plain strip for tracks without analysis
    - Touch/drag it to jump; synced, the deck re-snaps to the master's beat once
    audio is there, and after any stall
    - Build the MP3 seek index at load even with a VBR tag: minimp3 otherwise
    built it on the first far seek (read 5 MB, 0.53 s gap). Jump gap now 46 ms;
    loads take +0.49 s
    - Pace the loader once 8 s are buffered ahead: a full-speed 70 s refill held
    core 0 at 100 % and the screen at 9 fps for ~4 s after a jump
    Budget (stick MP3, synced, steady state): screen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
2026-10-31 p4/deck: full-speed root port so the DJ2Go works behind the on-board hub
    ESP-IDF's USB host has no transaction translator, so a full-speed device
    behind the board's high-speed CH334F hub is refused ("TT is not
    supported"). Limit the root port to full speed (HCFG.FSLSSupp, re-asserted
    every 100 ms since a port recovery clears it) so the hub itself runs at
    full speed; power the port only after the MIDI and MSC clients register.
    Trick from espp's usb_host (full_speed_only). Needs jumper H3 on DEVICE.
    Verified: DJ2Go and the rekordbox stick work together in two hub ports.
    Cost: stick at 12 Mbit/s: boot scan 6.9 -> 12.4-13.7 s, MP3 load
    0.49 -> 4.94 s (index read); playback unaffected.
    Co-Autho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
2026-10-31 p4/deck: boot without waiting for USB, hot-swap sticks, emergency loop
    - Library is an immutable snapshot (strings in PSRAM) swapped whole when a
    stick comes or goes; the stick is scanned in a background task with a
    progress notice. Boot to screen 3.8 s (was ~19 s with the stick)
    - Load requests carry paths; selection follows its track across list
    changes; UI picks carry the list generation
    - Stick pulled: cancel the scan, drop its tracks, loader closes the file
    before unmount
    - Pulled while playing: emergency loop of 4 grid beats (2 s without a grid)
    from the decoded window, as on a CDJ; Link play state 0x12, E.LOOP on
    screen; loading another track ends it. Sync held at 1.4 ms t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
2026-10-31 p4/deck: hot/memory cues from rekordbox, loops, beat jump, quantize, PADS
    - Read hot cues A-H and memory cues (PCO2 in .EXT, else PCOB in .DAT); load
    to the first memory cue
    - Hot cue set/jump/delete, hot loops; beat loops 1-16, manual in/out (DJ2Go
    LOOP IN/OUT), reloop/exit, halve/double; beat jump moves the loop; CALL
    through memory cues; quantize (default on) with phase-preserving jumps
    - Emergency loop now uses the same loop engine
    - UI: PADS panel, Q chip, live Bars countdowns, loop band and cue marks on the
    waveform and overview; four bottom buttons (CUE PLAY PADS LOAD)
    Sync vs virtual CDJ: 1.4 / 3-4 ms through every loop/jump operation.
    Budget (stick track, synced, loop + hot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
2026-10-31 p4/deck: tempo range/reset, hot cues E-H, memory cues, slip, reverse
    - Pitch ranges 6/10/16/WIDE (default 10, as on the XDJ), tempo reset;
    range label: tap cycles, long press resets
    - PADS: three rows, all eight hot cues; CALL, MEM/DEL, /2 x2, RELOOP, SLIP;
    beat loops, beat jump, REV
    - Memory cues settable on the deck (session only)
    - Slip: shadow playhead through loops, reverse and held hot cues; resume
    from it on release; ghost line on the waveform
    - Reverse via varispeed (WSOLA is forward-only); sync bend paused meanwhile
    Measured synced: slip through a 6 s loop resumed in phase (1.5 / 4.8 ms);
    reverse+slip resumed ahead with one 119 ms reading, then 1.4 ms.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
2026-10-31 p4/deck: beat packets, tempo master and handoff, remote sync, mixer
    - Beat packets on each heard beat (unpitched BPM + pitch, beat-in-bar,
    countdowns); the link task holds the pending beat so none are skipped,
    and restarts the count on any backwards move
    - Tempo master: take it if free, else 0x26 request -> 0x27 yield -> wait for
    Mh = us in the master's status; yield to others and release on their
    claim; sync counter = largest + 1; status sent immediately on change;
    long-press SYNC or serial Y
    - 0x2a remote sync on/off / become master (target byte not trusted)
    - Mixer on-air (0x03) and fader start (0x02), per Deep Symmetry; untested
    - MASTER shown on the BPM line; time turns red on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
2026-10-31 p4/deck: scratch when paused, waveform stays up, feel constants in one place
    - Paused jog plays: the playhead chases the jog target (~23 ms), so the
    audio follows the hand in speed and direction (varispeed, capped at 8x)
    - Waveform shown whenever a track is loaded, not only while playing
    - Feel constants gathered and named (scrub, chase, max speed, nudge per
    tick / max / decay, ranges, sync gain/bend); serial J counts jog ticks
    per revolution for calibration
2026-10-31 docs: roadmap item 6 (undecided): on-deck track analysis
    Why, whether it fits, risks (downbeat accuracy, PSRAM contention, wrong
    grids), three options with a suggested middle one, and how to test it.
2026-10-31 p4/deck: XDJ touch keys, boot splash + dark backlight, colour waveforms, ESP Deck
    - Bottom row: BROWSE / TAG LIST / INFO / MENU / PERFORM keys (XDJ look;
    three dimmed until built); BROWSE holds the list, PERFORM = pads; the
    on-screen CUE/PLAY/LOAD are gone
    - Bootloader hook drives the backlight pin low ~50 ms after power-on; splash
    is the app's first step (1.0 s, was a white screen until 3.7 s); touch
    starts after audio (shared I2C); PSRAM memtest off (-1 s)
    - rekordbox PWV5 colour waveforms on the scrolling view and the overview
    (bit order verified against PWV3: corr 0.86)
    - Named ESP Deck (splash, Pro DJ Link device name)
    Budget: screen 37.8 fps, core0 59 % while refilling, core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
2026-10-31 p4/deck: 8 MB app partition (was 1.5 MB, 94 % full)
    Custom partitions.csv: nvs, phy_init, 8 MB factory app; ~8 MB of the 16 MB
    flash left for OTA slots or a cache later. App 1.4 MB, 83 % free.
2026-10-31 docs: ESP Deck potential hardware targets (P4 boards, S31, S3, classic)
    Requirements from the measured budget, then each candidate against them:
    P4 boards with prices (Olimex ~EUR 16, Waveshare P4-ETH, bare module),
    ESP32-S31 (less internal RAM, octal PSRAM, no DSI), ESP32-S3 (cut-down
    port), classic ESP32 (no). Recommendation: stay on the P4.
2026-10-31 docs: TARGETS: the dev board's Ethernet is 100 Mbit, and that's plenty
2026-10-31 p4/deck: first enclosure design, a 3D-printed mini CDJ around a 3.5" LCD
    160 x 195 mm, 34 mm at the front, 48 mm at the back of the 12 degree
    screen bezel. The top shell fits a 256 mm bed in one piece.
    - 3.5" 480x320 ST7796S over SPI: same resolution and driver as the
    MSP4021, so the UI carries over
    - 100 mm knurled jog on an 8 mm shaft through two 608 bearings; steel
    inertia ring; aluminium top plate as the capacitive touch electrode
    - 6x2.5 mm diametric magnet over an MT6701, A/B into the P4 pulse counter
    - CUE/PLAY with light rings, 45 mm pitch slider with tempo-zero LED,
    USB-A slot beside the screen, RJ45 + RCA + USB-C at the back
    Parametric build123d (hardware/cad), parts placed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
2026-10-31 p4/deck: flat-top enclosure variant for easy printing
    Second configuration of the same model: ESP_DECK_CONFIG=flat sets TILT
    to 0, so the screen lies flat in the top and the whole shell is 34 mm
    tall. Printed upside down it sits flat on the bed with no supports; the
    angled design's bezel slope would need them.
    The angled design stays the default. All other parts are shared;
    machine_flat.py builds the flat assembly (build/esp_deck_flat*.glb),
    and `ESP_DECK_CONFIG=flat python3 shell.py` gives build/shell_flat.stl
    (watertight, one body, 160 x 195 x 34 mm). Render logged as 0004.
2026-10-31 p4/deck: enclosure redesigned around the 4" MSP4021
    Design around the panel actually on the bench instead of a 3.5" one.
    - 160 x 205 mm (was 195): the 4" glass stack is 61 mm deep
    - MSP4021 from vendor data (lcdwiki / Elecrow): 60.88 x 94.57 mm glass
    (2.5 TFT + 1.35 touch), 55.68 x 83.52 active, 108.04 x 61.74 board,
    14.8 mm deep with header. Not measured yet; all in machine_params.py
    - Glass flush in an opening through the top. The board's ends rest on
    the top's underside on 0.35 mm tape, held by two printed clamps on
    M2.5 self-tappers into bosses just past the ends
    - Screen centred at x = 84; USB-A slot moved up the bezel, clear of the
    left clamp boss
    Both configs rebuilt: shel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
2026-10-31 p4/deck: compact the enclosure, 205 -> 185 mm deep
    The gap between the jog well and the screen glass was ~20 mm of dead
    space. Now:
    - JOG_SCREEN_GAP = 8 mm from well edge to glass edge
    - jog, CUE/PLAY and slider 5 mm forward (CUE stays ~4 mm off the well)
    - brand engraving moved from the strip under the bezel to the bezel,
    below the USB-A slot
    - D is derived from the layout (well + gap + glass + 4/5 mm margins)
    instead of hand-set, so screen or jog changes resize the deck
    Angled 160 x 184.7 x 47.9 mm, flat 160 x 186.3 x 34 mm; both shells
    watertight, one body; zero clashes between shell and screen, clamps,
    USB-A, jog parts. Renders 0009-0012.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
2026-10-31 p4/deck: screen mounts on its 4 holes; model follows the MSP4031
    The screen is a Hosyond 4" 320x480 capacitive (ST7796S + FT6336U), i.e.
    the LCDwiki/QDtech MSP4031. Dimensions from its drawing:
    108.00 x 60.88 board, 60.88 x 94.57 glass centred on it, stack above the
    board 4.85 (1.35 CTP + 0.5 tape + 2.5 TFT + 0.5 tape), 14.8 overall,
    active area 2.88 mm off-centre away from the header.
    - Four bosses on the module's mounting holes (102.00 x 54.88, 3.2 mm):
    6 mm OD, 1.35 mm below the top's underside to stop on the board with
    the glass flush; 2.5 mm pilots 3.8 deep for M3 x 5 thread-formers,
    1.05 mm skin left under the face
    - The two printed clamps and their bosses are gone
    - Screws mode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
2026-10-31 docs: hardware README: name the Hosyond/MSP4031 screen, drop the last clamp mention
2026-10-31 p4/deck: recess the screen behind a window over the visible area
    The glass no longer sits flush in a full-size opening. The top now has
    a window cut to just the active area (+0.5 mm all round), 2.88 mm
    off-centre away from the header end as the panel's active area is.
    It's straight for 1 mm, then a 45 degree chamfer so a finger reaches
    the edges of the touch area.
    - Glass sits behind the top on a 0.5 mm foam gasket (GLASS_Z)
    - The 4 screen bosses come down to the board: 6.8 mm OD, 0.3 mm clear
    of the glass edge; M3 pilots 2.5 mm x 6 deep, 3.3 mm under the face
    - Clash check: only the gasket touching the top's underside (a 0.014 mm
    rounding sliver) and the screws' thread bite; nothing el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
2026-10-31 Rename the project to freedj-esp
    The repo and the P4 deck ("ESP Deck") are now freedj-esp, after
    freedj-3000.
    - P4: splash and Pro DJ Link device name FREEDJ-ESP (10 of 20 chars)
    - Enclosure CAD: FREEDJ-ESP engraving; freedj_esp* file stems,
    FREEDJ_CONFIG instead of ESP_DECK_CONFIG; render log moved to
    renders/freedj_esp (render 0019)
    - Docs: README titles, TARGETS, hardware README, partitions.csv header;
    root README introduces both firmwares under the new name
    - A1S OLED boot text, the SDL host window title and the sim metadata
    say freedj-esp. Internal names (mediaplayer binary, MEDIAPLAYER_*
    build flags) are unchanged
    Name strings only, so the resource budget is unchanged. P4 b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
2026-10-31 p4/deck: mount the Waveshare dev board in the enclosure
    The ESP32-P4-Module-DEV-KIT has the Raspberry Pi B+ footprint (85 x 56,
    M2.5 holes 58 x 49 at 3.5 mm from the edges, per Waveshare's drawing).
    - devboard.py: stand-in (board, 2 x dual USB-A, RJ45, 2 x USB-C, 40-pin
    header, module) and its placement: back-right, port end to the rear,
    USB-C edge to the right; 3 mm off the right wall and 1 mm off the back
    so its corner clears the shell's round inner corner
    - base.py: four 3 mm standoffs (7 mm OD) for M2.5 heat-set inserts;
    vents moved left of them
    - shell.py: rear cut-outs for Ethernet and both USB-A stacks; right-wall
    cut-outs for the USB-C plugs' overmoulds (12.5 x 7); the old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
2026-10-31 p4/deck: centre the screen window; base screws in all four corners
    Screen: the window was ~7 mm right of centre (module moved 4 mm for the
    USB slot, plus the panel's 2.88 mm active-area offset). WINDOW_X = W/2
    and the module sits 2.88 mm left of it, so the visible area is centred
    on the deck and over the jog. USB-A slot moved to x = 14.5; the brand
    is centred in the strip left of the window, at 3.5 mm.
    Base fixing: four short corner bosses replace the full-height posts.
    9 mm OD, 10 mm tall, fused into the walls, with a 45 degree cone above
    so they print unsupported upside down; M3 x 5.7 heat-set inserts. This
    fixes the old front-left post's insert bore breaking into the PLAY
    button hole, an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
2026-10-31 p4/deck: base.py writes base_flat.stl for the flat config
    base.py always exported build/base.stl, so with FREEDJ_CONFIG=flat it
    overwrote the angled plate, and the angled plate (179.1 mm deep) was
    the one handed out with the flat shell. The flat shell is 186.3 mm deep
    and needs the 180.7 mm plate.
2026-10-31 p4/deck: printed jog shaft, AS5600 encoder on the base, M3 inserts
    - Shaft printed with the platter (7.95 mm, snug in the 608s) instead of
    a steel shaft; fit_gauge.stl (7.85-8.00) to tune it per printer.
    - Stack derived from the shell as printed (lower bearing at z 10):
    DIN 6799-6 e-clip groove 9.20-9.95, 0.4 mm cap, 1.6 mm magnet glued
    flush in a tip pocket, tip at z 7.20. Shaft below the platter:
    29.3 mm flat, 25.3 mm angled (platter_flat.stl per config).
    - AS5600 breakout (23 x 23 mm, unmeasured) flat on the base plate, two
    small M3 inserts through the 3 mm plate, header-tail slot; right-angle
    header pointing back. Air gap 1.1 mm (0.7-1.5 for a +-0.4 mm magnet).
    - Dev board st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
2026-10-31 p4/deck: engrave "FREEDJ" on the case
    The hardware brand is freedj; freedj-esp stays the firmware's name.
    Shell STLs rebuilt (flat 160 x 186.3 x 38, angled 160 x 184.7 x 47.9),
    both watertight, one body.
2026-10-31 docs: hardware README: 3.5" MSP3520 screen option
    Numbers from LCDwiki's MSP3520 drawing for the parametric freedj-1000:
    56.34 x 98.00 board, holes 49.50 x 92.00, active area 48.96 x 73.44
    (2.33 off-centre away from the header), 4.20 above the board, 14.18 deep.
    Notes the ILI9488's 18-bit-only SPI mode (~2/3 the frame rate) and the
    XPT2046 resistive touch.
2026-10-31 p4/deck: AS5600 on 2.3 mm bosses; drop the e-clip
    To fit the printed shell (lower bearing at z 10): the shaft now ends just
    under the lower bearing (tip z 9.5, 0.5 lead-in), magnet flush in the
    tip, 1.1 mm gap, board 5.3-6.9 on two 2.3 mm bosses (7.5 OD, small M3
    inserts, 0.6 floor). Dupont plug clears the bearing boss by 0.6 mm;
    header-tail slot kept. Shaft below the platter 27.0 flat / 23.0 angled.
    No platter retention for now. Clash check clean in both configs;
    render 0025.
2026-10-31 p4/deck: AS5600 on four bosses, from the measured board
    Board 23.8 mm (15/16") square, 4 corner holes 15.875 mm (5/8") apart,
    chip centred; pin columns either side of the chip (3 left, 4 right)
    from the listing photo. Four 2.3 mm bosses (7 OD, small M3 inserts);
    1.5 mm tail pockets under both columns, the right one notching the
    top-right boss (0.55 mm wall to the insert bore). Clash check clean in
    both configs; renders 0026, 0027.
2026-11-01 p4/deck: USB audio probe for the Behringer UCA202
    When a USB audio (UAC1) device enumerates, log its audio interfaces,
    terminals, formats, rates and endpoints, then play a 2 s 440 Hz tone
    at -12 dBFS through its first 16-bit stereo isochronous OUT that
    takes 48 kHz: 192-byte packets, 8 per transfer, 3 in flight (~24 ms),
    with packet and transfer errors logged at the end.
    The goal is to confirm isochronous transfers work through the
    full-speed hub before building an audio_out backend on them. It runs
    as its own USB host client next to MIDI and the stick; MIDI-only
    devices (the DJ2Go) are skipped. Builds clean on IDF 5.5. App
    0x162900 bytes, 83% of the partition free. Not run on hardware yet.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
2026-11-01 p4/deck: 4 KB USB control buffer so the UCA202 enumerates
    The UCA202 (PCM2902, 08BB:2902) failed to enumerate with "Configuration
    descriptor larger than control transfer max length". The hub then
    disabled its port, so the power LED stayed off. It lists ~40 formats,
    which puts the config descriptor over 1 KB: 256 and 1024 both failed,
    4096 works. The buffer is per device, in PSRAM.
    Probe result: playback on interface 1 alt 1 (2 ch, 16-bit,
    32/44.1/48 kHz, iso OUT 0x02, adaptive, 192 B). A 2 s 48 kHz tone:
    1000 packets, 0 packet errors, 0 transfer errors. Endpoint SET_CUR
    sample rate stalls; the tone still played.
2026-11-01 p4/deck: play music out of the UCA202 over USB
    usb_audio_probe becomes usb_audio. When a UAC1 device with a 16-bit
    stereo iso output at 44.1 kHz enumerates, the deck streams to it in
    stereo, and the speaker plays silence until the device is unplugged.
    audio_out::write() feeds a 4096-frame ring. USB sends one packet per
    1 ms frame (44/45 frames), 4 per transfer, 3 transfers in flight. The
    ring is held near 1024 frames (~23 ms); past +-512 frames it drops or
    repeats one frame per packet to follow I2S/USB clock drift. The I2S DMA
    still paces the audio loop.
    The speaker mute is silence to I2S, not a codec mute. A codec mute over
    I2C from the audio task (core 1) collided with LVGL's touch read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
2026-11-01 p4/deck: PTA4543 pitch pot mount, control board under CUE/PLAY
    Pitch pot: Bourns PTA4543-2015DPB103 (45 mm, no detent, 15 mm metal
    lever, 10k lin). The frame hangs on two 3 mm pads under the top with
    two M2x8 countersunk screws into its tapped holes, 56 mm apart; flush,
    because a pan head would catch the knob at the travel ends. The slot
    goes from 74 to 49.6 mm (travel + lever + 0.6), leaving 2 mm of plastic
    to each screw hole. The knob gets a 1.4x4.3x7.2 lever socket, grows to
    10 mm tall and rides 1 mm above the top. Ticks now span the 45 mm
    travel.
    Control board (ctrlboard.py): 40.5 x 56.5 mm under CUE/PLAY on three
    M2.5 bosses from the top. Top face at z 20.7 angled / 24.7 flat, where
    a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
2026-11-01 p4/deck: export the PLAY cap as play_cap.stl, add light_ring.stl
    The PLAY cap was written as button_cap.stl, easy to miss next to
    cue_cap.stl, and the light ring had no STL. Both caps, the ring
    (print 2, translucent) and the knob are watertight single bodies.
2026-11-01 p4/deck: buttons held in by the control board; 60 mm pitch fader
    Buttons: cap and light ring go in from below and the control board
    holds them. The ring gets a 23.6 mm skirt (1 mm wall) down to the board,
    which clamps it; it also carries the LED light up to the ring through
    notches over the LEDs. The cap gets a 21 mm flange under the ring tube
    (0.2 mm gap at rest, 45-degree chamfer so it prints upside down) and a
    4 mm nub onto the 12x12x7.3 tact. The shell's guide sleeves go; plain
    22.4 mm holes. Skirts are 0.4 mm apart (buttons 24 mm apart).
    Control board 42 x 58 mm (was 40.5 x 56.5) so the skirts sit fully on
    it; LEDs at r 11.3, tangential, under the skirt wall.
    Pitch: PTA6043-2015DPB103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
2026-11-01 Add licences: GPL-3.0-or-later for software, CERN-OHL-S-2.0 for hardware
    Copyright (c) 2026 Dan Newcome.
    - LICENSE: GPL-3.0 text (verbatim from gnu.org) for both firmwares, the
    simulator, tests and tools. The A1S firmware links GPL-3.0 libraries
    (arduino-audio-tools, -driver, -libhelix), so its binaries were GPL
    already.
    - p4/deck/hardware/LICENSE: CERN-OHL-S-2.0 text (verbatim from ohwr.org,
    matches SPDX) for the enclosure CAD, generated STLs, renders and
    hardware docs.
    - COPYRIGHT.md: which licence covers what, the notices, the source
    location (CERN-OHL-S section 4), third-party code (minimp3 CC0 bundled;
    build-time deps and their licences), the xwax clean-room note, and
    t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
2026-11-01 Add SPDX licence lines to source files
    Two lines at the top of 87 files (after any #! line):
    SPDX-FileCopyrightText: 2026 Dan Newcome
    SPDX-License-Identifier: GPL-3.0-or-later (firmware, sim, tools)
    CERN-OHL-S-2.0 (p4/deck/hardware/cad/*.py)
    Covers .c/.cpp/.h/.py, CMakeLists.txt and platformio.ini. Skips the
    bundled minimp3 (CC0) and JSON/YAML config. Python compiles; P4 deck,
    A1S (es8388) and esp32-sim all build.
2026-11-01 p4/deck: plain CUE/PLAY caps without light rings
    play_cap_plain.stl / cue_cap_plain.stl: a 22 mm cap fills the top's
    22.4 mm hole and a 23.6 mm flange (45-degree chamfer on top, 0.2 mm
    under the top at rest) catches the underside. Same 4 mm nub, tact
    switch, shell and control board as the lit buttons, so the LEDs are
    optional; a translucent plain cap still picks up their light.
    FREEDJ_BUTTONS=plain (default lit) switches the assembly and the clash
    check. Both styles clean in both configs; parts watertight, one body.
2026-11-01 p4/deck: CDJ-style tempo knob
    Replaces the plain rounded block: 14 mm across the slot, tapering from an
    11 mm base (1.2 mm straight foot) to a 12 x 5.5 mm flat top, 10 mm tall,
    concave finger scoops (R14, 1.3 mm deep) front and back, rounded top
    edges, index line across the top centre. Same lever socket. Clash-checked
    in both configs; watertight, single body. Render 0033.
2026-11-01 p4/deck: CAD follows the control board's real parts
    TACT 12x12x7.3 -> 6x6x7.5 SMD (ZX-QC66-7.5TP, C7470157); the board drops
    0.2 mm and the ring skirts follow. Connectors move to their PCB positions
    (fader and AS5600 on the right edge, the host cable off the back edge) and
    J_ENC goes to 5 pins (3V3, GND, DIR, SCL, SDA). Skirt notches widen to
    3.6 mm to clear the 0805 LED pads. Clash check clean in both configs with
    lit and plain buttons.
2026-11-01 p4/deck: control board PCB, CH32V003 I2C target, routed and DRC-clean
    hardware/ctrl-pcb: tscircuit design, 42 x 58 mm, 2 layers, under
    CUE/PLAY. A CH32V003F4P6 (C5187096; 26k in stock, ~$0.29) is the I2C
    target that does the fader ADC, button debouncing and 8 individually
    driven ring LEDs. The ATtiny1616/1626 had only 47-108 in stock. The
    AS5600 shares the bus through J_ENC.
    Top side, all SMD for one-side assembly: two 6x6x7.5 tacts (diagonal
    pads), 4 x 0805 LEDs per ring on r 11.3 (green 100R / amber-yellow
    470R), a resistor per LED inside the ring skirt, the MCU and passives.
    Bottom: JST-XH for the host (3V3 GND SDA SCL INT), AS5600 (3V3 GND DIR
    SCL SDA), fader (3V3 wiper GND), and SWIO p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
2026-11-01 p4/deck: populated control board test fit, STLs and renders
    cad/ctrl_fit.py places the populated control board in the deck. The
    source is tscircuit's GLB export, which has the real JLCPCB/EasyEDA part
    models; its STEP export can't merge them. The board is registered on its
    own origin (deck CTRL_XY centre, top face at CTRL_Z), not a bounding box.
    The switch model is wrong (ZX-QC66-7.5TP drawn 5.0 mm, the part is
    7.5 mm), so its body is replaced with 6x6x3.5 plus an actuator to 7.5.
    Writes test-fit STLs: the deck frame for each config, and the board
    alone. Clash check (convex hulls vs shell, rings, caps, base): 0 in both
    configs with lit and plain buttons; raising the board 1 mm is reported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
2026-11-01 p4/deck: printable control board stand-in for test fits
    ctrl_fit.py also writes build/ctrl_board_print.stl: the real 1.6 mm
    plate with its screw holes, plus every top-side part as its convex hull
    (switches at their true 7.5 mm), without the connectors. One watertight
    body, 42 x 58 x 9.1 mm, bottom on z 0, so it prints flat with no
    supports.
2026-11-01 p4/deck: rear USB-A slots 0.5 mm wider (0.75 per side) for the flared shells
    The dev board's USB-A shells flare at the mouth; the first print needed
    0.25 mm filed off each side of both slots. Height unchanged. Webs left:
    3.4 mm between the slots, 3.1 mm to the Ethernet opening. Shells rebuilt
    (angled + flat), watertight, 1 body.
2026-11-01 p4/deck: optional Pioneer-style platter from freedj-3000's jog wheel, sized to the 104 mm well
    freedj-3000's jog_wheel.py profile at 100 x 10 mm (was 206 x 18): dished
    centre = touch plate seat (80.4, 1.2 deep), 3.8 mm skirt that locates the
    r 38-46 inertia ring (0.2 clearance, ring 1 mm up inside the skirt),
    3 x 0.8 mm grip grooves, 24 mm hub. Same printed 7.95 shaft and r 6
    inner-race spacer as jog.py, so bearings/magnet/AS5600 are unchanged.
    35 cm3 vs 61 for the knurled one; 1 body, watertight, angled + flat.
    FREEDJ_PLATTER=pioneer selects it in machine.py: 0 clashes in both shells.
2026-11-01 p4/deck: Pioneer platter reshaped to the reference mesh: flat top, 2.5 mm band, 24 dimples
    Follows meshy_1788016598940.glb with the dome flattened and the band
    thinned (2.5 mm vs ~3.3 scaled). Shoulder: R6 round then 45 deg from
    r 50 to r 45 (prints top-down unsupported), 24 x 12x8 mm dimples
    1.1 deep. Flat land r 40.2-45 around the 80.4 touch-plate seat.
    Inertia ring at z 0-5; hollow 2.6 mm from the deepest dimple.
    37.7 cm3, 1 body, watertight, angled + flat, 0 clashes in both shells.
2026-11-01 p4/deck: jog shaft 8.0 mm (was 7.95, loose in the 608s); fit gauge 7.95-8.10
    Both platters (knurled + Pioneer, angled + flat) rebuilt: 1 body,
    watertight. Fit-gauge pins shifted +0.05: 7.95 / 8.00 / 8.05 / 8.10.
2026-11-01 p4/deck: magnet pocket Ø6.05 (was 6.16), a light press fit
    The magnet fell out of the Ø6.16 pocket before the E6000 set. New
    MAGNET_FIT = 0.05 over the 6 mm magnet; 0.98 mm of shaft wall left.
    All four platters (knurled + Pioneer, angled + flat) rebuilt: 1 body,
    watertight.
2026-11-01 p4/deck: AS5600 jog encoder over I2C (500 Hz, core 0), analog fallback on pin 7
    New main/as5600.cpp sends DJ2Go-style Jog events, 180 ticks/turn.
    I2C 0x36 on the codec/touch bus (pins 3/5), status every 100 ms,
    re-seed after magnet loss, whole-tick hysteresis. Analog fallback
    (GPIO 23) when nothing answers: 2 reads/sample, 13 ms smoothing.
    Bench: ±1 count at rest on I2C vs ±40 on the ADC, 0 drift ticks,
    177 us per read; tracked both ways through the wrap. Serial keys
    e (readings) and E (magnet status: detected/weak/strong, AGC,
    magnitude, angle, output config).
2026-11-01 p4/deck: TODO: touch back alongside the AS5600 on I2C; set the magnet gap (33 dropouts/30 s)
2026-11-01 p4/deck: plan release 1 with no custom boards: 2 panel buttons + pot on 5 P4 pins, control board later
2026-11-01 p4/deck: BUILDS: buttons sized like the printed ones: 16 mm flat-head ring-LED (~19 head, ~20 nut, ~20 deep) fits 24 mm centres and 27 mm depth
2026-11-01 p4/deck: BUILDS: release 1 drops the button LEDs: 3 P4 pins (2 buttons + pitch ADC), ~9 conductors
2026-11-02 p4/deck: serial R dumps 4 s of raw AS5600 angle (2000 samples at 500 Hz); spinning: 0 lost, 0 jumps, 2.6-count jitter
2026-11-02 p4/deck: magnet is 3x1 mm (was guessed 6x1.6): pocket 3.05x1; 3 one-inch gap test shafts (1.1/0.8/0.5 mm)
2026-11-02 p4/deck: magnet pocket 3.25 (3.05 printed tight); magnet_gauge.stl with 4 holes 3.1-3.4
2026-11-02 p4/deck: jog shaft 8.1 mm (8.0 still loose in the 608s); fit gauge 8.05-8.20
2026-11-02 p4/deck: CHANGELOG: flat shell takes the _flat jog files (shaft 27.0 = measured 1-1/16"; angled 23.0)
2026-11-02 p4/deck: jog test discs 2 mm thick (was 4), label 0.4 deep
2026-11-02 p4/deck: magnet is 4x1 mm (not 3): pocket 4.15; magnet gauge 4.1-4.4
2026-11-02 p4/deck: jog filter for a noisy AS5600 (±100 counts at rest): adaptive 1-25 Hz smoothing, 3-tick start deadband, 2 reads/sample; 0 stray ticks in 20 s
2026-11-02 p4/deck: TODO: restore jog feel on final hardware (sensor ±100 vs ±1; filter adds 3-tick deadband)
2026-11-02 p4/deck: tools/jog_filter_sim.py: replay R captures through the jog filter (3 settings, stray ticks + spin tracking)
2026-11-02 p4/deck: jog direction flipped: clockwise advances the track (kDirection -1)
2026-11-02 p4/deck: magnet 4x2 mm: pocket 4.15 x 2.1 deep (0.1 glue allowance); magnet gauge 3.1 thick
2026-11-02 p4/deck: platter 1 mm higher (hub spacer 1.5, was 0.5: rim scraped when pressed); shaft 28.0 flat / 24.0 angled, tip unchanged
2026-11-02 p4/deck: jog noise causes: DIR floating + speaker next to the AS5600; recheck kDirection once DIR is grounded
2026-11-02 p4/deck: jog direction back to +1: the earlier flip was DIR floating; grounded DIR reads right
2026-11-02 p4/deck: README: with the XDJ attached, audio plays out of the XDJ (its USB sound card), P4 output silent
2026-11-02 p4/deck: TODO: MENU option to switch the speaker/line out off (USB copy stays)
2026-11-02 p4/deck: MIXER.md: plan for a one-platter mixer build: per-deck EQ/filter/CUE/PLAY on the edges, 13 analog via a 16-ch mux, PCM5102A cue out, core 1 ~55-60 %, ~180-200 mm wide
2026-11-03 p4/deck: CUE/PLAY on GPIO 24/25 and pitch pot on GPIO 22, no control board; pot noise +-60 raw -> 0 sends at rest (was ~100/s), 8x oversample @50 Hz, adaptive low-pass, 12-count threshold; serial P
2026-11-03 p4/deck: pitch fader reversed (kPotReverse): push away = slower, as on a CDJ
2026-11-03 p4/deck: printable button plate (button_plate: board outline + screw holes, locating frames and leg holes for 2 THT 6x6x7.5 switches) and tools/wiring_diagrams.py (header map + 3 harness SVGs: 8 + 5 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
2026-11-03 p4/deck: wiring diagrams: touch on the screen harness (11 wires: CTP_SCL pin 5, CTP_SDA pin 3, CTP_RST pin 21), 900 px wide
2026-11-04 p4/deck: platter held captive by a DIN 6799 size-6 e-clip: lower 608 up 3.9 mm (z 10.0 -> 13.9), groove at 13.10-13.85 (6.0 dia), 1.5 mm cap over the magnet; bearing span 22.1 flat / 18.1 angled (was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
2026-11-05 p4/deck: Link: report our USB/SD slots empty (status 0x6a/0x6b/0x6f/0x73 = 0x04, 0x75 = 0): the XDJ-1000MK2 listed our USB under LINK and gave a link error browsing it
2026-11-05 p4/deck: DJ2Go pitch bend - = key lock, + = beat meter view (bar boxes / phase ticks); were loop in/out. deck::Type::MeterView, toggled on the USB task (audio task never takes the LVGL lock)
2026-11-05 p4/deck: TODO: measure sync bend smoothing (kSyncBendSmooth 0.02 ~0.3 s) vs off/0.1 and cut the lag
2026-11-05 p4/deck: CAD: FREEDJ_SCREEN=2.8 for the 2.8" MSP2834 (ILI9341V, 50 x 86 board, 69.2 x 50 glass): deck 160 x 174.1 angled / 175.4 flat (was 184.7 / 186); M2.5 in 5.6 mm screen bosses, 0.6 clear of the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
2026-11-05 p4/deck: CONFIG_FREEDJ_SCREEN_PREVIEW: 2.8" layout (320x240) in the top-left of the 4" ST7796S, pitch 0.174 vs 0.180 mm; rest of the panel blanked once; build28p/, 1,491,264 B
2026-11-06 timecode decoder builds without Arduino: logging/clock shim (Serial.printf/millis on Arduino, printf/esp_timer on plain ESP-IDF) so the P4 deck can link it; A1S build and native timecode tests unchan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
2026-11-06 p4/deck: USB audio input: UAC1 isochronous IN (2+ ch, 16/24/32-bit -> 16-bit stereo), alongside the output on the same device; prefers the output's rate (PCM2902: 44.1 kHz alt 3 over 48 kHz alt 1); 8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
2026-11-06 p4/deck: jog filter loosened, kMinCutoff 1 -> 30 Hz, kDeadband 3 -> 1 tick: R at rest reads 0 counts of spread (was ~±100); simulated first tick after a start 88 -> 38 ms, 4 Hz ±40° scratch worst lag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
2026-11-06 p4/deck: USB audio input recovers from a transfer error: the PCM2902 overflowed once after ~220 s (status 5), halting the endpoint and stopping vinyl for good; the last failed transfer now queues flu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
2026-11-06 p4/deck: vinyl needle drops: hold silent after a lift until fresh bit lock (decoder reset on landing; 12 drops: lock 104-480 ms, ~215 typical, 3 fell back to speed); re-sync 25-300 ms errors held 200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
2026-11-06 p4/deck: THRU vinyl mode: the USB interface's input straight to the output (a real record on the timecode turntable), deck bypassed and holding its place, decoder idle; chip cycles ABS/REL/INT/THRU, 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
2026-11-06 p4/deck: DJ2Go pitch bend − toggles THRU while a USB audio input streams (back to the mode it came from), for swapping records without the touch screen; key lock as before without an interface. Image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
2026-11-06 p4/deck: browse without touch: with the track list up, the jog scrolls it (30 rows/turn) and PLAY loads on release; hold PLAY + jog brings the list up from anywhere (first tick undoes the press). Ima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
2026-11-07 p4/deck/cad: 3.2" screen adapter for the 4" shell (LCDwiki MSP3223 / Hosyond 3.2" IPS capacitive): mounts on the 4" screen bosses, fills the 4" window down to the 3.2" active area (lines up within 0.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
2026-11-07 p4/deck/cad: compact A1S deck (FREEDJ_BOARD=a1s): ESP32-A1S Audio Kit + 2.8", 80 mm platter, 140 x 154.1 x 32 mm angled / 155.4 deep flat (P4 2.8": 160 x 174.1 x 34); jacks out the rear, micro-USBs o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
2026-11-07 p4/deck/cad: panel-mount buttons (FREEDJ_BUTTONS=panel): 16 mm panel-hole pushbuttons (0.75" top) in 16.25 mm holes, nut under the top; no control board or its bosses in this mode; buttons at x 17.5 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
2026-11-07 p4/deck/cad: SC6080GH pitch fader (FREEDJ_POT=sc6080, default on the A1S deck): same frame/holes/travel as the PTA6043; hangs on 5.2 mm pads (was 3) so its 5 mm lever foot stays under the top plate (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
